Joyedo/paraent-website-/assets/images/history-decade-2000.png

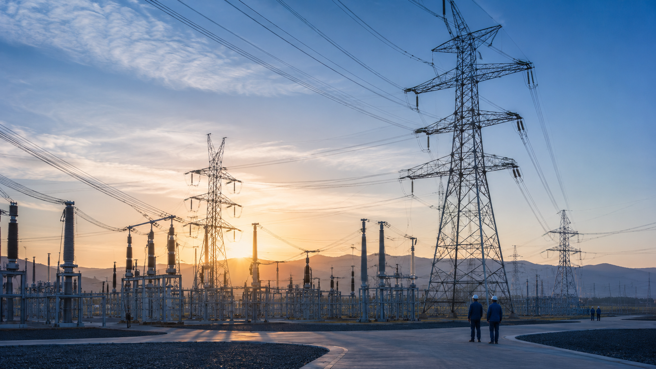
assets/images/history-decade-2000.png
