Joyedo/paraent-website-/assets/images/history-decade.png

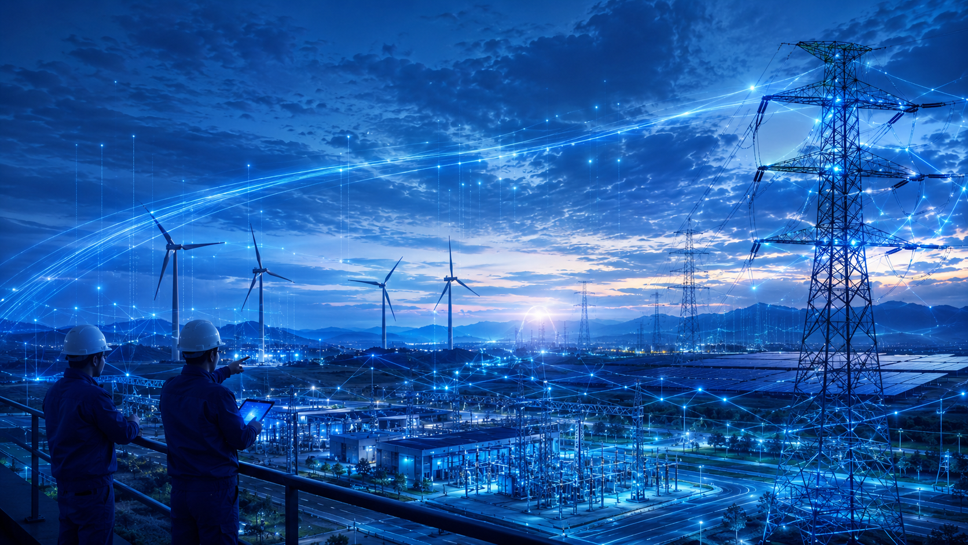
assets/images/history-decade.png
