Joyedo/paraent-website-/assets/certifications/patents/patent-design.pdf

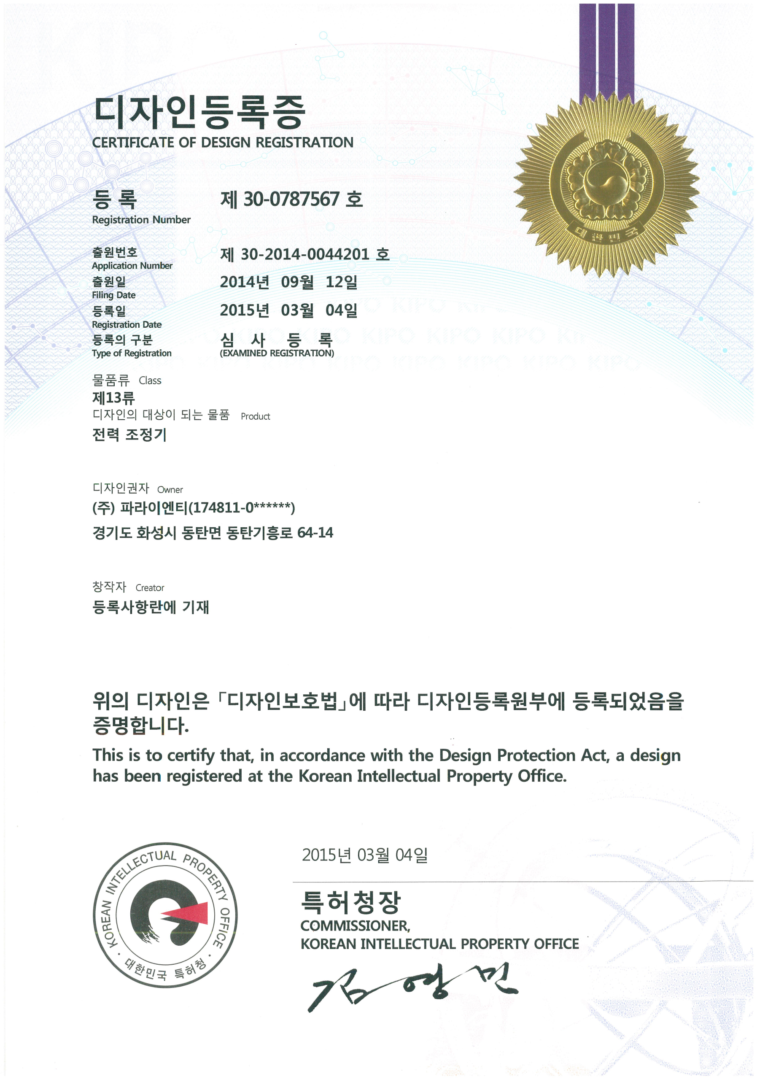
[picture p3: page 1]
