Joyedo/paraent-website-/assets/certifications/patents/patent-mpd.pdf

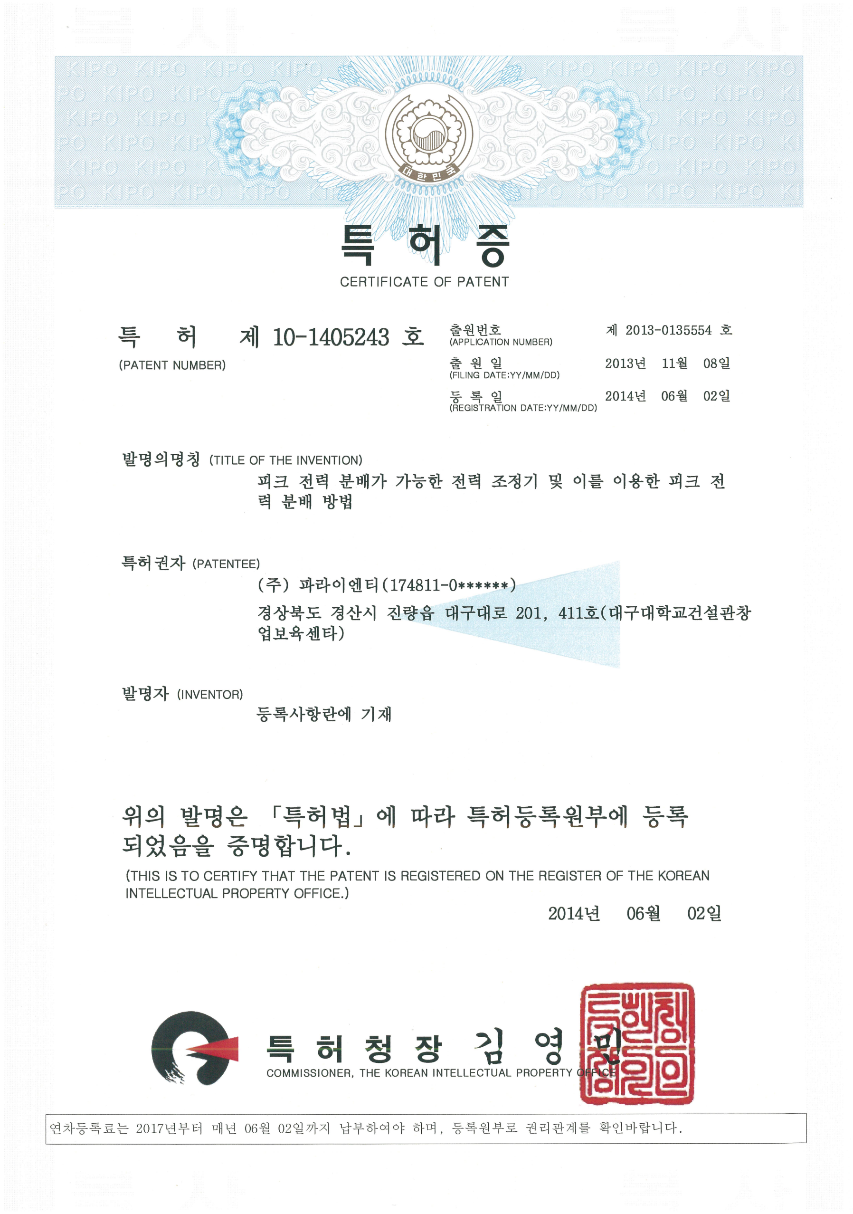
[picture p4: page 1]
