Joyedo/paraent-website-/assets/certifications/patents/patent-multichannel.pdf

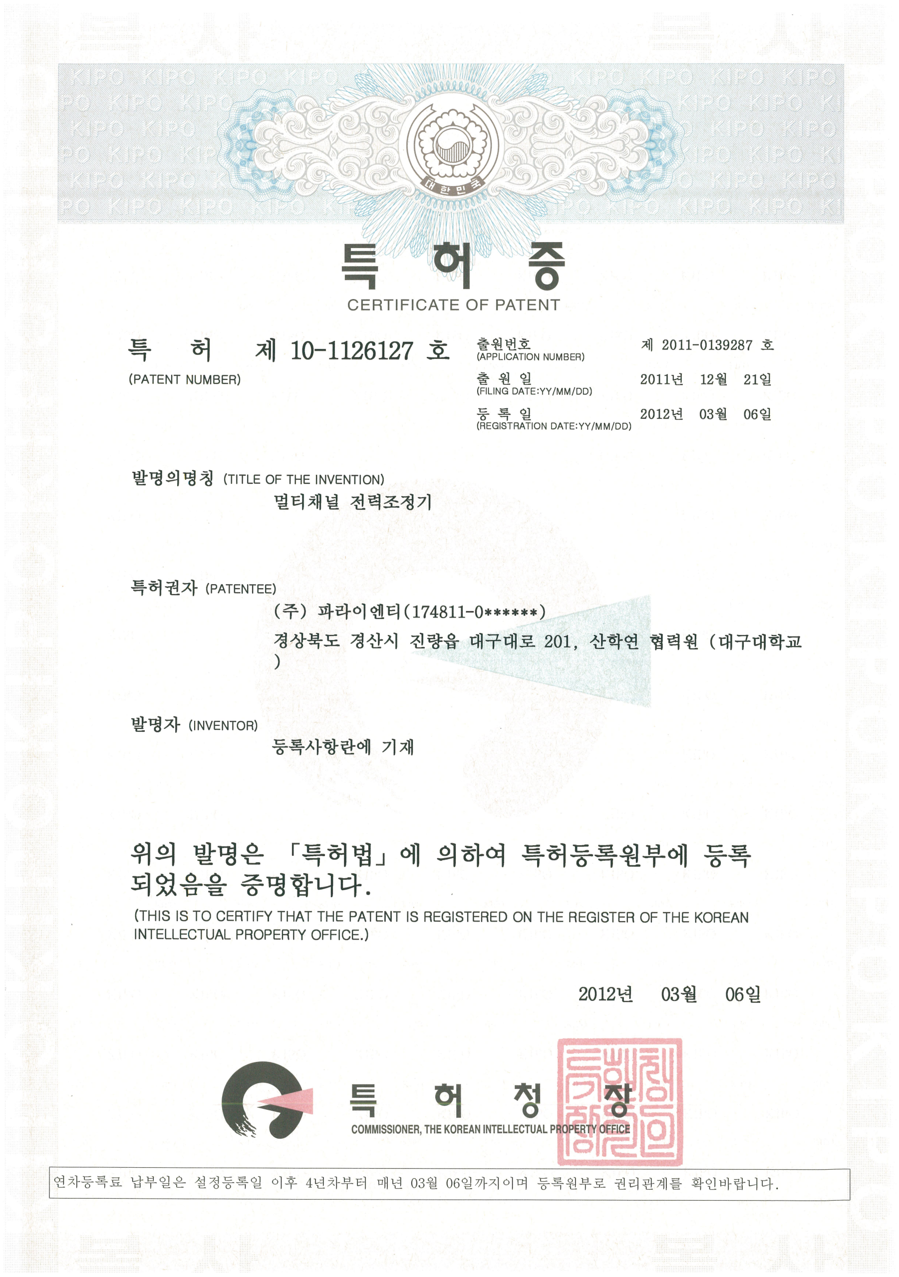
[picture p5: page 1]
