Joyedo/paraent-website-/assets/certifications/patents/patent-plf.pdf

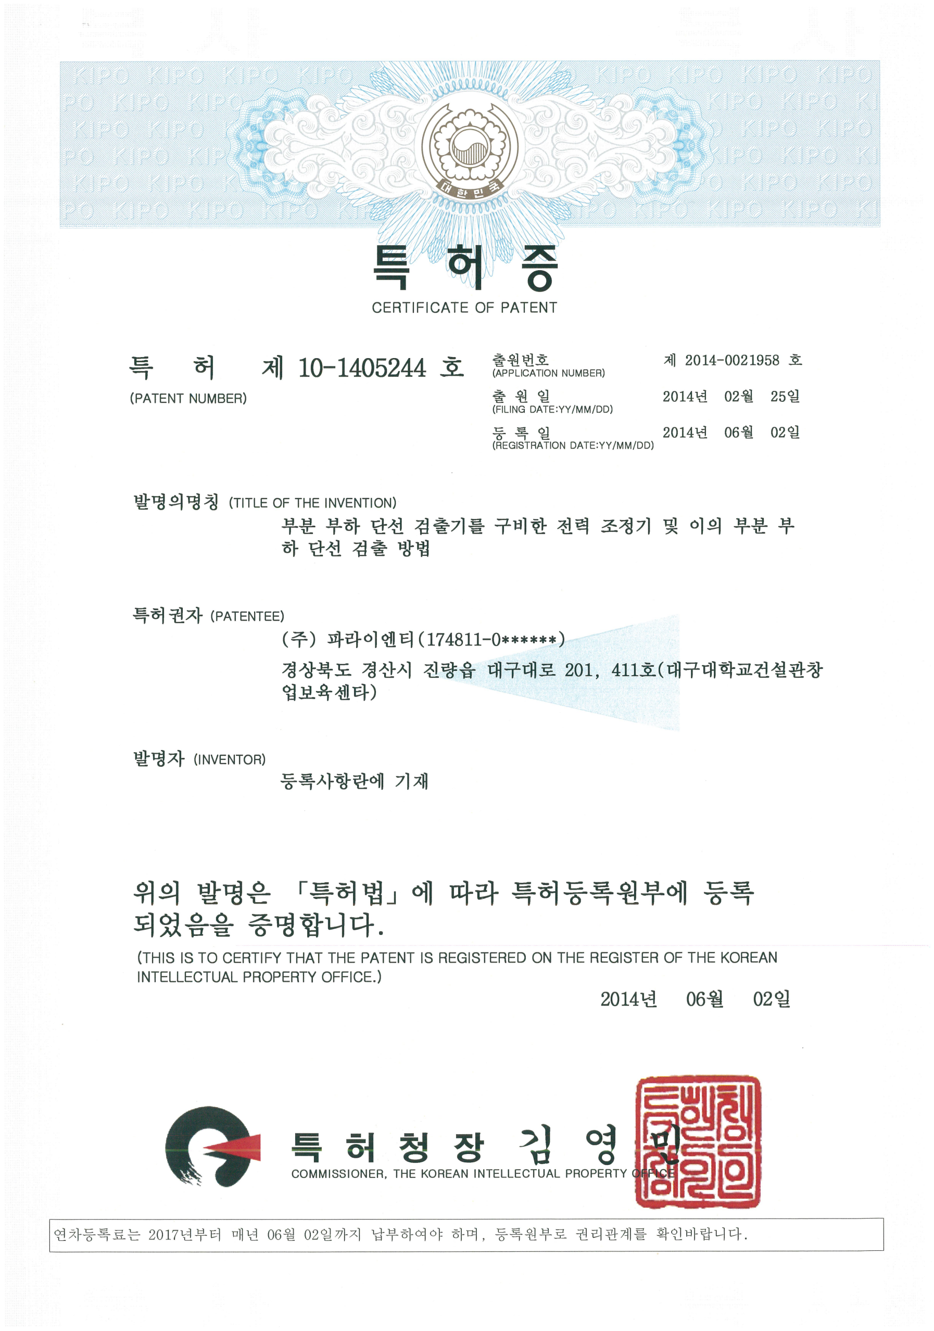
[picture p6: page 1]
