Joyedo/paraent-website-/assets/certifications/patents/patent-waveform-compensation.pdf

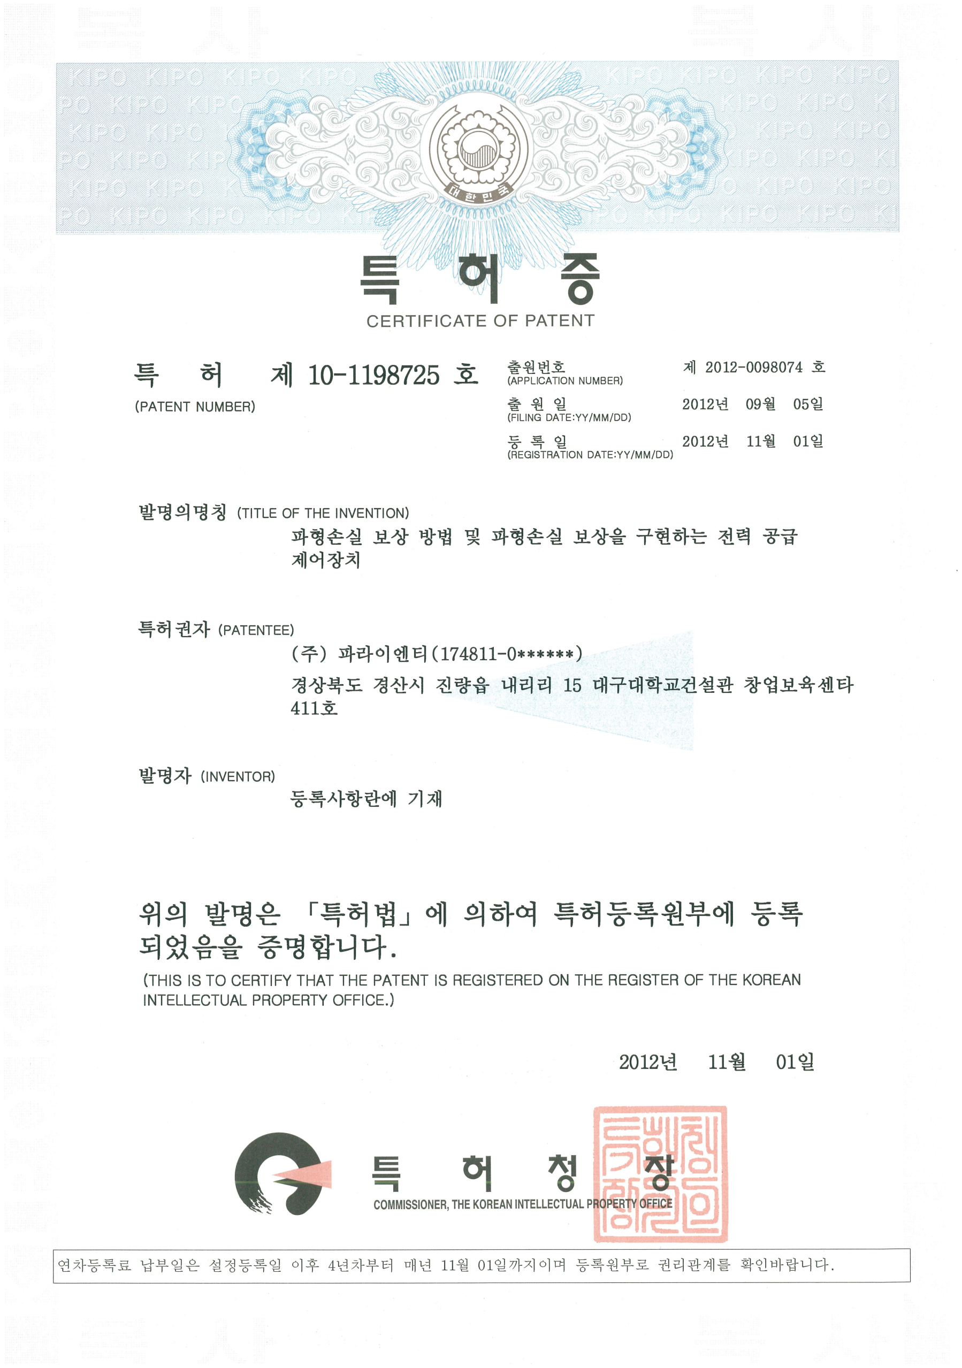
[picture p7: page 1]
