Joyedo/paraent-website-/assets/certifications/patents/trademark-en.pdf

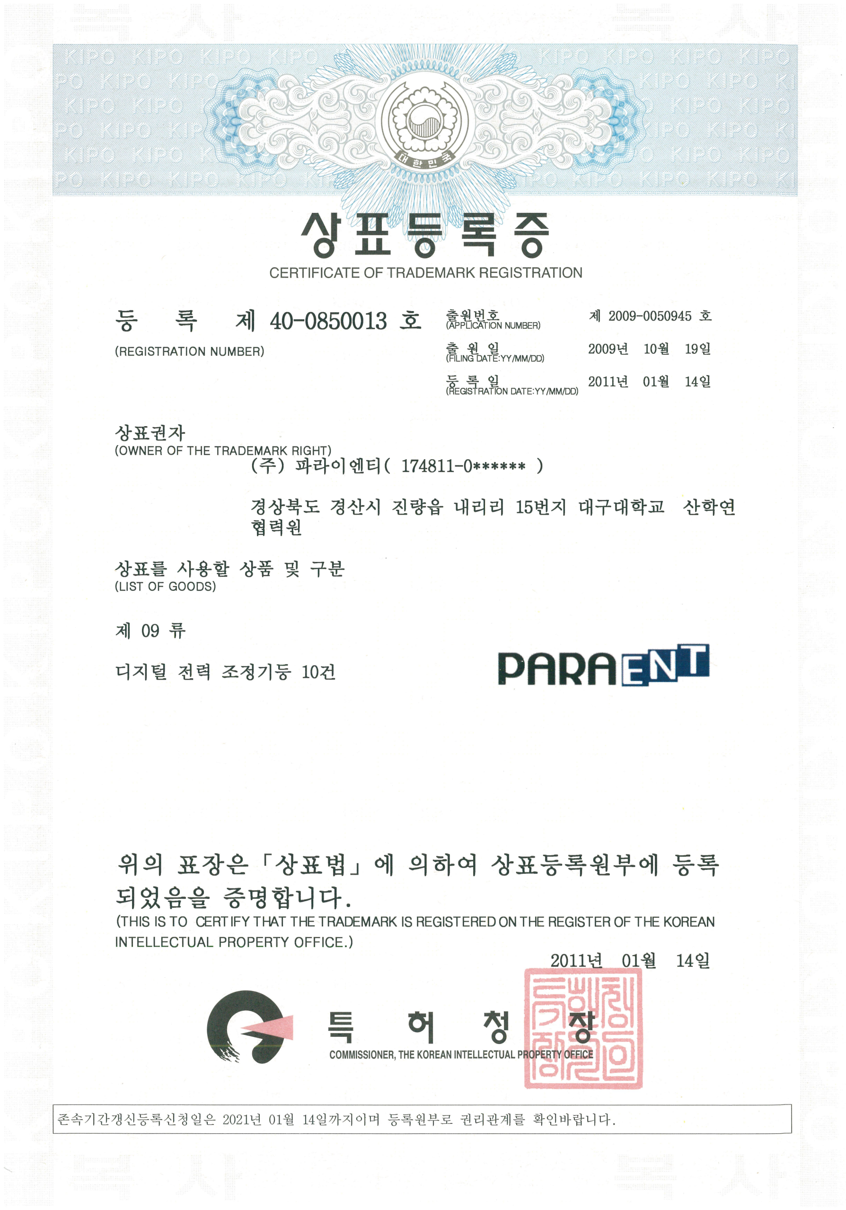
[picture p8: page 1]
