Joyedo/paraent-website-/assets/certifications/patents/trademark-ko.pdf

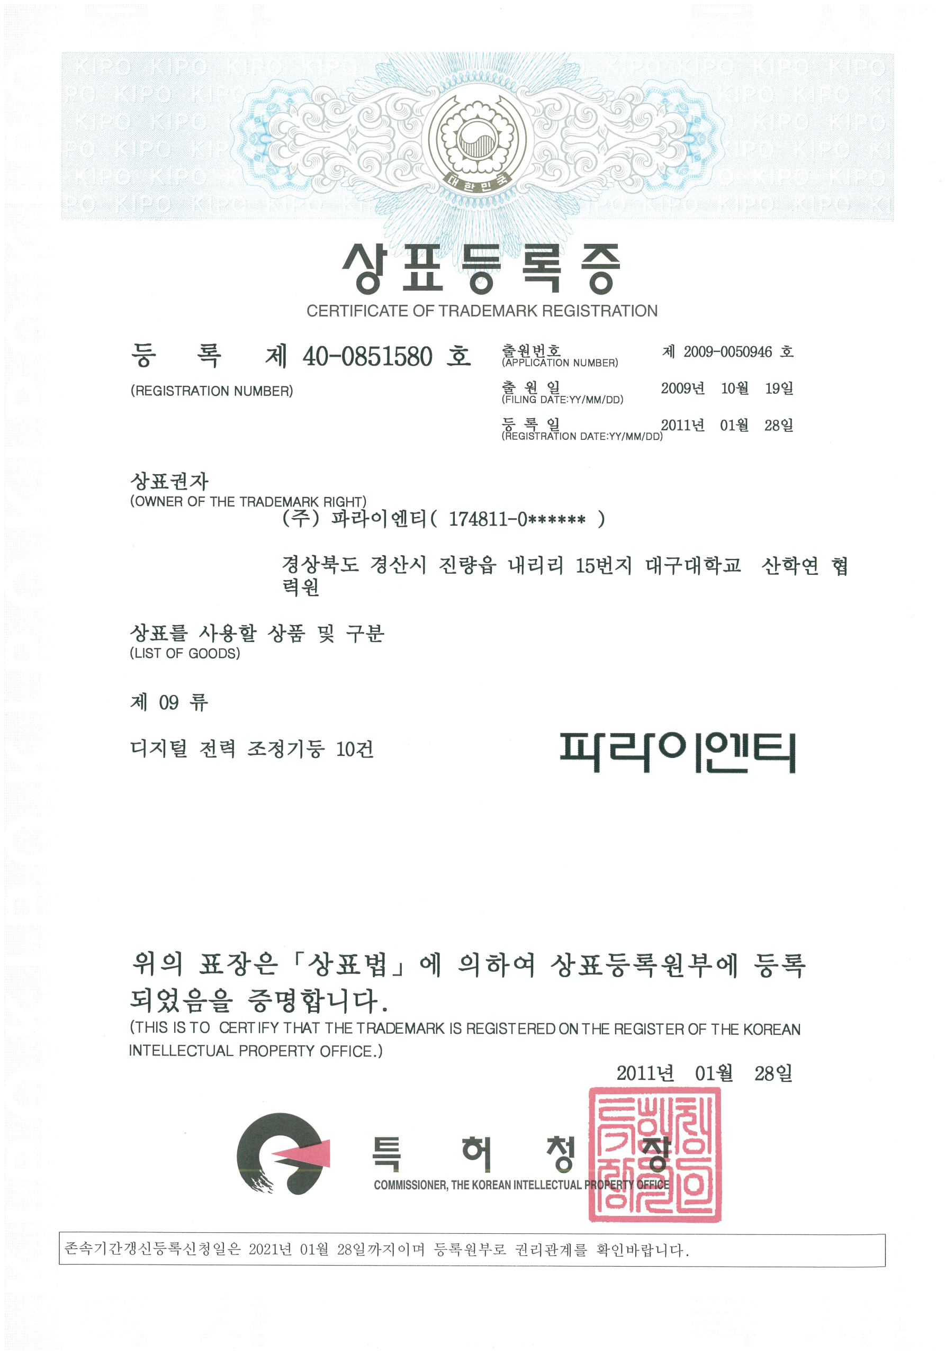
[picture p9: page 1]
