Joyedo/paraent-website-/assets/certifications/patents/patent-waveform.jpg

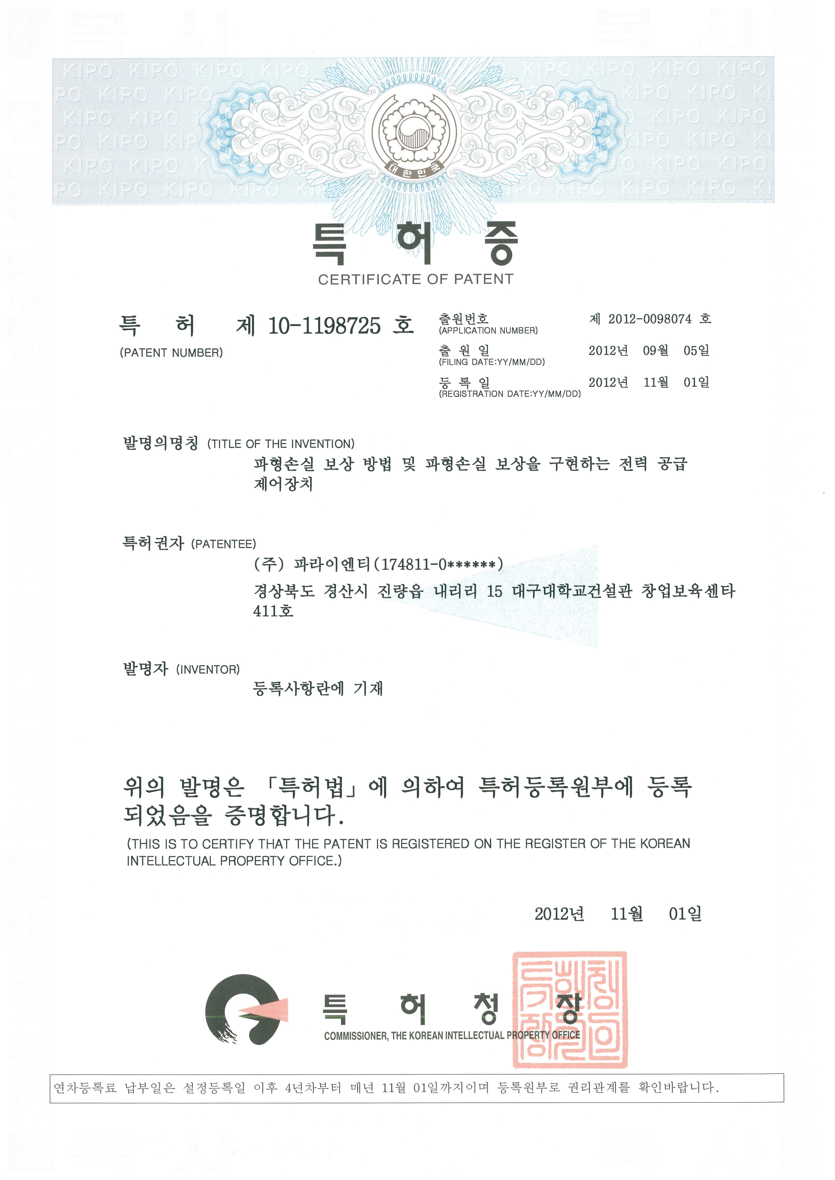
assets/certifications/patents/patent-waveform.jpg
