Joyedo/paraent-website-/assets/certifications/patents/trademark-ko.jpg

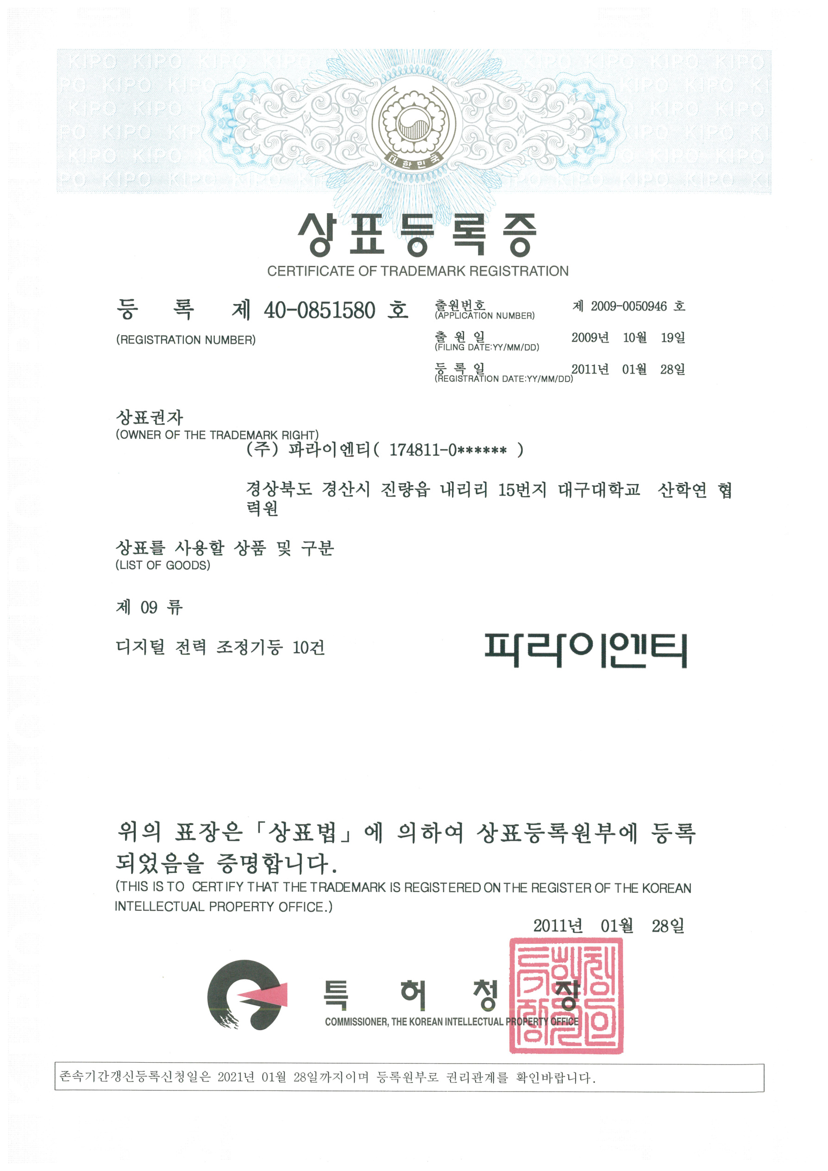
assets/certifications/patents/trademark-ko.jpg
