Joyedo/paraent-website-/assets/images/business-digital-power.png

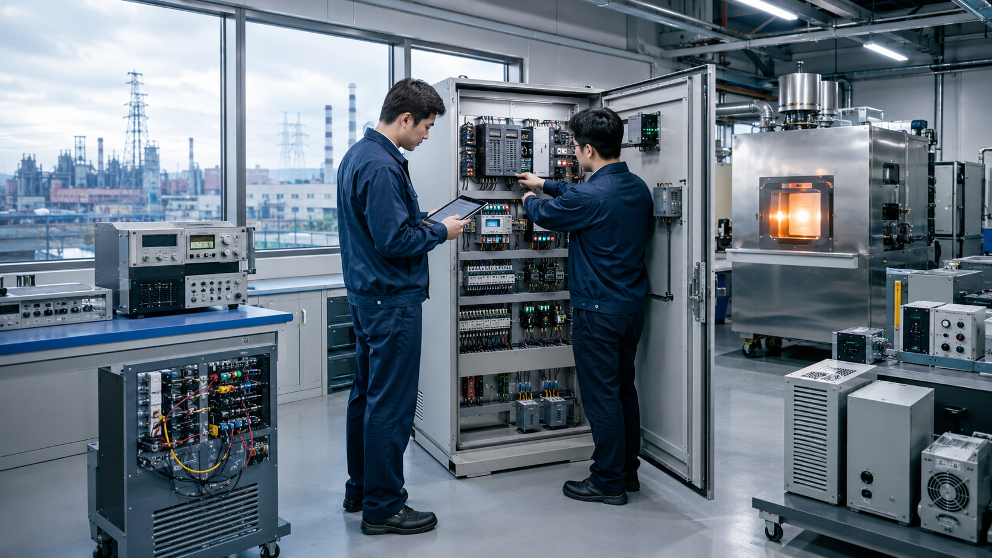
assets/images/business-digital-power.png
