Joyedo/paraent-website-/assets/images/business-power-electronics.png

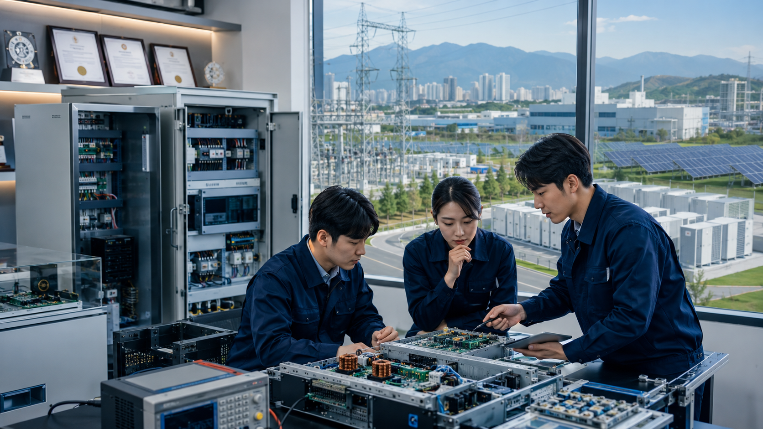
assets/images/business-power-electronics.png
