Joyedo/paraent-website-/assets/images/business-temperature-control.png

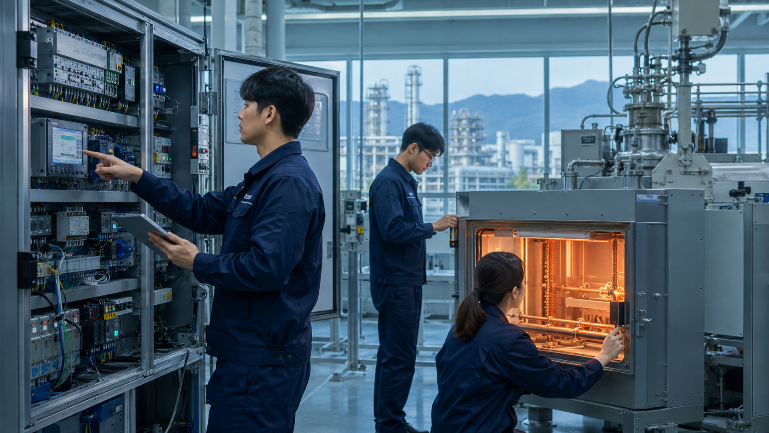
assets/images/business-temperature-control.png
