Joyedo/paraent-website-/assets/images/certifications/ce/ce-etype-1.jpg

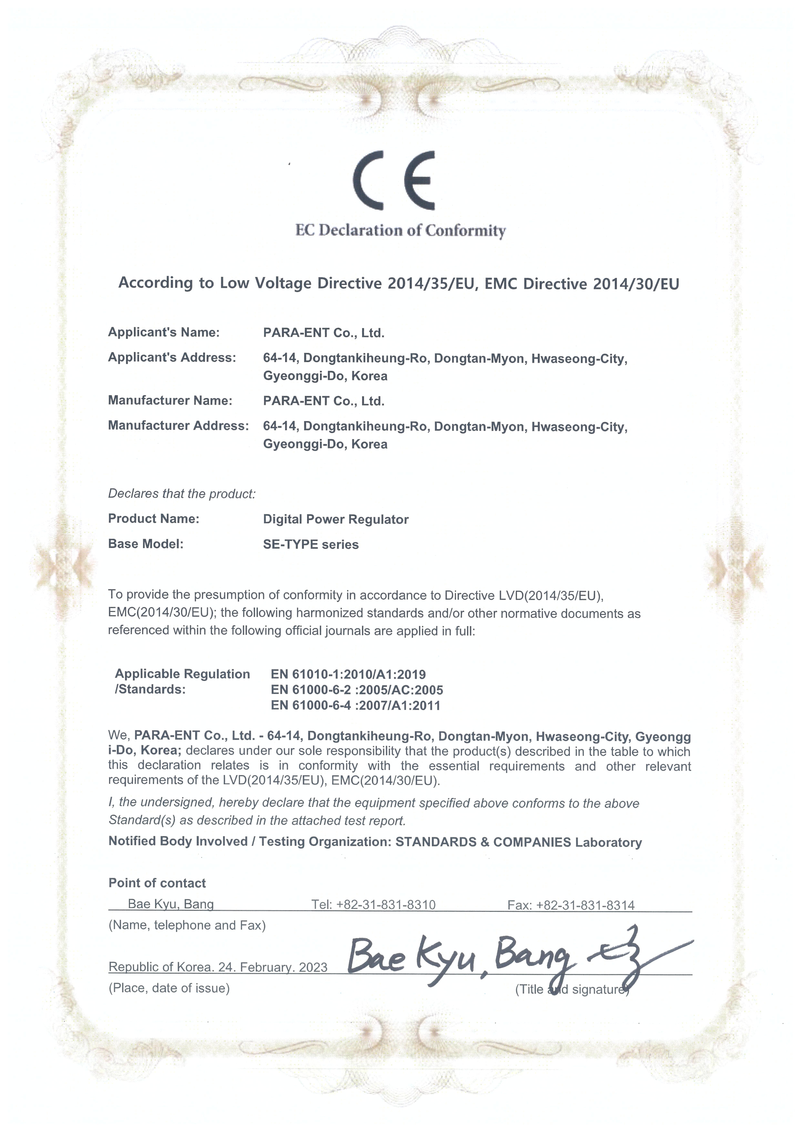
assets/images/certifications/ce/ce-etype-1.jpg
