Joyedo/paraent-website-/assets/images/certifications/ce/ce-flex-1.jpg

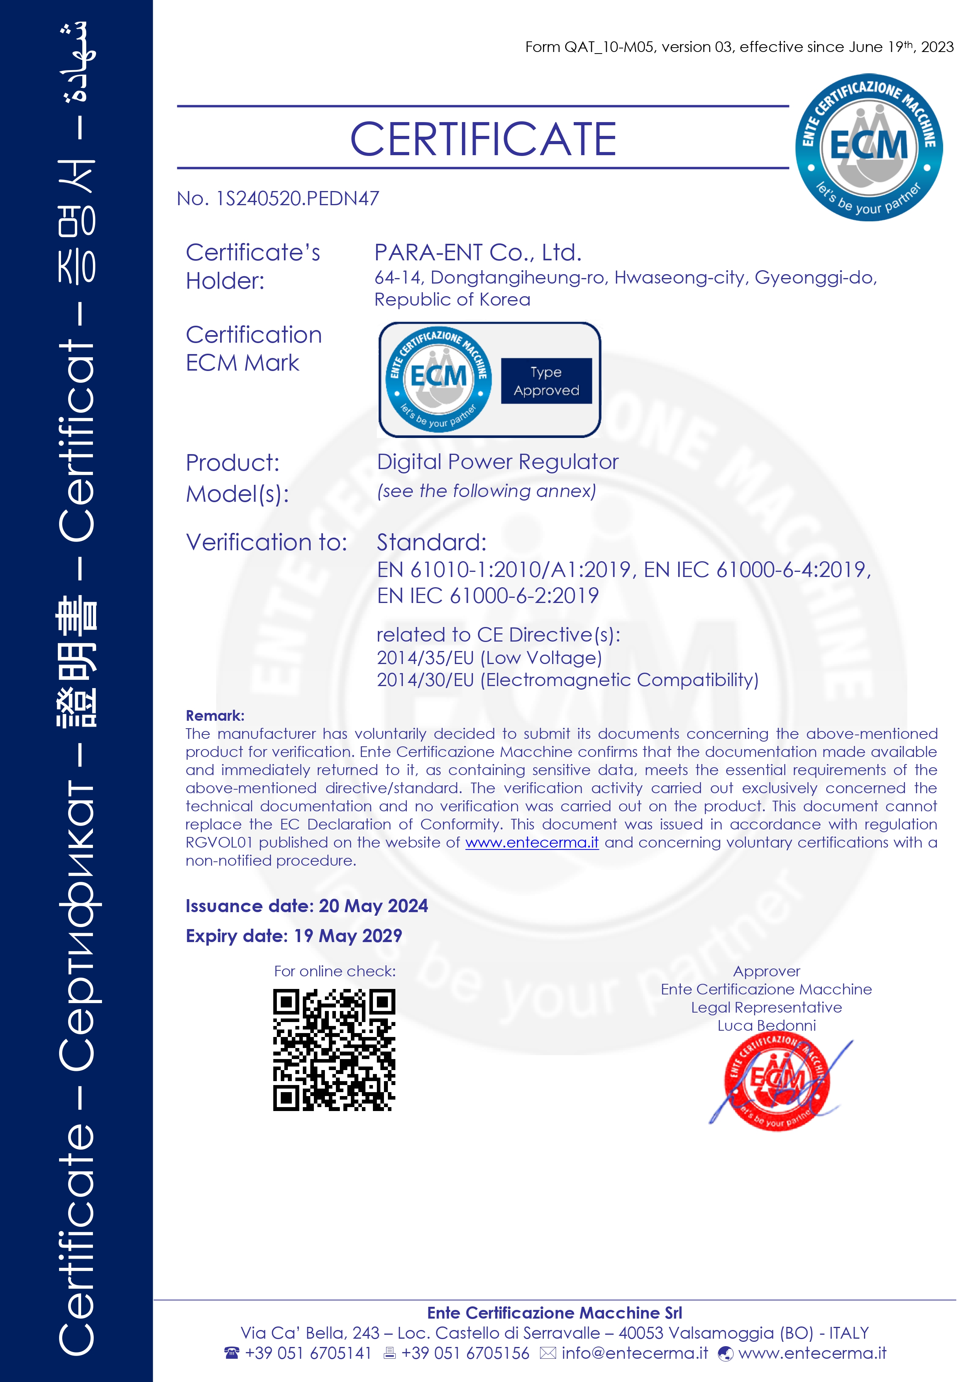
assets/images/certifications/ce/ce-flex-1.jpg
