Joyedo/paraent-website-/assets/images/certifications/ce/ce-flex-2.jpg

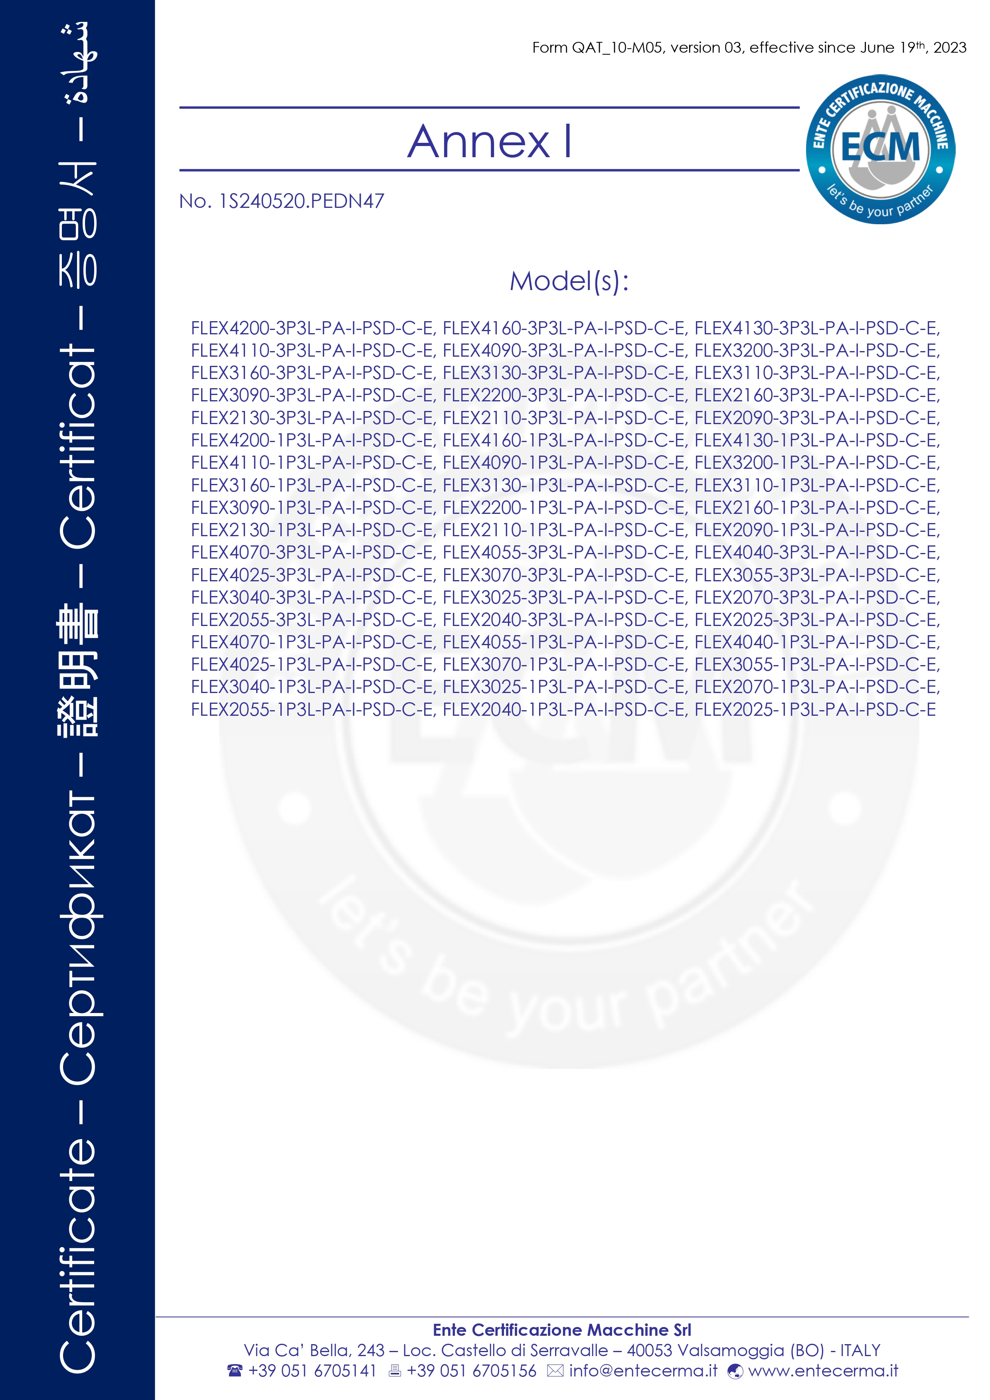
assets/images/certifications/ce/ce-flex-2.jpg
