Joyedo/paraent-website-/assets/images/certifications/ce/ce-pii-1.jpg

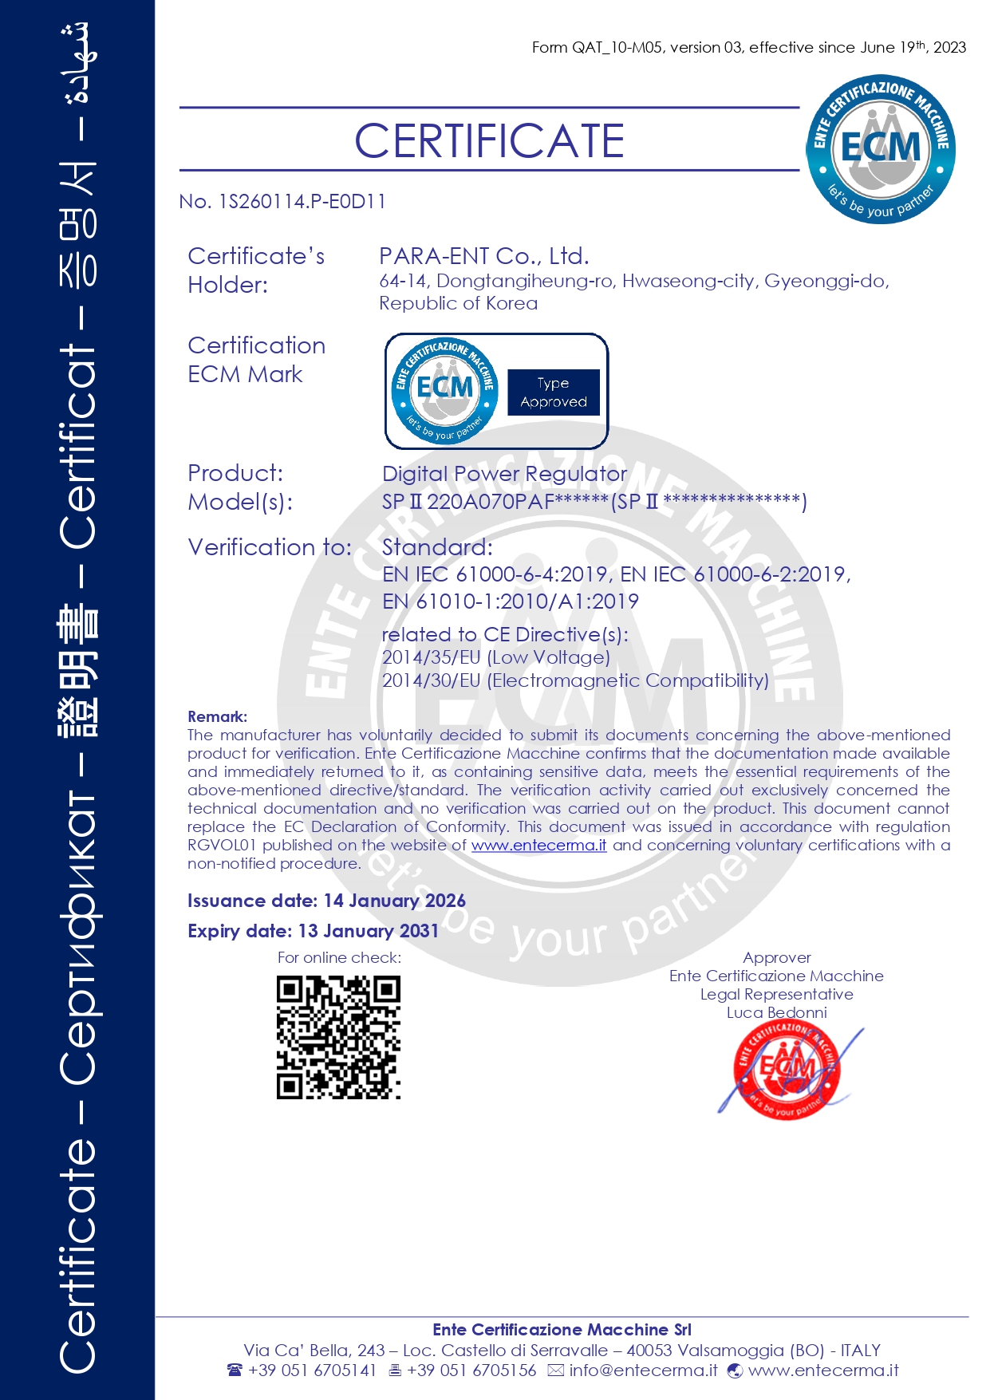
assets/images/certifications/ce/ce-pii-1.jpg
