Joyedo/paraent-website-/assets/images/certifications/ce/ce-ptype-1.jpg

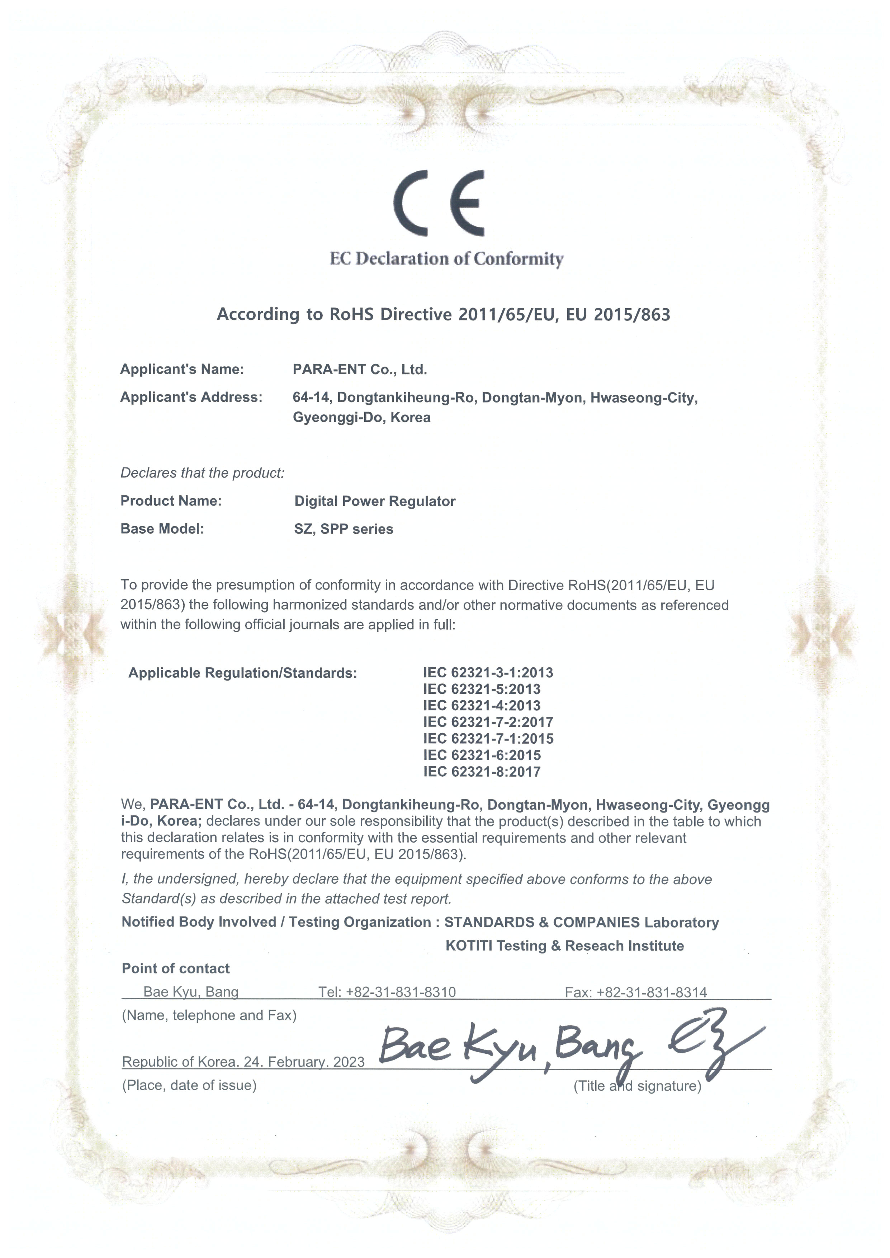
assets/images/certifications/ce/ce-ptype-1.jpg
