Joyedo/paraent-website-/assets/images/certifications/ce/ce-ptype-3.jpg

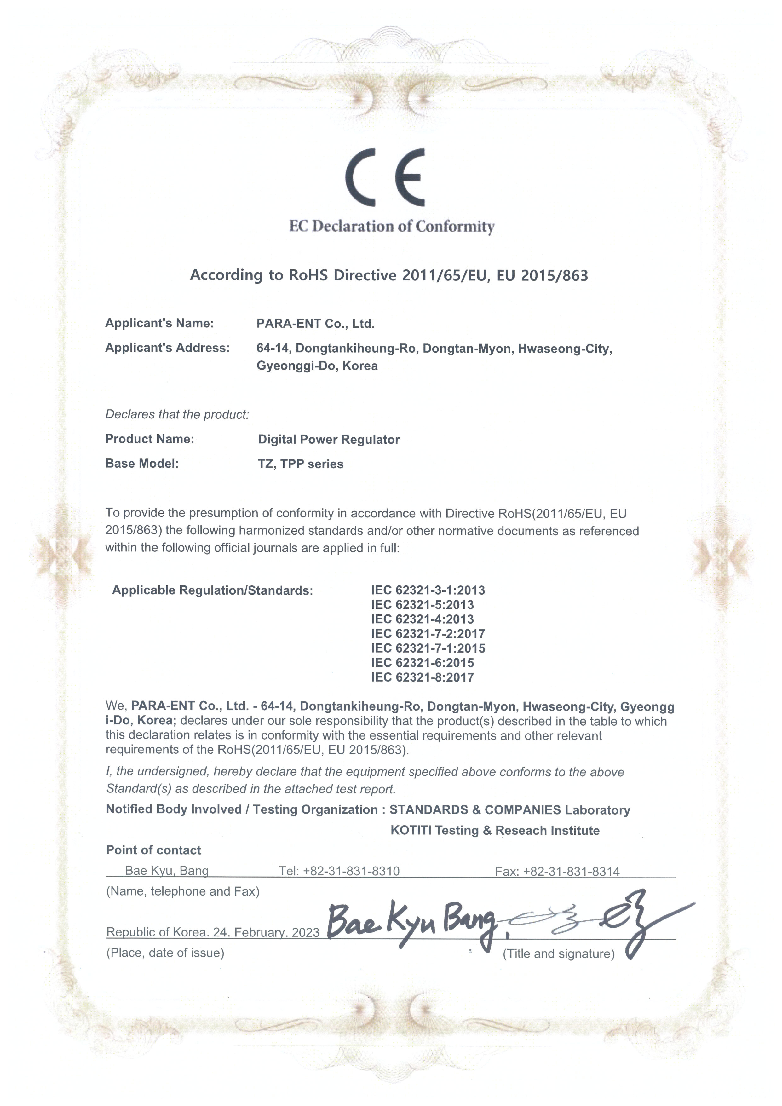
assets/images/certifications/ce/ce-ptype-3.jpg
