Joyedo/paraent-website-/assets/images/certifications/ce/ce-ptype-4.jpg

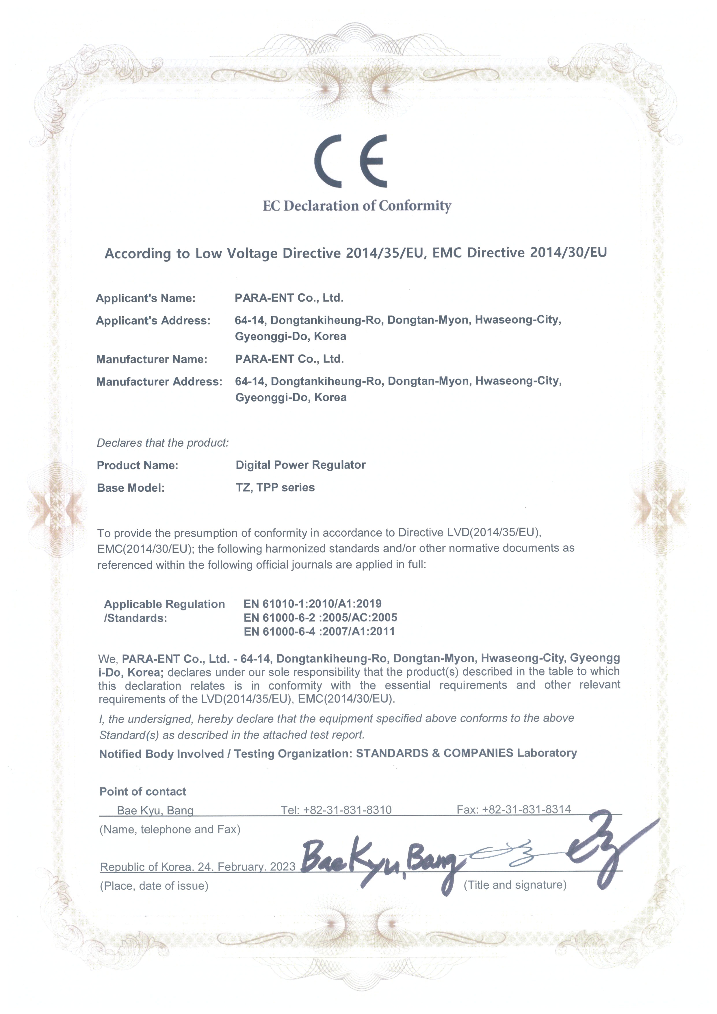
assets/images/certifications/ce/ce-ptype-4.jpg
