Joyedo/paraent-website-/assets/images/certifications/other/innobiz.jpg

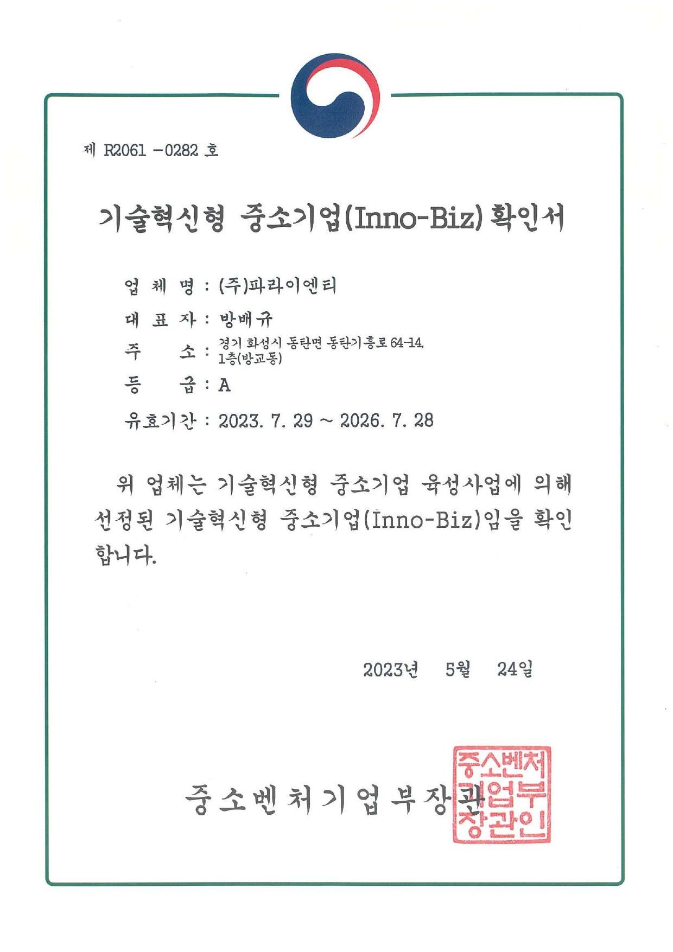
assets/images/certifications/other/innobiz.jpg
