Joyedo/paraent-website-/assets/images/certifications/other/iso-9001.jpg

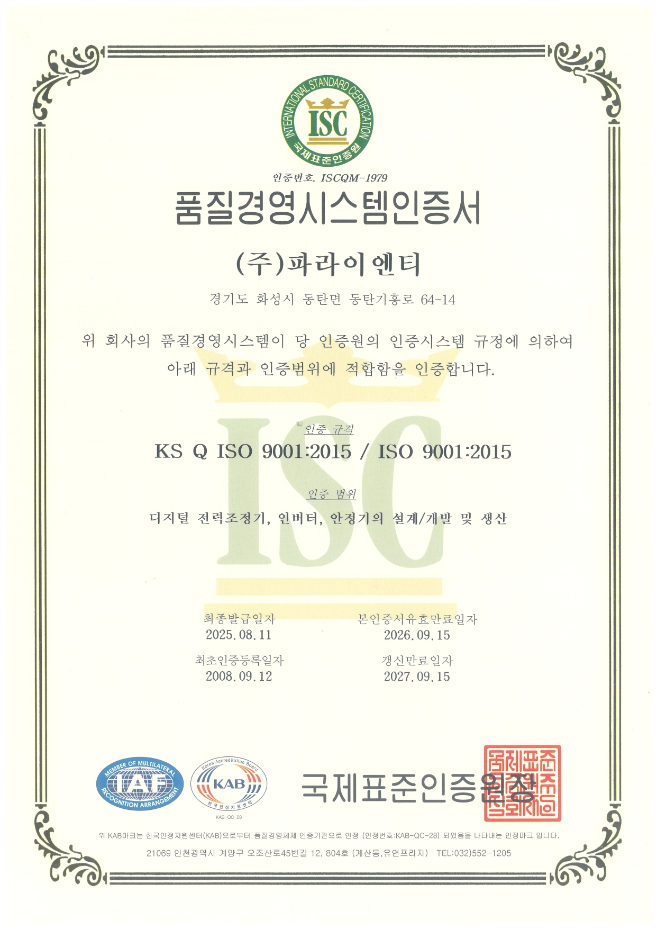
assets/images/certifications/other/iso-9001.jpg
