Joyedo/paraent-website-/assets/images/certifications/other/iso-14001.jpg

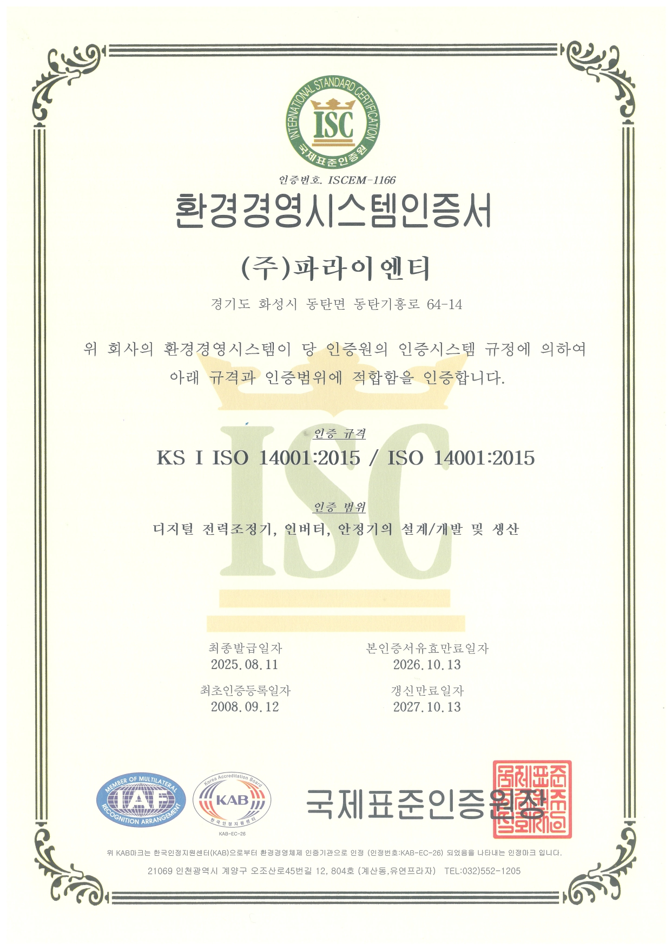
assets/images/certifications/other/iso-14001.jpg
