Joyedo/paraent-website-/assets/images/certifications/other/research-institute.jpg

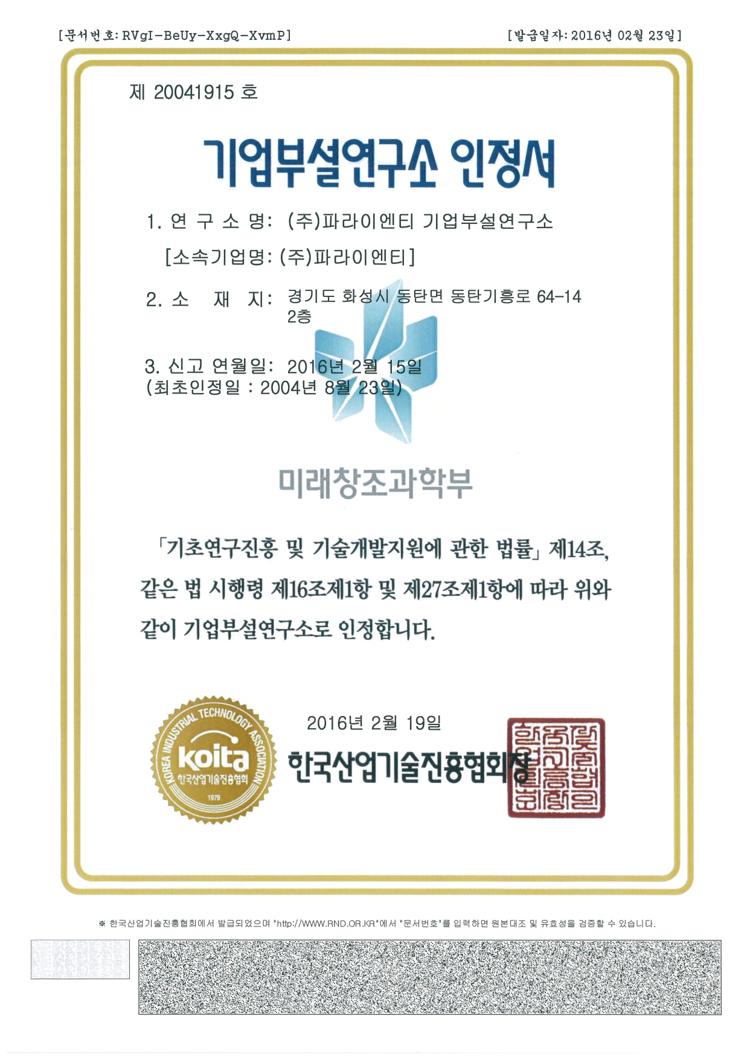
assets/images/certifications/other/research-institute.jpg
