Joyedo/paraent-website-/assets/images/certifications/other/venture.jpg

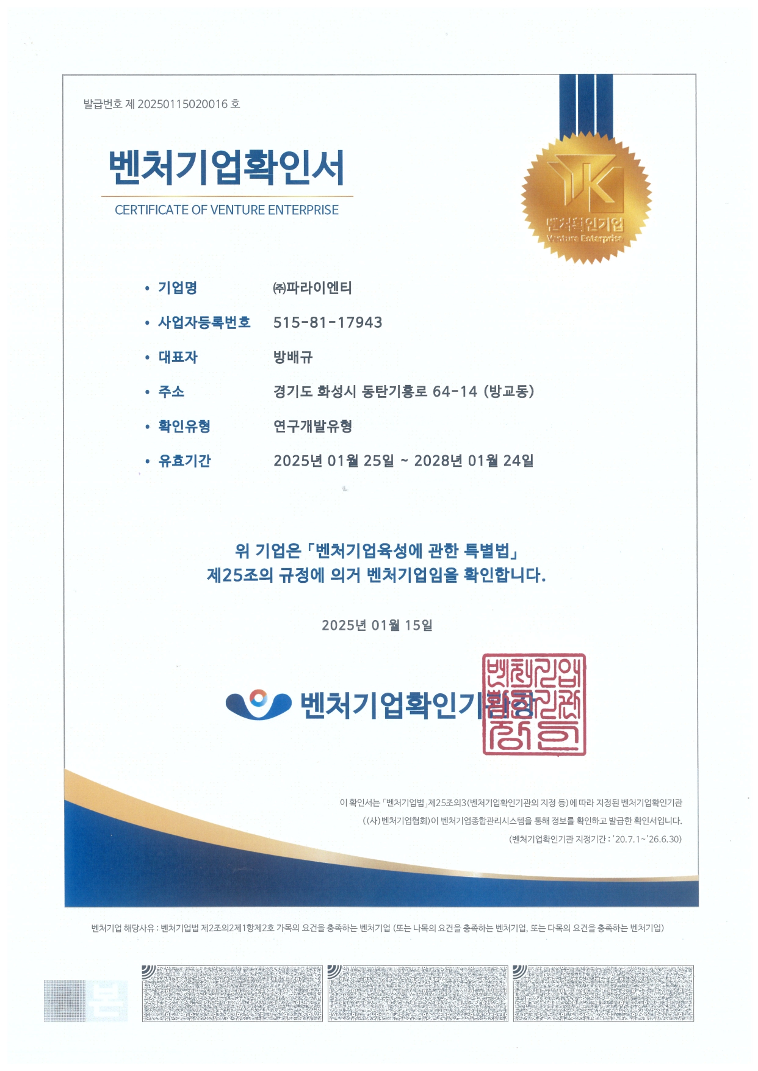
assets/images/certifications/other/venture.jpg
