Joyedo/paraent-website-/assets/images/certifications/ul/flex-ul-1.jpg

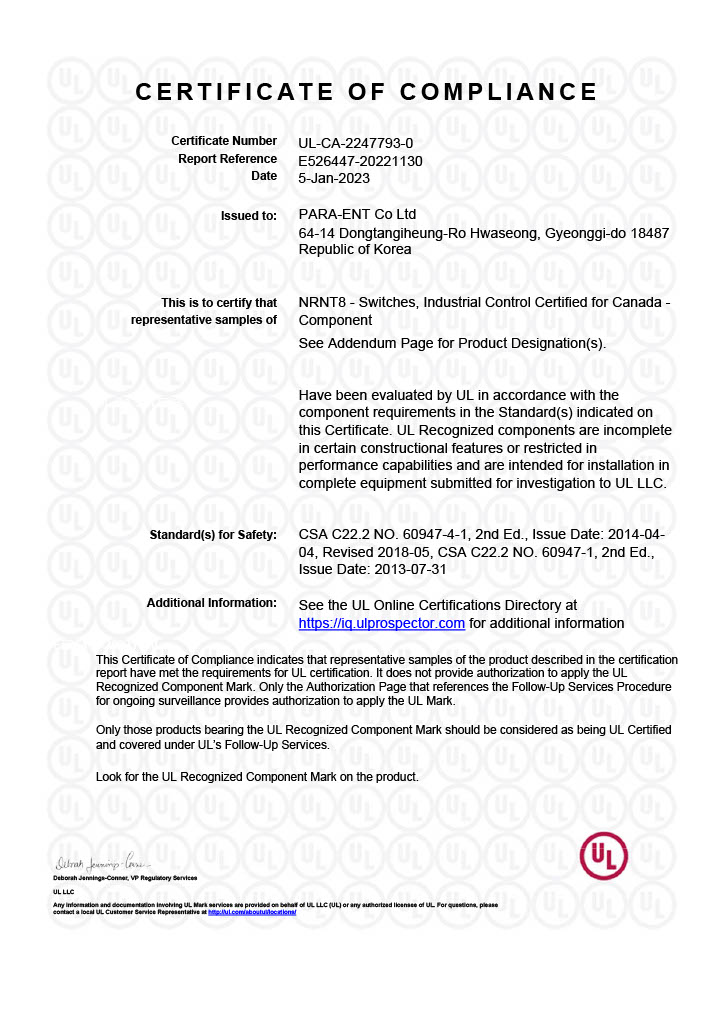
assets/images/certifications/ul/flex-ul-1.jpg
