Joyedo/paraent-website-/assets/images/certifications/ul/flex-ul-2.jpg

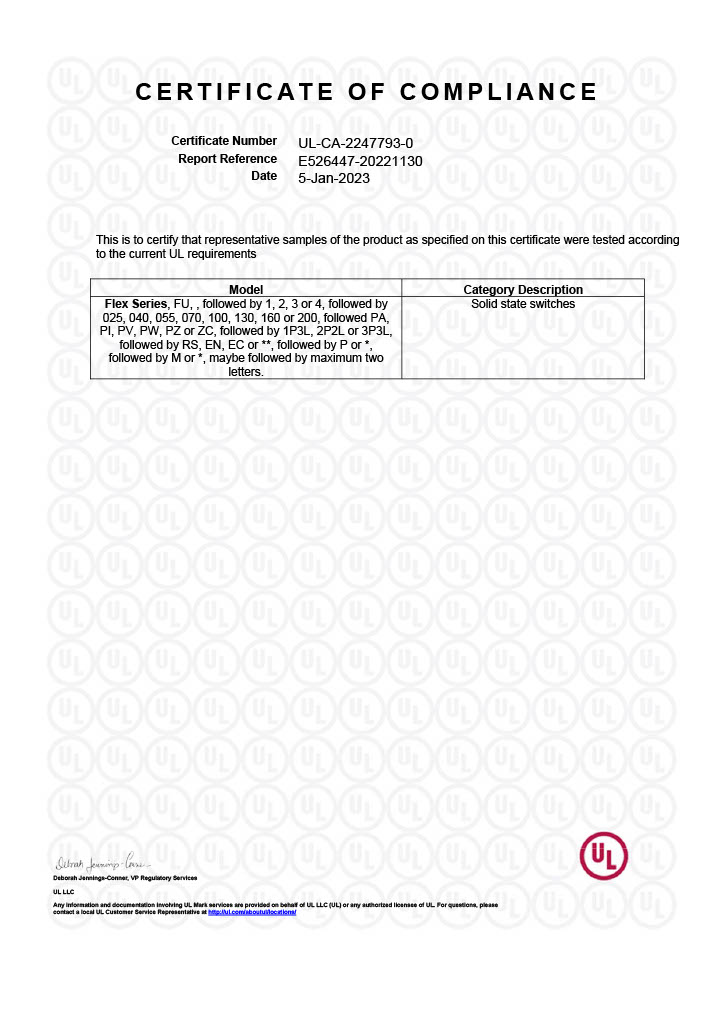
assets/images/certifications/ul/flex-ul-2.jpg
