Joyedo/paraent-website-/assets/images/certifications/ul/pii-ul-1.png

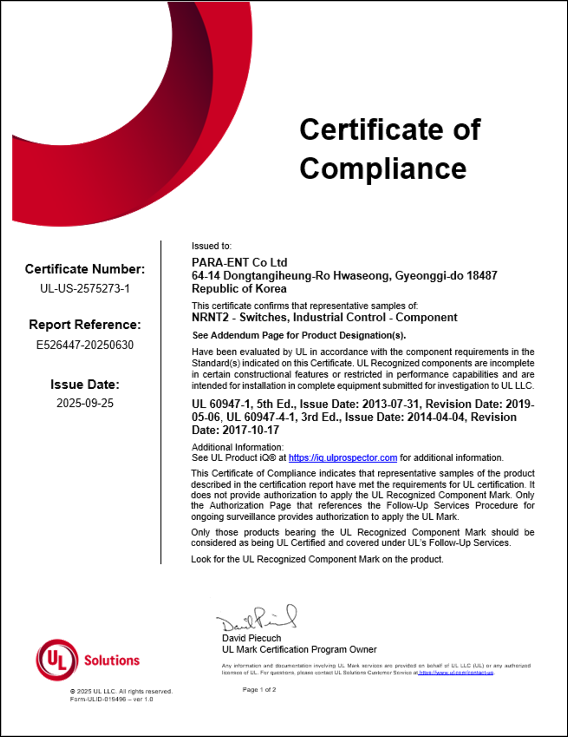
assets/images/certifications/ul/pii-ul-1.png
