Joyedo/paraent-website-/assets/images/certifications/ul/pii-ul-2.png

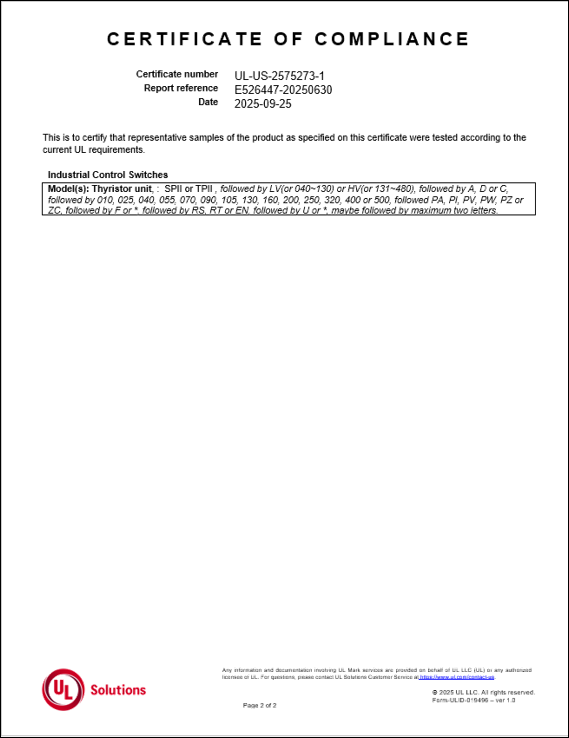
assets/images/certifications/ul/pii-ul-2.png
