Joyedo/paraent-website-/assets/images/certifications/ul/pii-ul-3.png

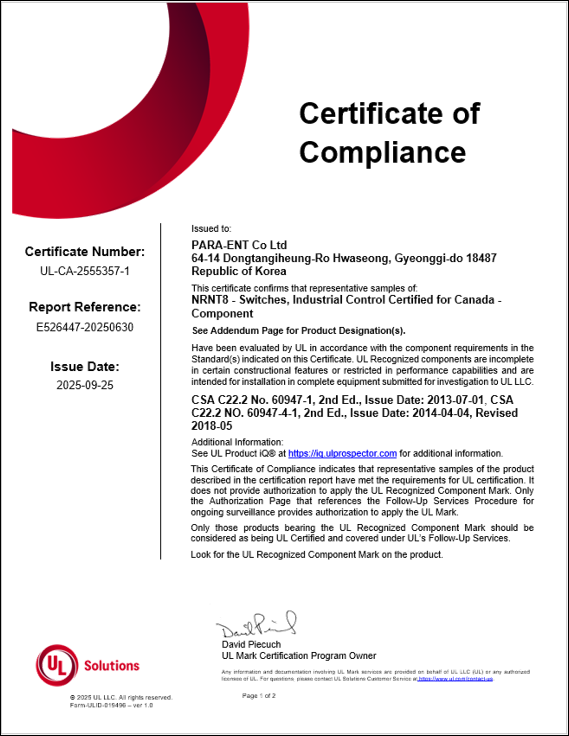
assets/images/certifications/ul/pii-ul-3.png
