Joyedo/paraent-website-/assets/images/certifications/ul/smart-ul-1.jpg

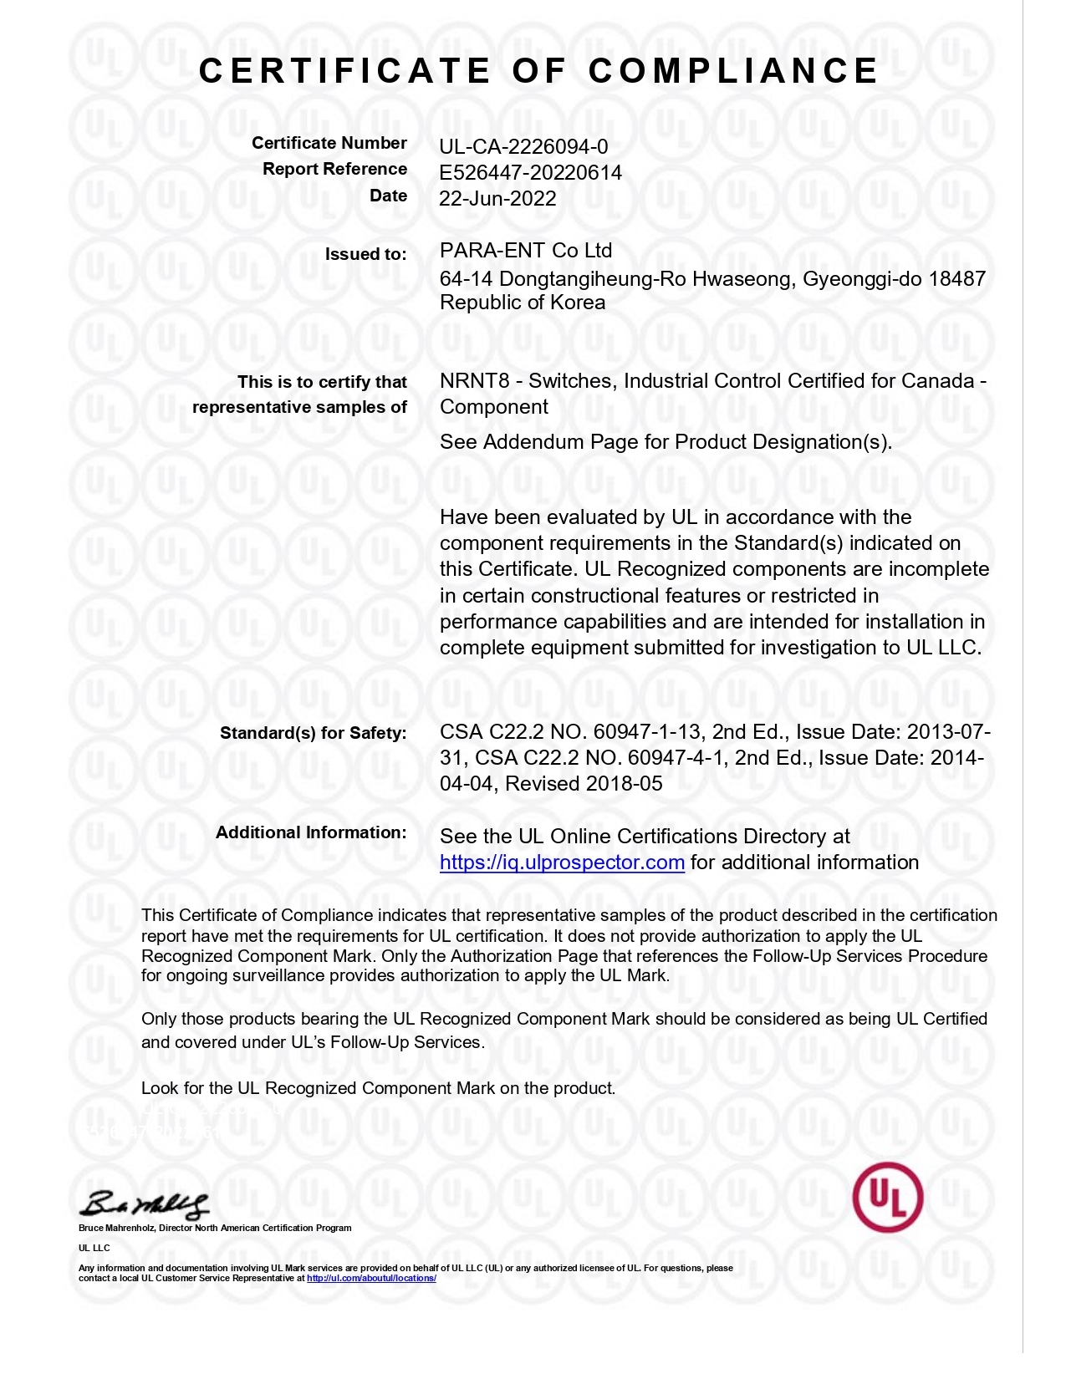
assets/images/certifications/ul/smart-ul-1.jpg
