Joyedo/paraent-website-/assets/images/certifications/ul/smart-ul-2.jpg

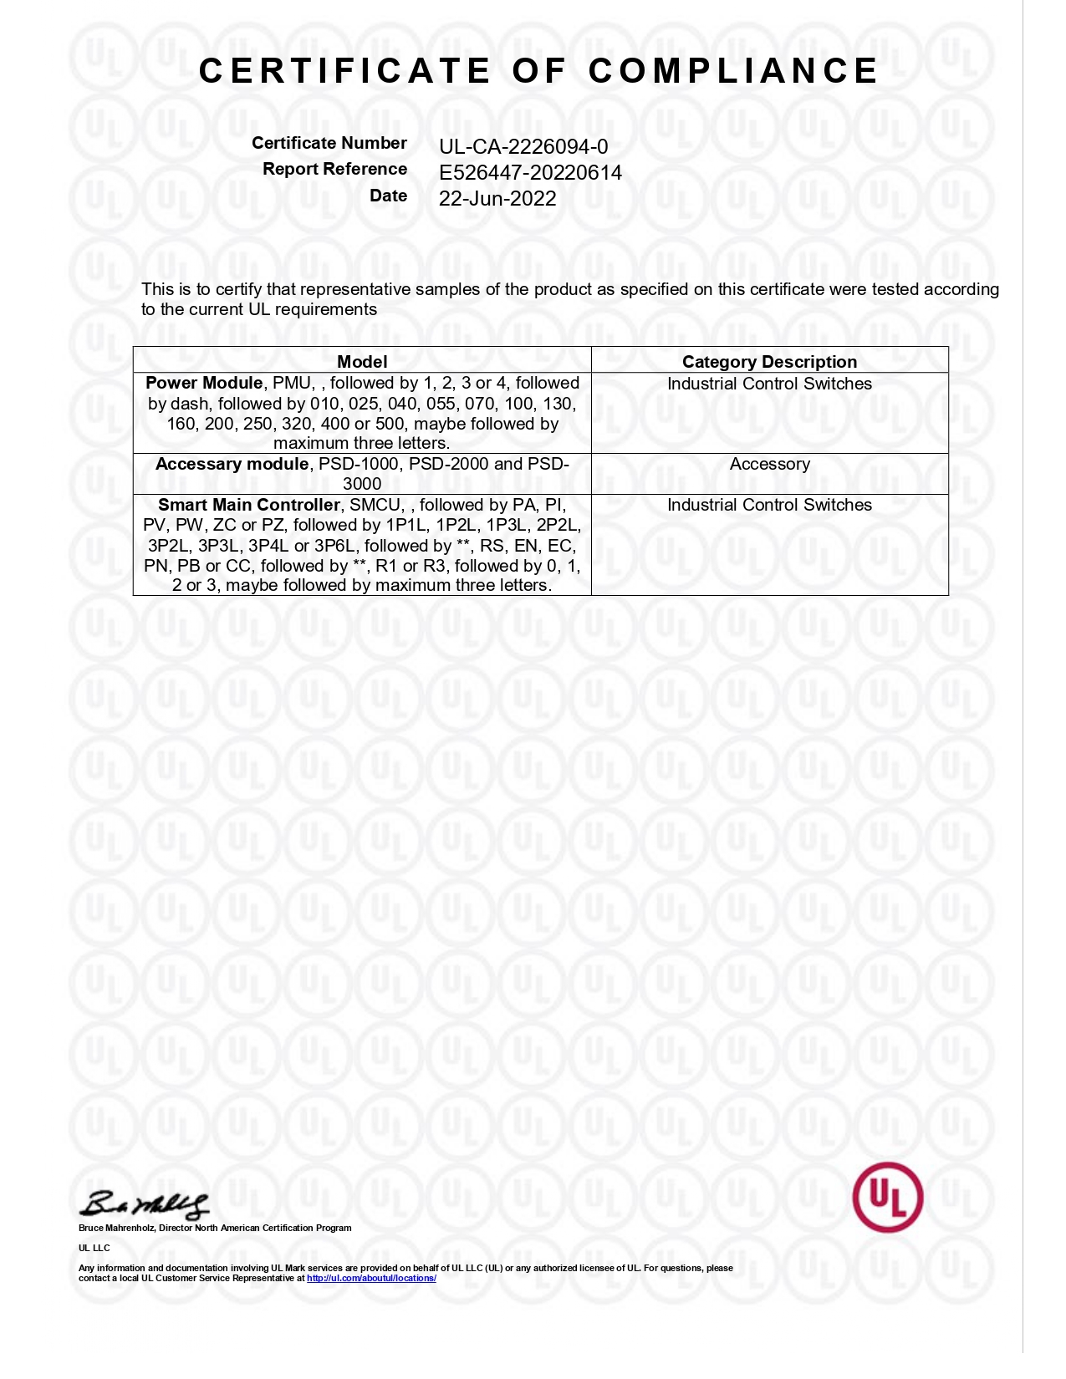
assets/images/certifications/ul/smart-ul-2.jpg
