Joyedo/paraent-website-/assets/images/company-intro.png

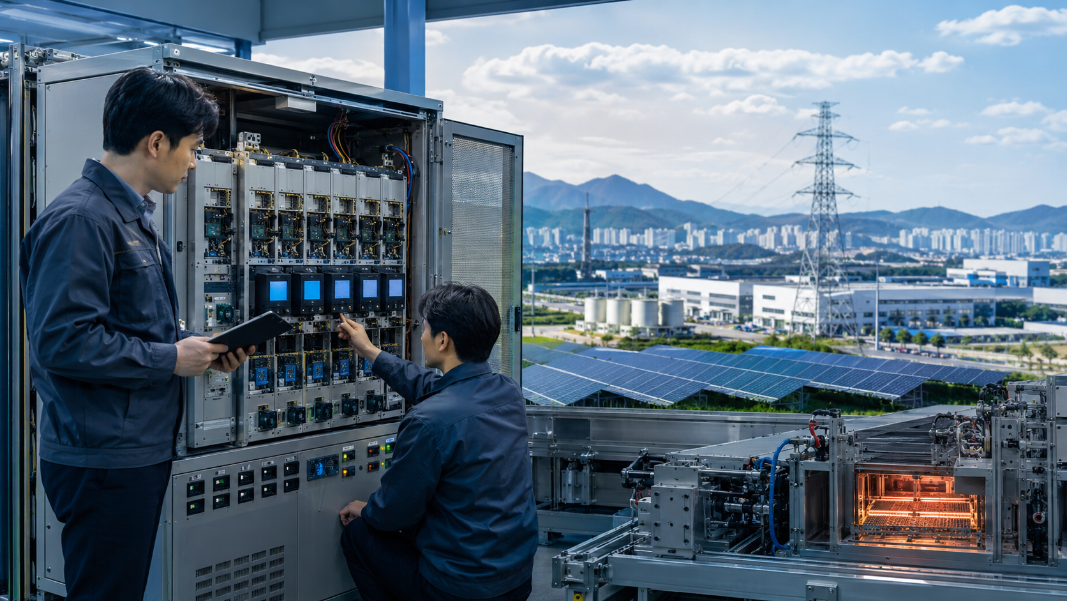
assets/images/company-intro.png
