Joyedo/paraent-website-/assets/images/hero-bg-etype.png

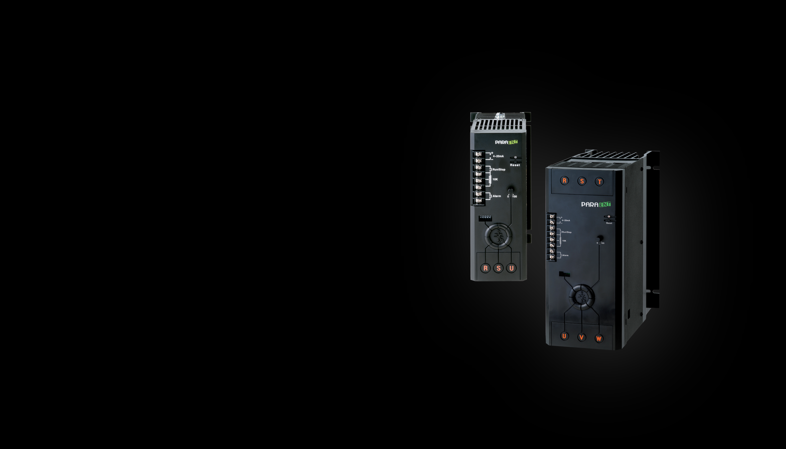
assets/images/hero-bg-etype.png
