Joyedo/paraent-website-/assets/images/hero-bg-flex.bak.png

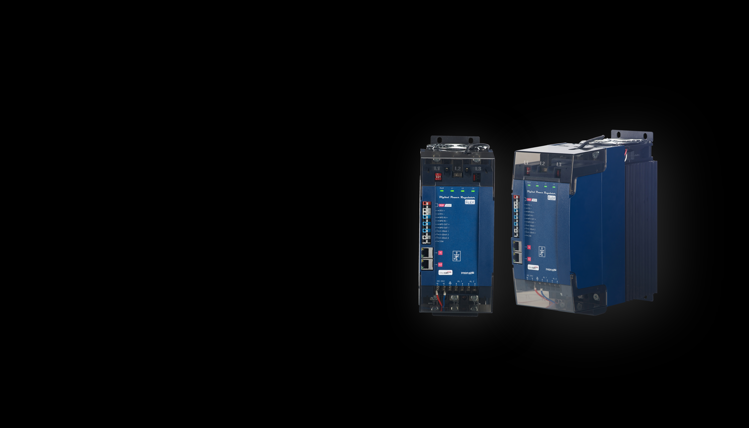
assets/images/hero-bg-flex.bak.png
