Joyedo/paraent-website-/assets/images/hero-bg-flex.png

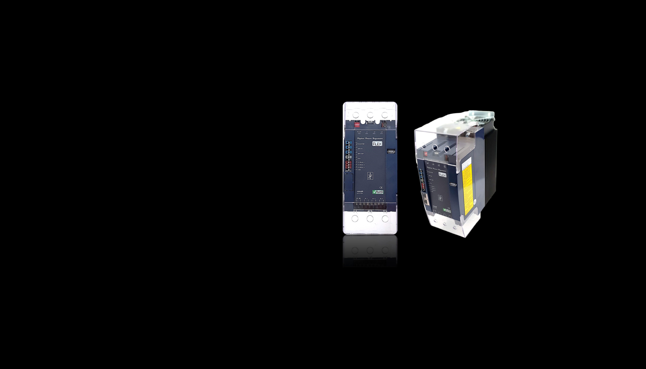
assets/images/hero-bg-flex.png
