Joyedo/paraent-website-/assets/images/hero-bg-mini.png

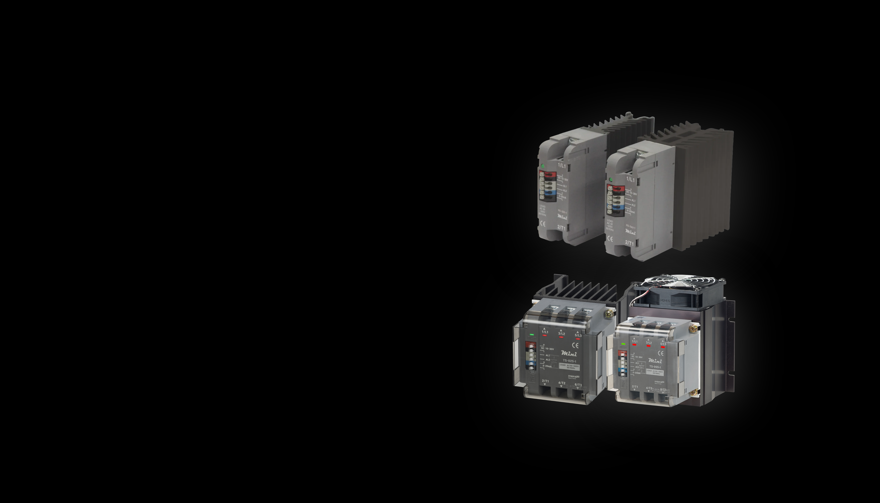
assets/images/hero-bg-mini.png
