Joyedo/paraent-website-/assets/images/hero-bg-multi.png

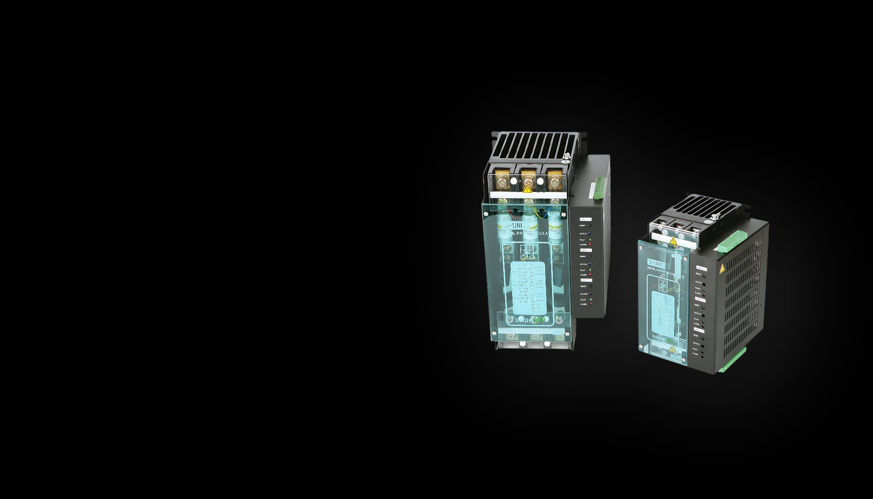
assets/images/hero-bg-multi.png
