Joyedo/paraent-website-/assets/images/hero-bg-ptype.png

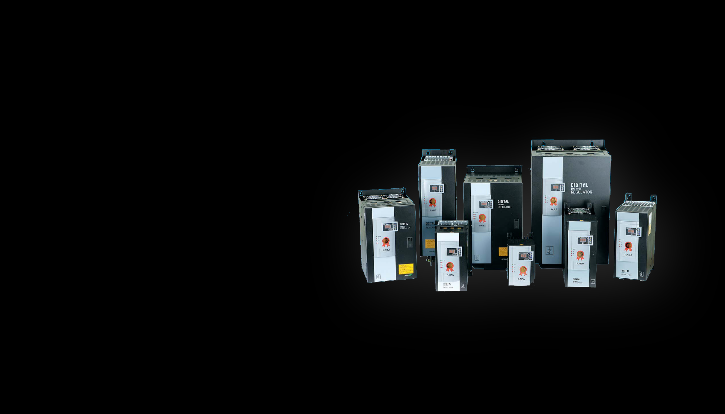
assets/images/hero-bg-ptype.png
