Joyedo/paraent-website-/assets/images/hero-bg-smart.bak.png

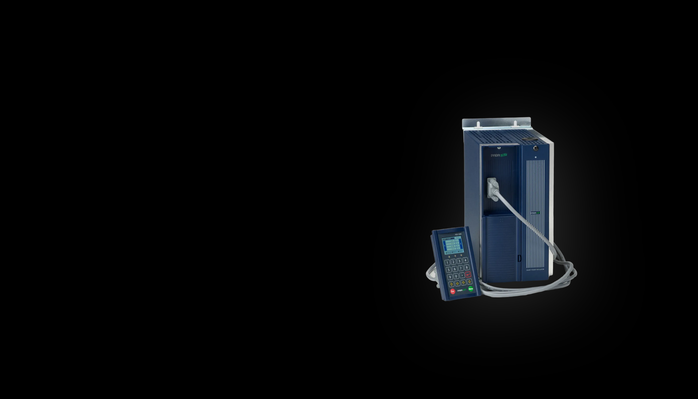
assets/images/hero-bg-smart.bak.png
