Joyedo/paraent-website-/assets/images/hero-bg-smart.png

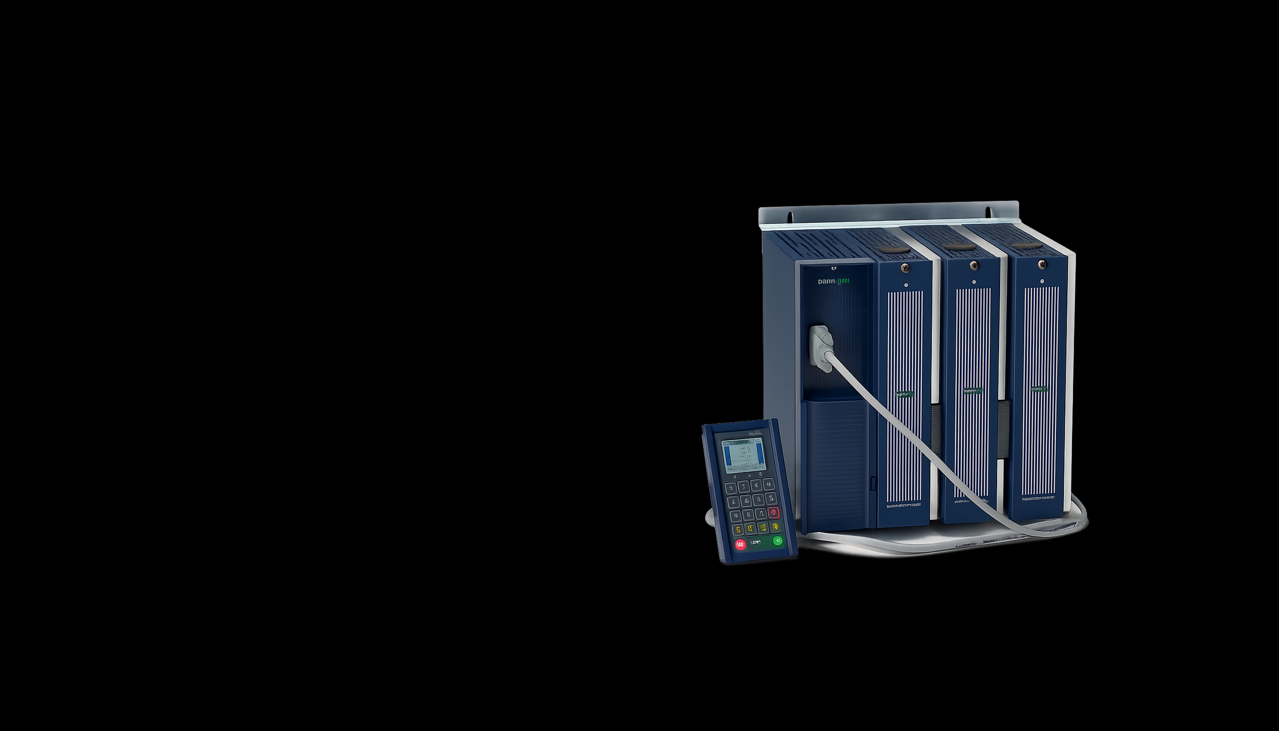
assets/images/hero-bg-smart.png
