Joyedo/paraent-website-/assets/images/hero-bg.png

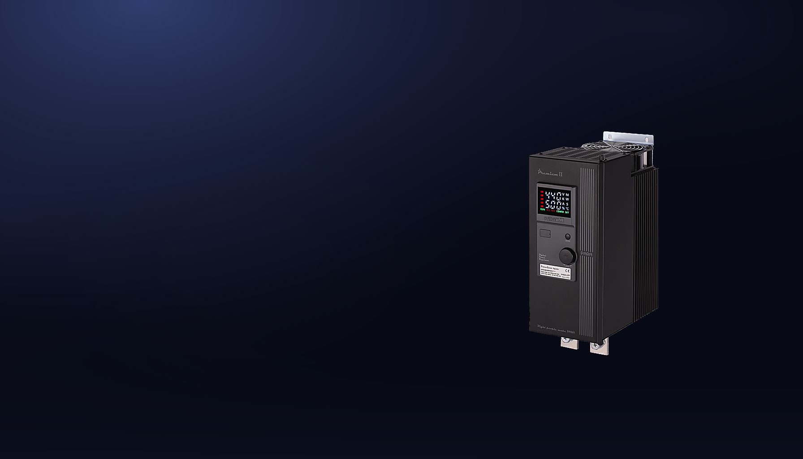
assets/images/hero-bg.png
