Joyedo/paraent-website-/assets/images/og-image.jpg

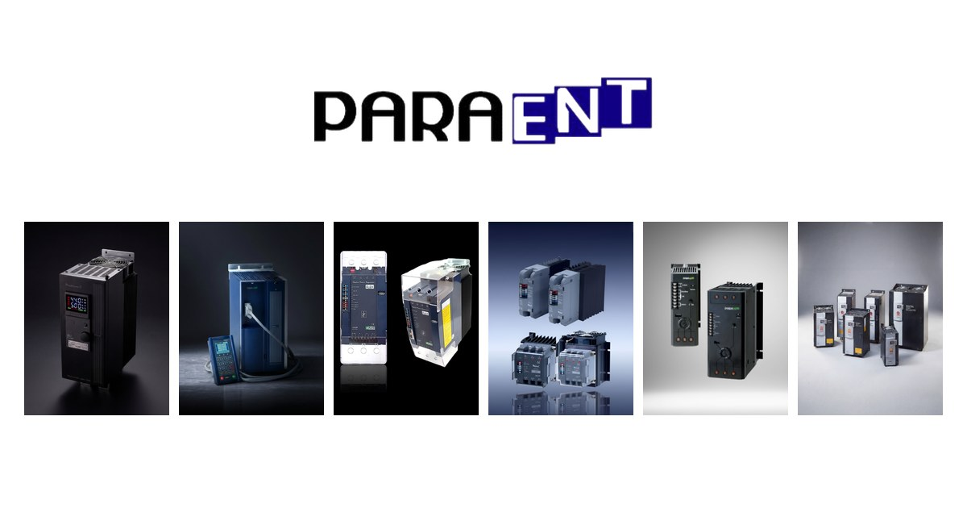
assets/images/og-image.jpg
