Joyedo/paraent-website-/assets/images/products/etype-hq.jpg

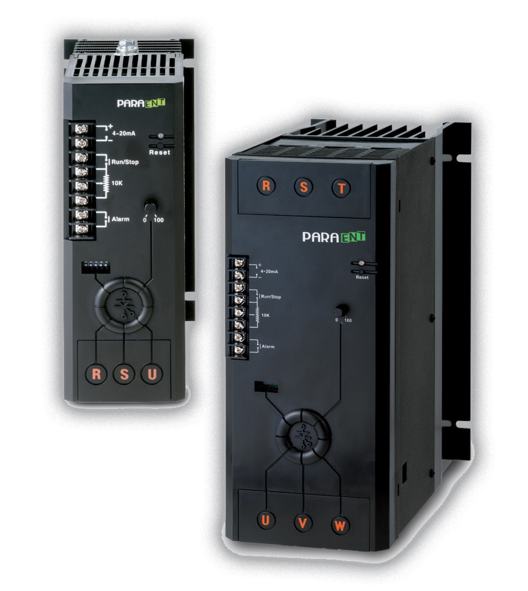
assets/images/products/etype-hq.jpg
