Joyedo/paraent-website-/assets/images/products/etype.png

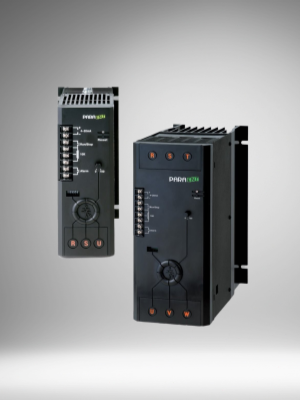
assets/images/products/etype.png
