Joyedo/paraent-website-/assets/images/products/flex-card.png

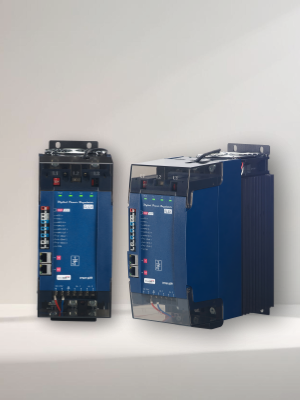
assets/images/products/flex-card.png
