Joyedo/paraent-website-/assets/images/products/flex.bak.png

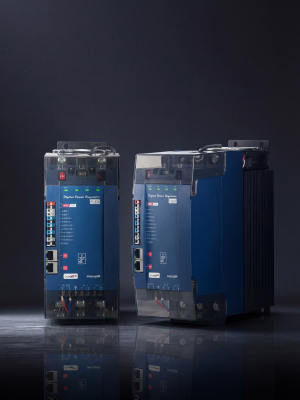
assets/images/products/flex.bak.png
