Joyedo/paraent-website-/assets/images/products/flex.png

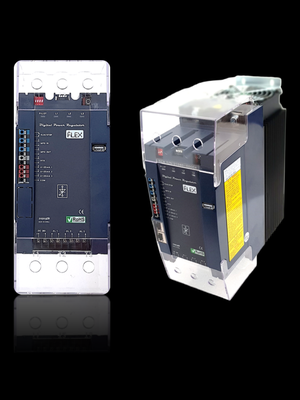
assets/images/products/flex.png
