Joyedo/paraent-website-/assets/images/products/hover-etype.png

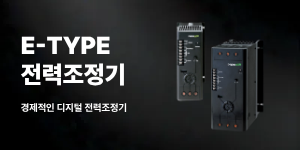
assets/images/products/hover-etype.png
