Joyedo/paraent-website-/assets/images/products/hover-flex.png

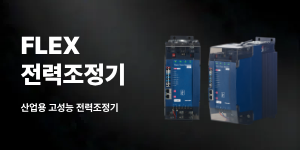
assets/images/products/hover-flex.png
