Joyedo/paraent-website-/assets/images/products/hover-mini.png

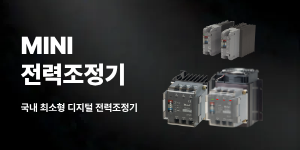
assets/images/products/hover-mini.png
