Joyedo/paraent-website-/assets/images/products/hover-pii.png

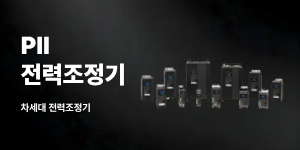
assets/images/products/hover-pii.png
