Joyedo/paraent-website-/assets/images/products/hover-ptype.png

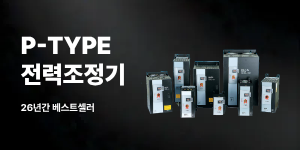
assets/images/products/hover-ptype.png
