Joyedo/paraent-website-/assets/images/products/hover-smart.png

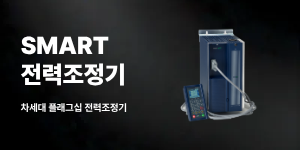
assets/images/products/hover-smart.png
