Joyedo/paraent-website-/assets/images/products/mini.png

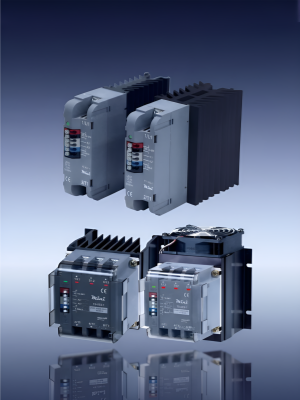
assets/images/products/mini.png
