Joyedo/paraent-website-/assets/images/products/multi.png

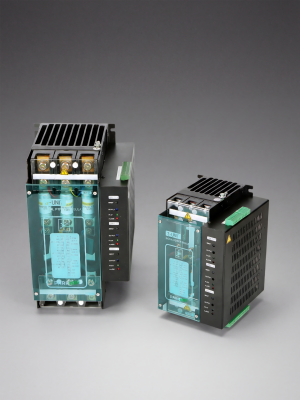
assets/images/products/multi.png
