Joyedo/paraent-website-/assets/images/products/pll-feature-alarm.png

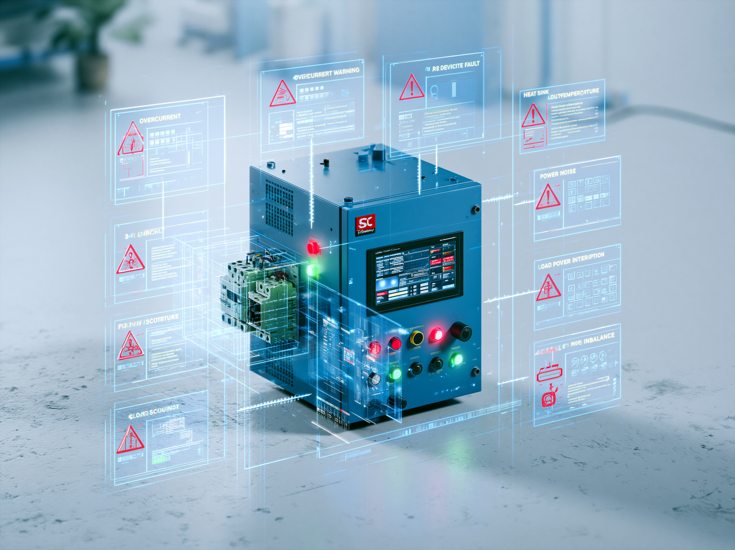
assets/images/products/pll-feature-alarm.png
