Joyedo/paraent-website-/assets/images/products/pll-feature-allinone.png

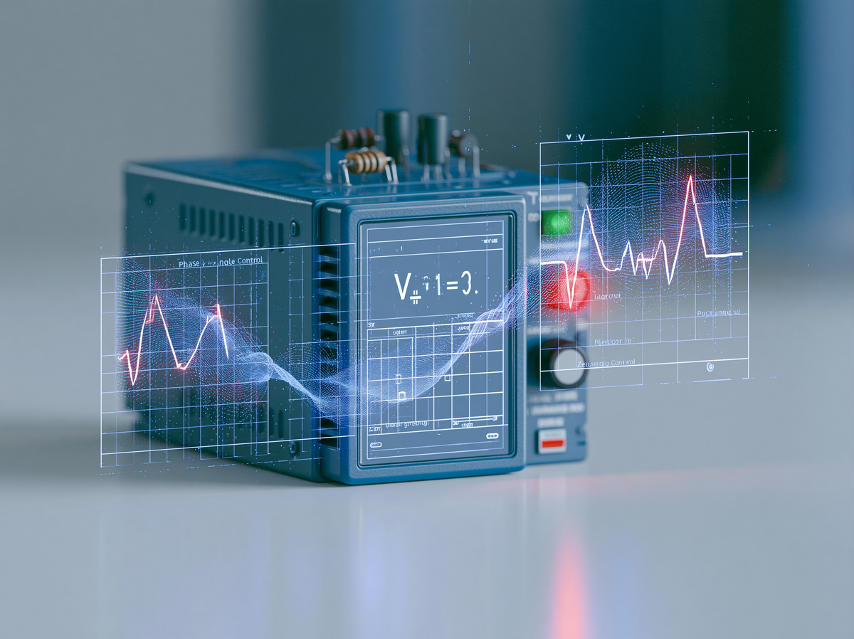
assets/images/products/pll-feature-allinone.png
