Joyedo/paraent-website-/assets/images/products/pll-feature-convenience.png

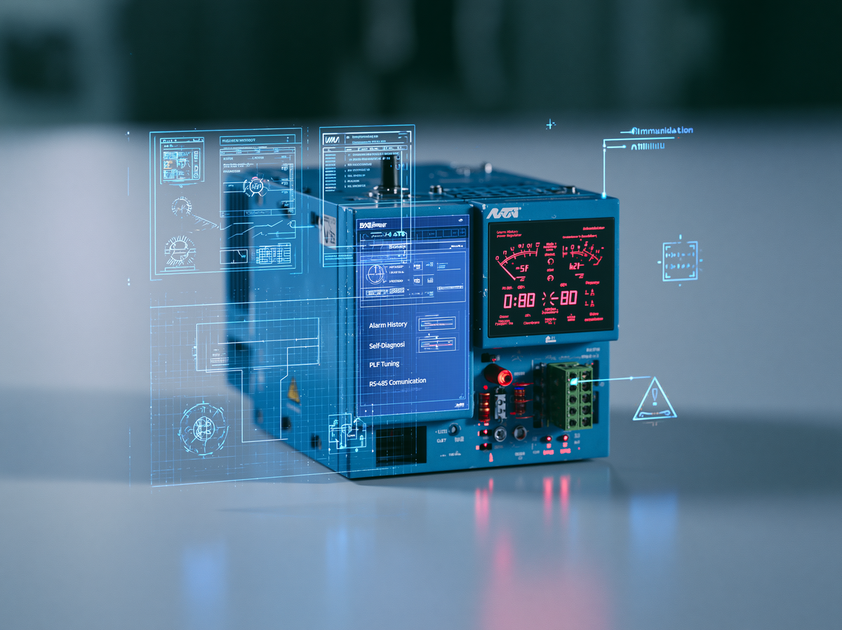
assets/images/products/pll-feature-convenience.png
