Joyedo/paraent-website-/assets/images/products/pll-feature-price.png

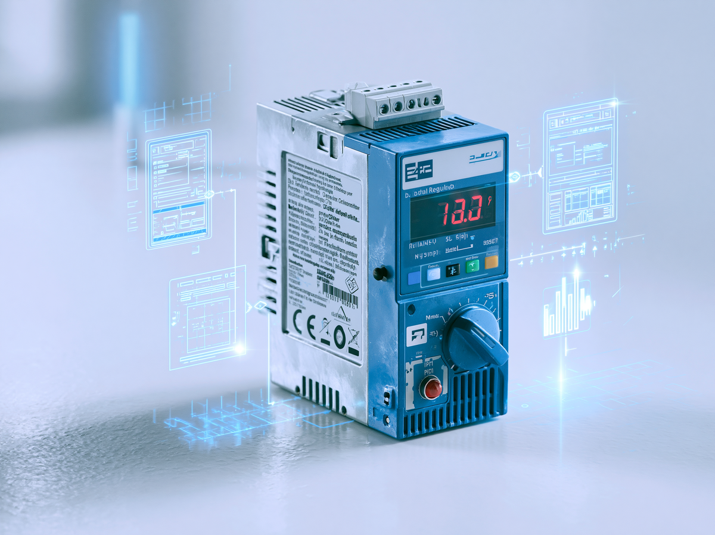
assets/images/products/pll-feature-price.png
