Joyedo/paraent-website-/assets/images/products/pll-hq2.jpg

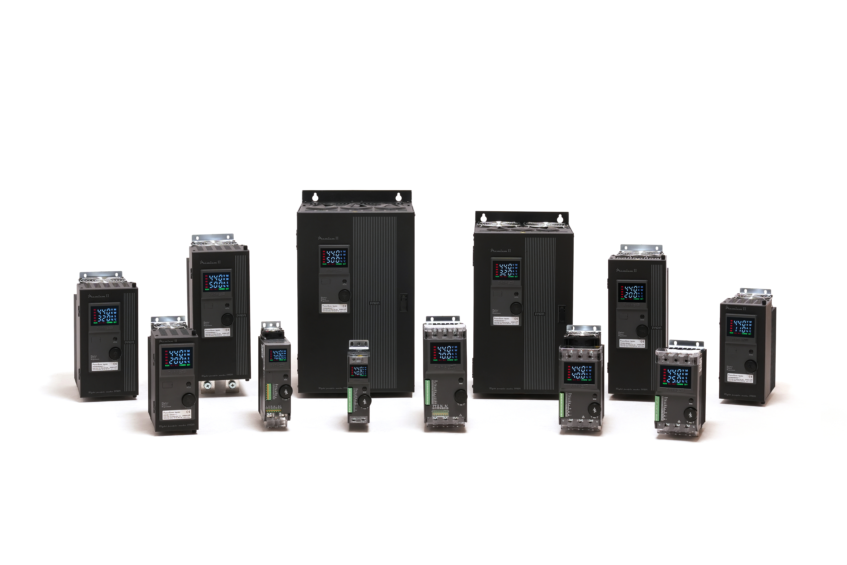
assets/images/products/pll-hq2.jpg
