Joyedo/paraent-website-/assets/images/products/pll-hq-mobile.png

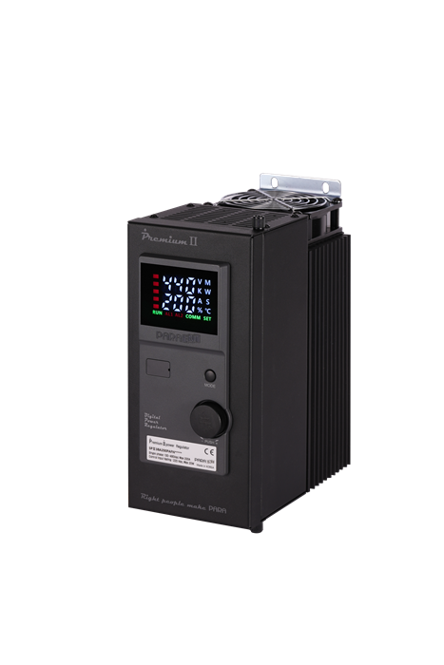
assets/images/products/pll-hq-mobile.png
