Joyedo/paraent-website-/assets/images/products/pll.png

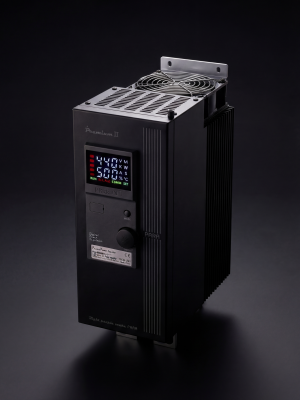
assets/images/products/pll.png
