Joyedo/paraent-website-/assets/images/products/ptype-hq-mobile.png

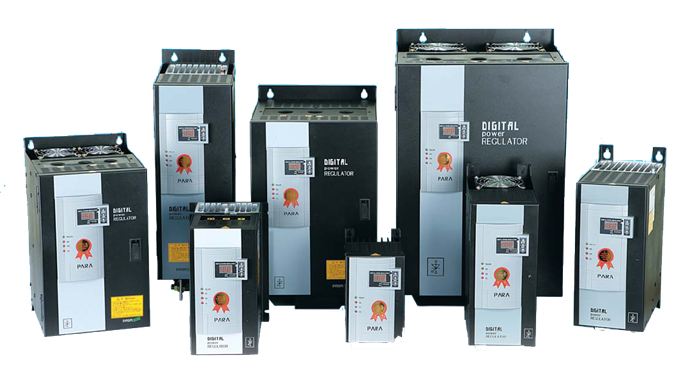
assets/images/products/ptype-hq-mobile.png
