Joyedo/paraent-website-/assets/images/products/ptype.png

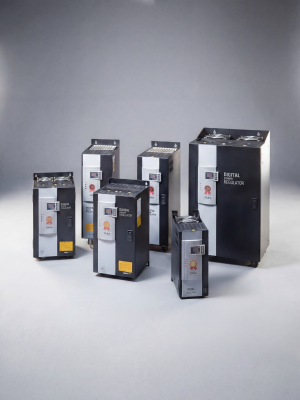
assets/images/products/ptype.png
