Joyedo/paraent-website-/assets/images/products/smart-card.png

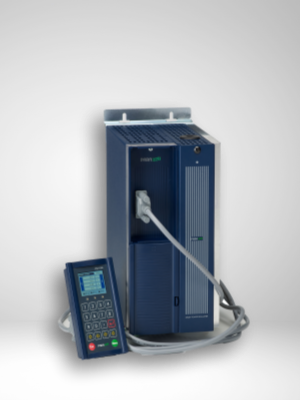
assets/images/products/smart-card.png
