Joyedo/paraent-website-/assets/images/products/smart-hq-mobile.png

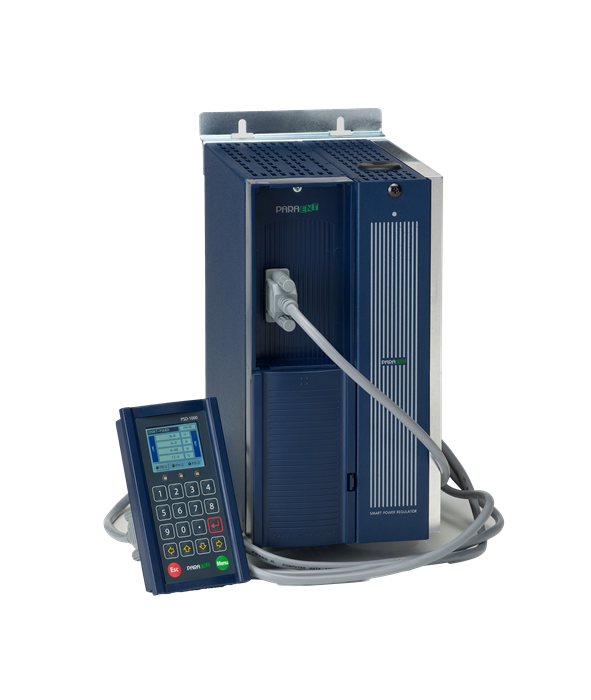
assets/images/products/smart-hq-mobile.png
