Joyedo/paraent-website-/assets/images/products/smart.png

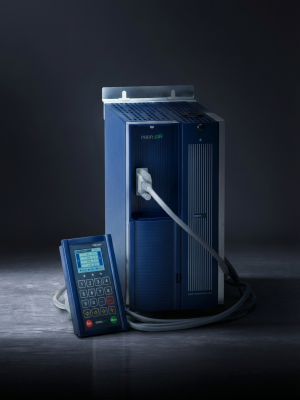
assets/images/products/smart.png
