Joyedo/paraent-website-/assets/images/psd-1000-display-en.png

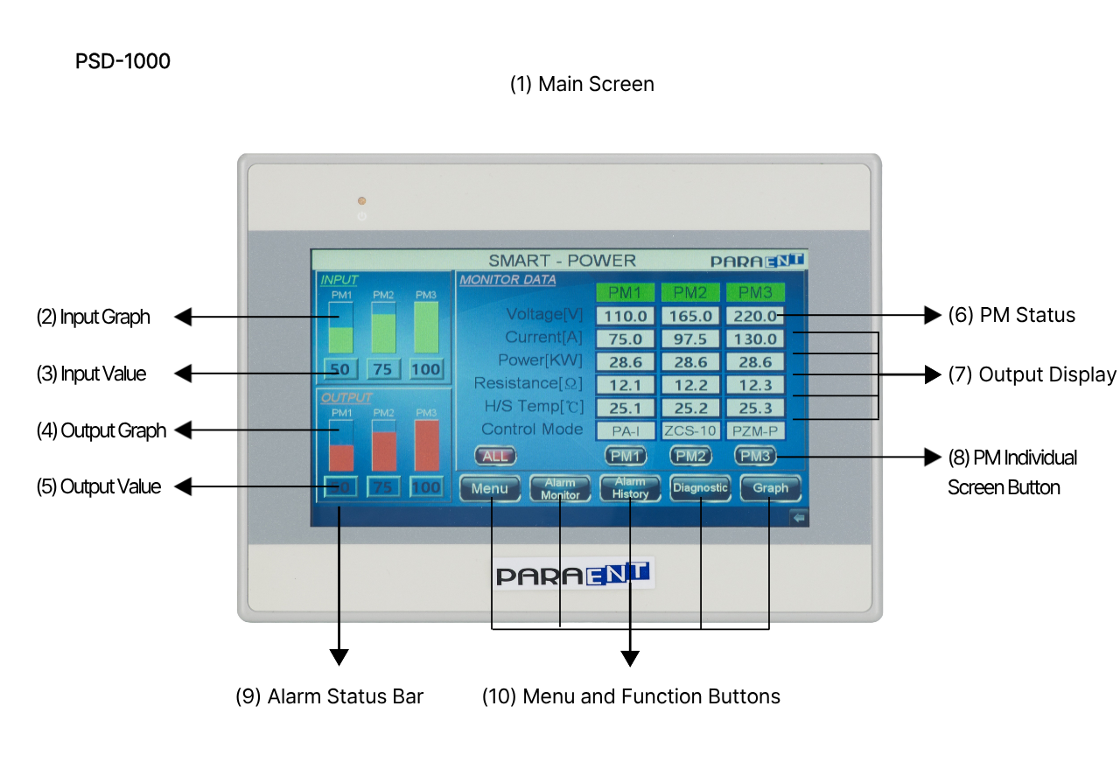
assets/images/psd-1000-display-en.png
