Joyedo/paraent-website-/assets/images/psd-2000-display.jpg

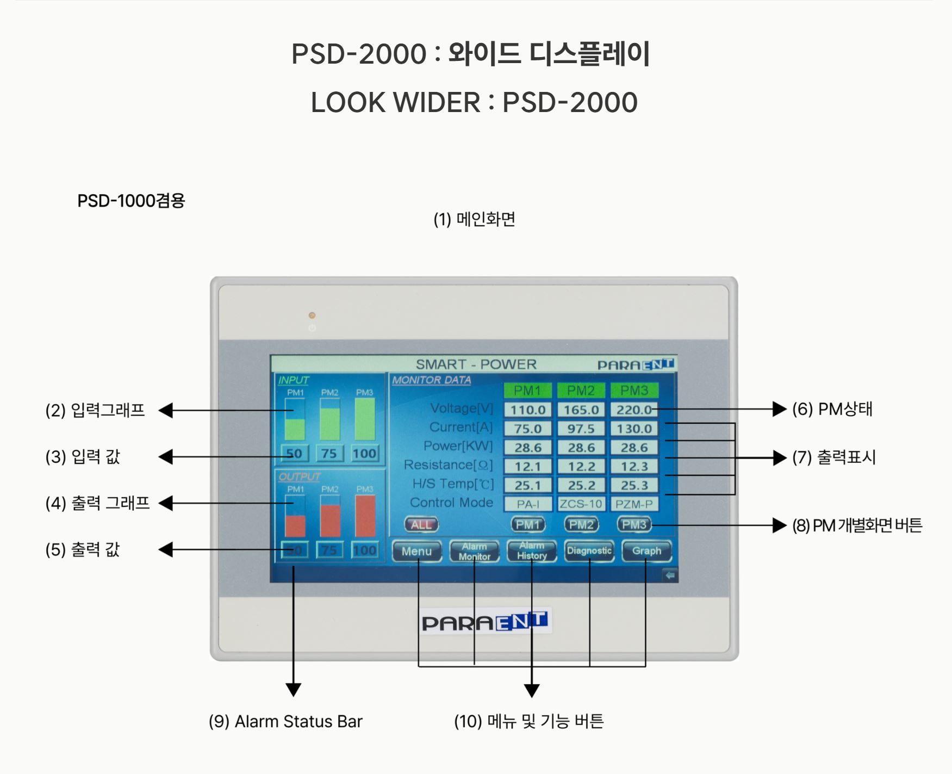
assets/images/psd-2000-display.jpg
