Joyedo/paraent-website-/assets/images/psd-2000-drawing.jpg

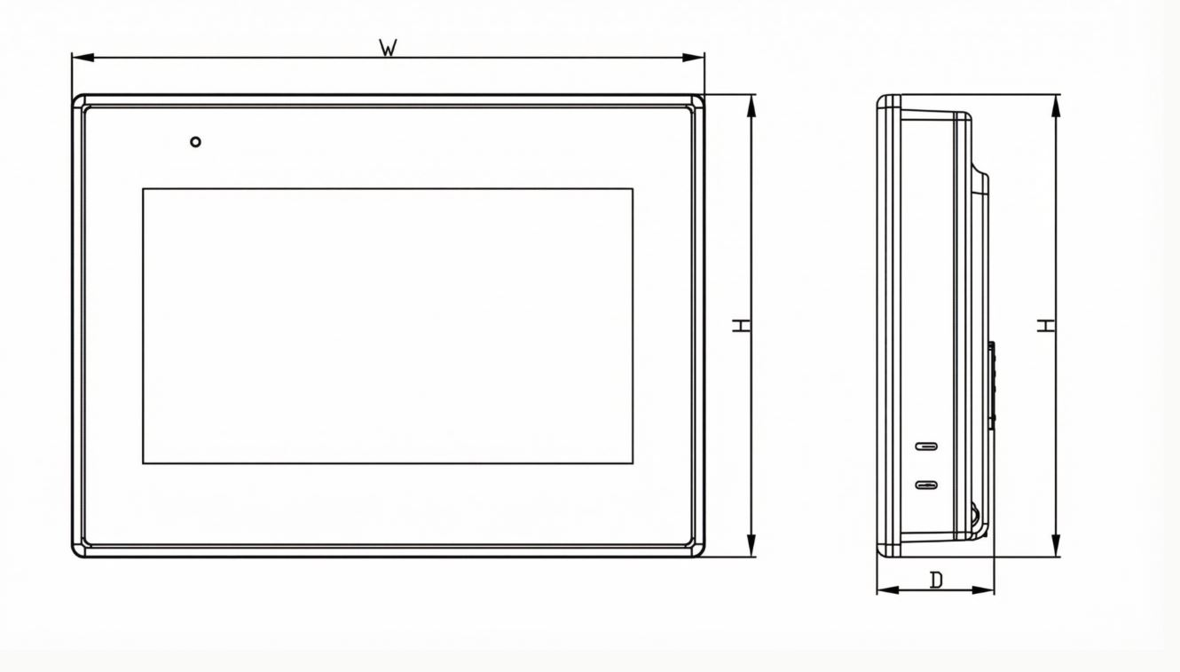
assets/images/psd-2000-drawing.jpg
