Joyedo/paraent-website-/assets/images/quality-innovation.png

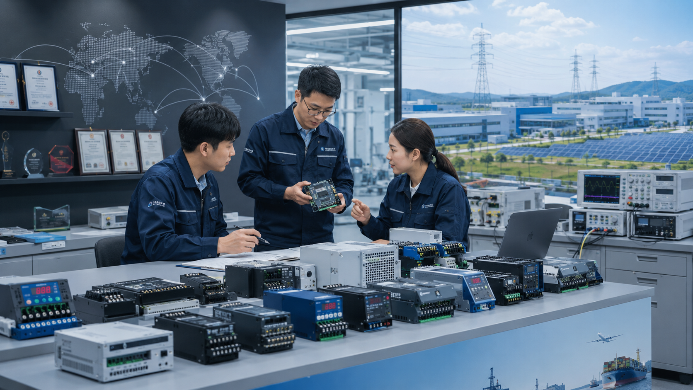
assets/images/quality-innovation.png
