Joyedo/paraent-website-/assets/images/quality-inspection-en.png

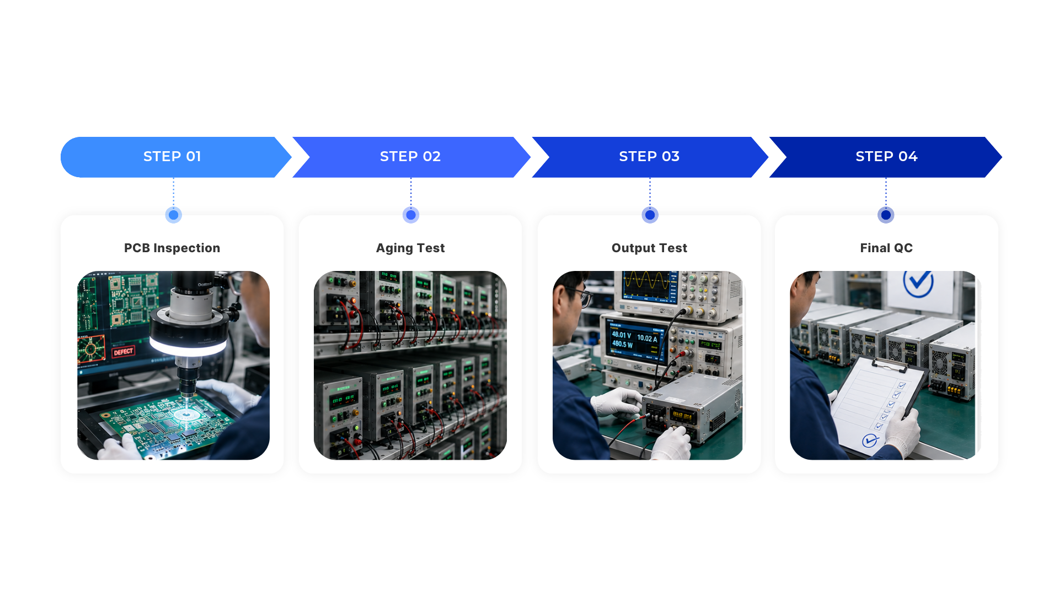
assets/images/quality-inspection-en.png
