Joyedo/paraent-website-/assets/images/quality-inspection.png

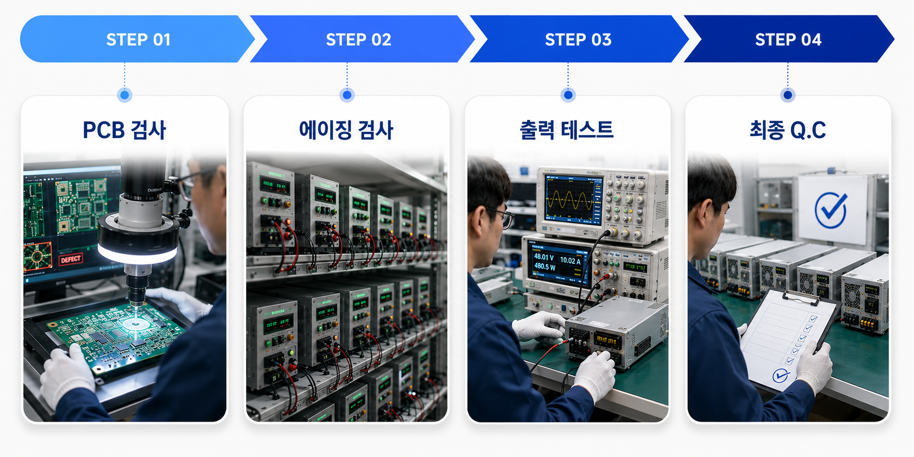
assets/images/quality-inspection.png
