Joyedo/paraent-website-/assets/images/quality-philosophy.png

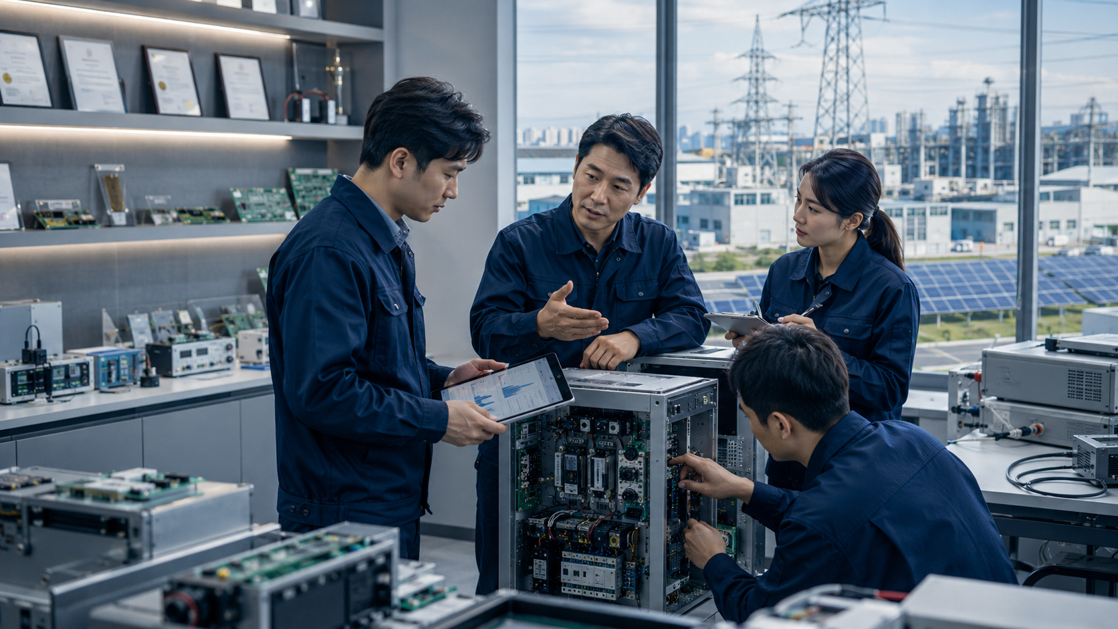
assets/images/quality-philosophy.png
