Joyedo/paraent-website-/images/smart-hover-combination.png

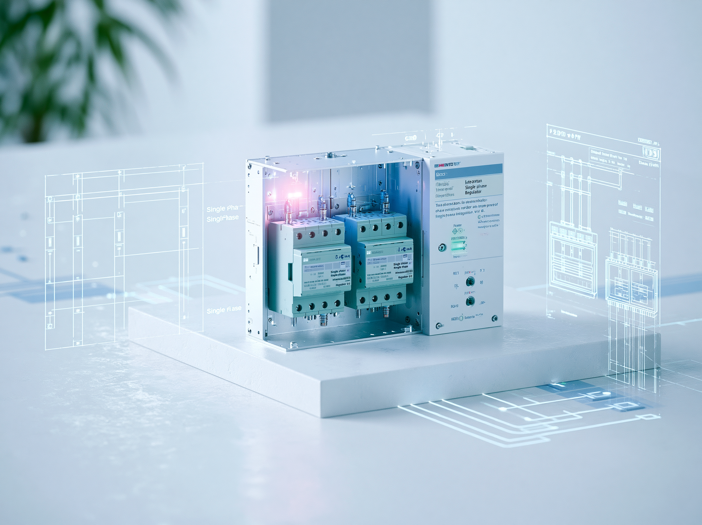
images/smart-hover-combination.png
