Joyedo/paraent-website-/images/smart-hover-display.png

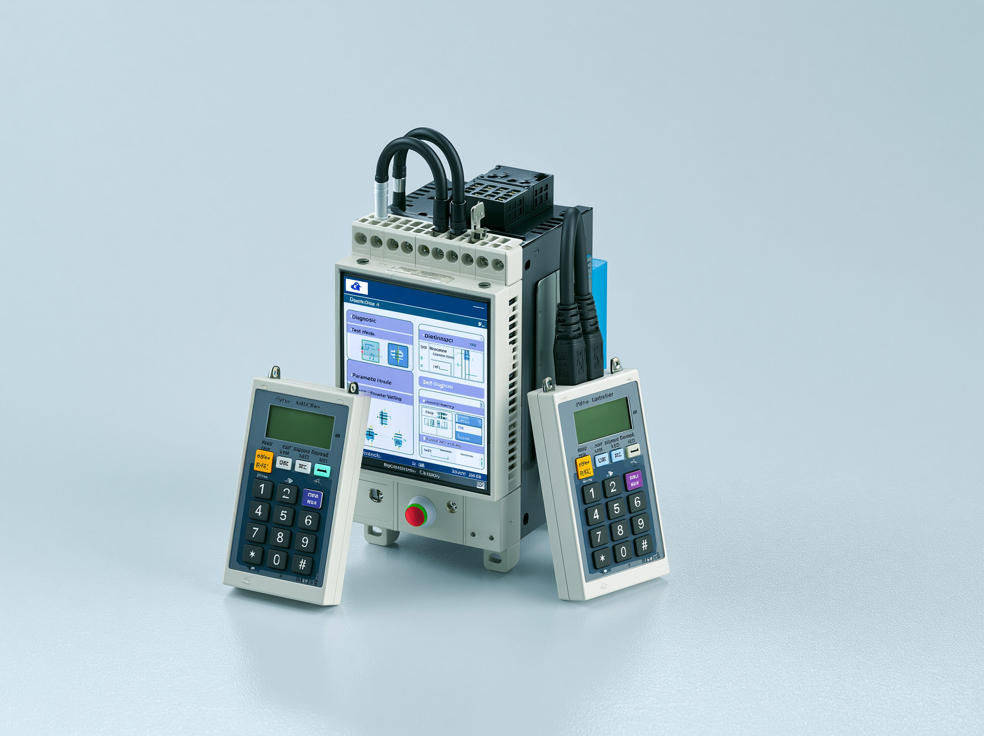
images/smart-hover-display.png
