Joyedo/paraent-website-/images/smart-hover-mpd.png

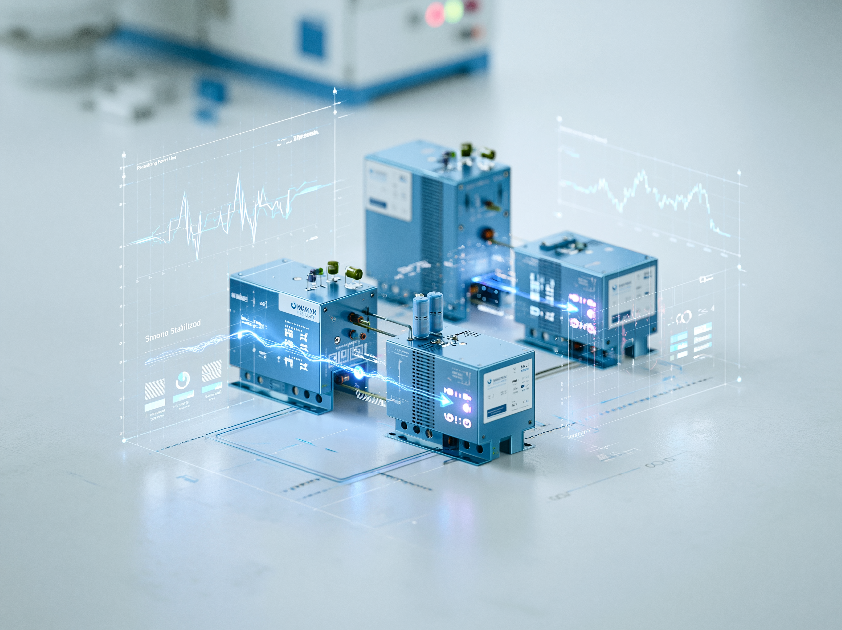
images/smart-hover-mpd.png
