Joyedo/paraent-website-/images/smart-hover-plf.png

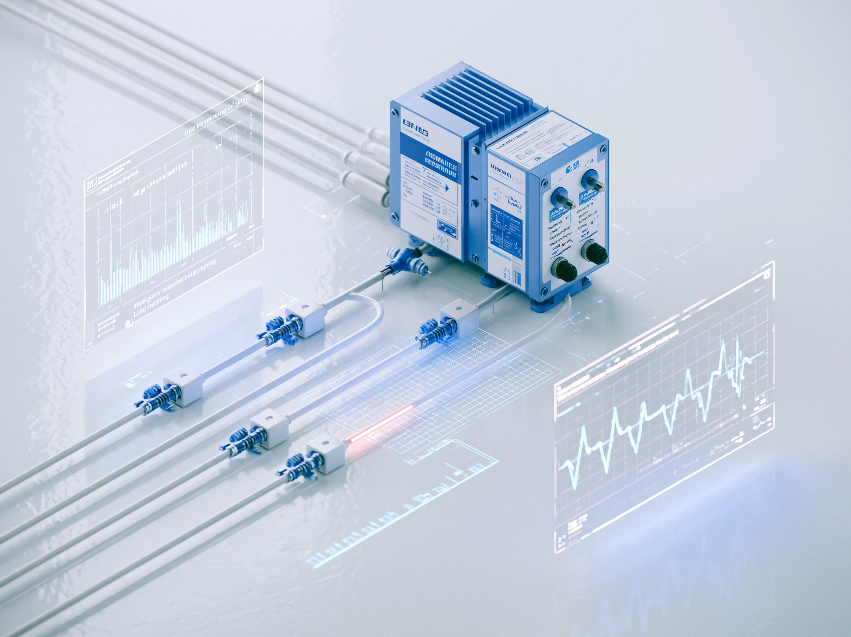
images/smart-hover-plf.png
