Joyedo/paraent-website-/images/smart-mpd-main-en.png

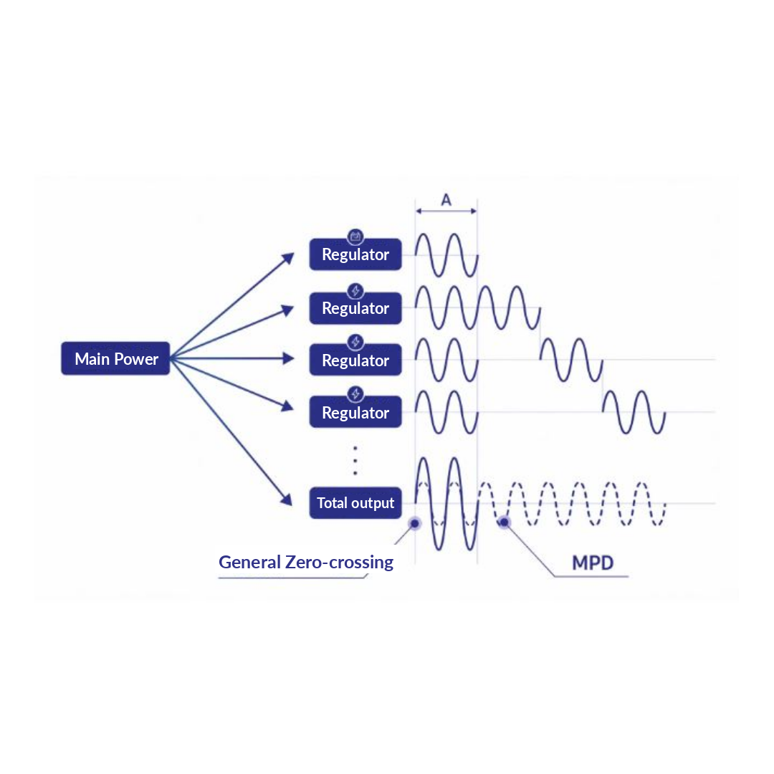
images/smart-mpd-main-en.png
