Joyedo/paraent-website-/images/smart-mpd-main-zh.png

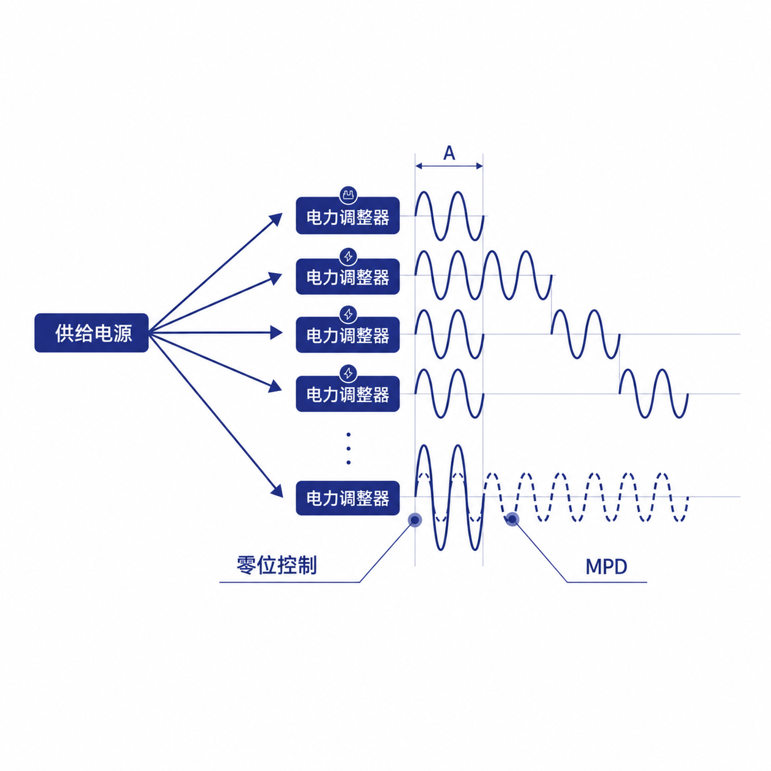
images/smart-mpd-main-zh.png
