Joyedo/paraent-website-/images/smart-mpd-main.png

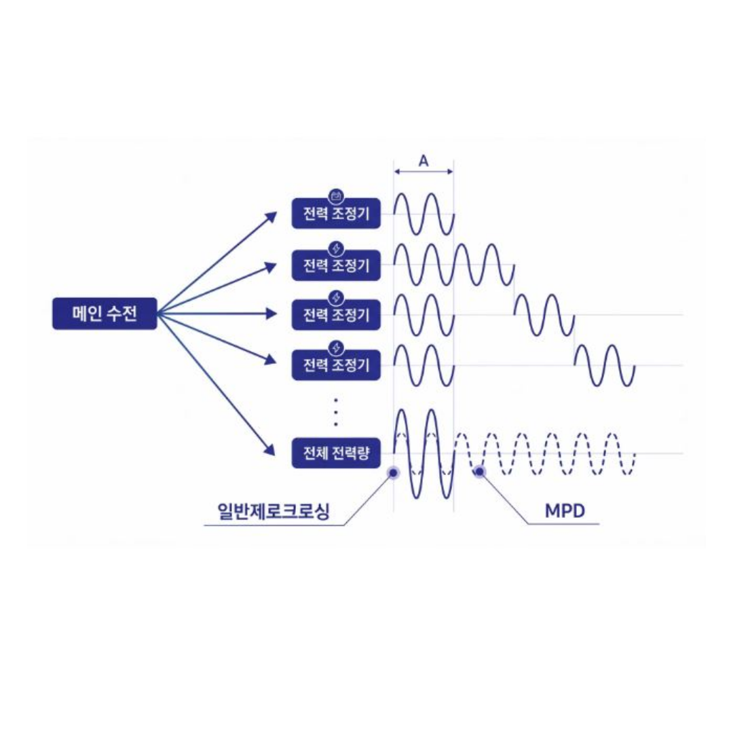
images/smart-mpd-main.png
