Joyedo/paraent-website-/images/smart-mpd-wave1.png

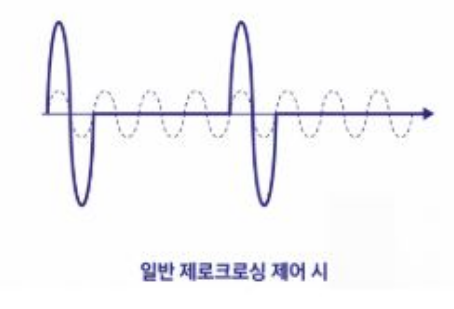
images/smart-mpd-wave1.png
