Joyedo/paraent-website-/images/smart-mpd-wave2.png

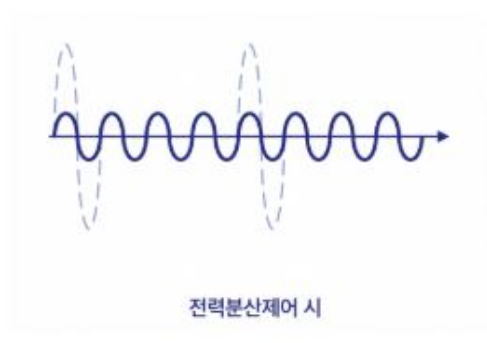
images/smart-mpd-wave2.png
