Joyedo/paraent-website-/images/smart-mpd-wave-new2-en.png

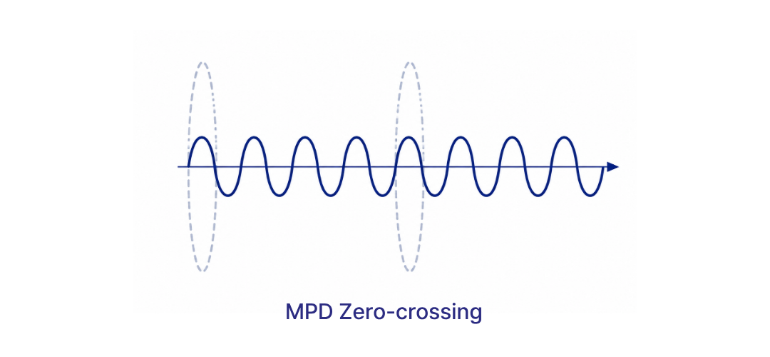
images/smart-mpd-wave-new2-en.png
