Joyedo/paraent-website-/images/smart-mpd-wave-new-en.png

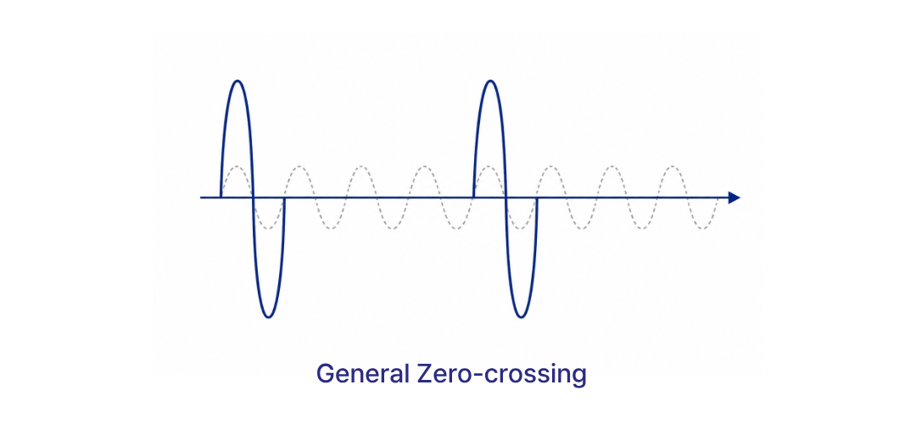
images/smart-mpd-wave-new-en.png
