Joyedo/paraent-website-/images/smart-mpd-waves.png

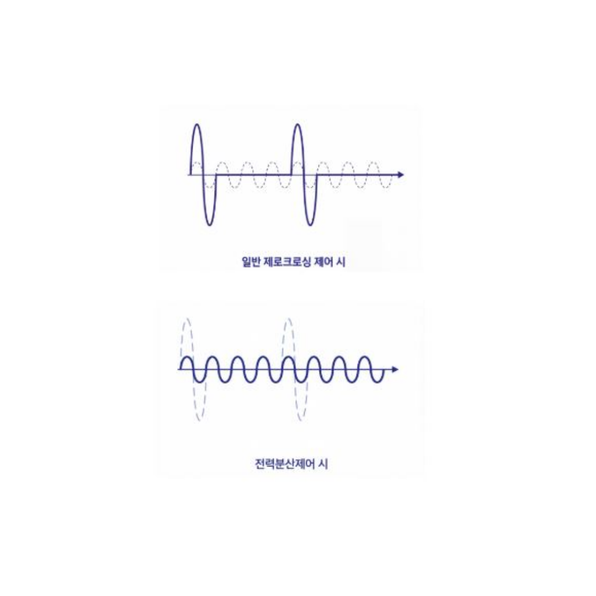
images/smart-mpd-waves.png
