Joyedo/paraent-website-/images/smart-plf-delta.png

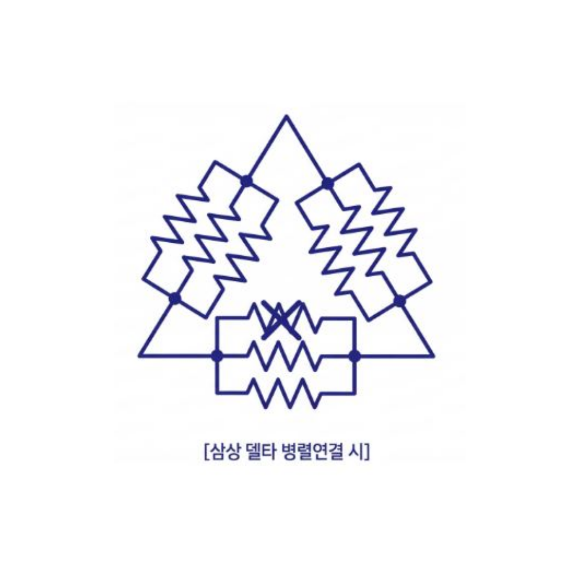
images/smart-plf-delta.png
