Joyedo/paraent-website-/images/smart-plf-new1-zh.png

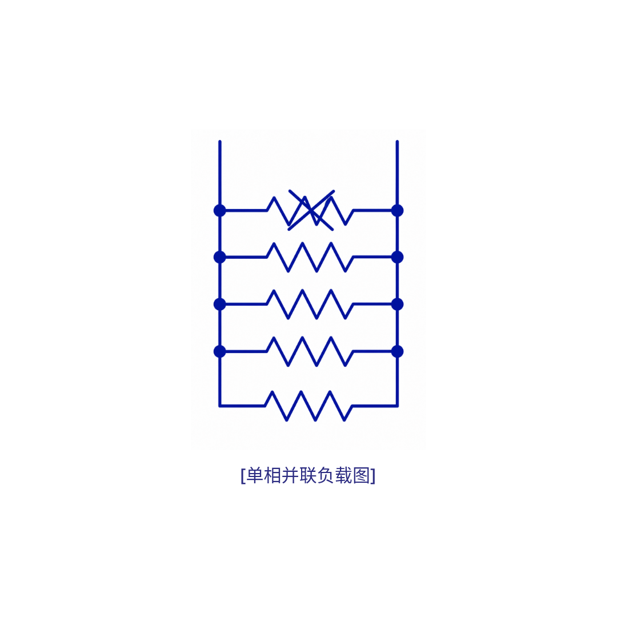
images/smart-plf-new1-zh.png
