Joyedo/paraent-website-/images/smart-plf-new1.png

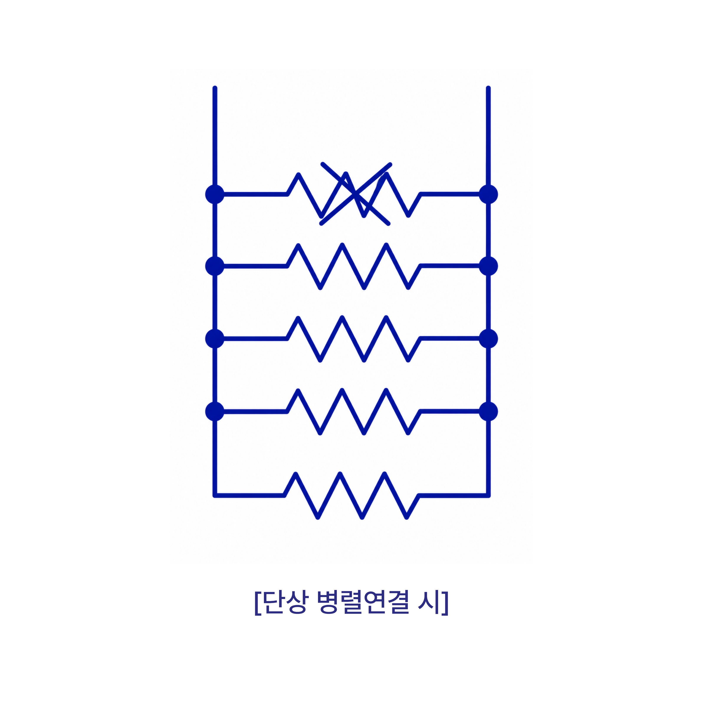
images/smart-plf-new1.png
