Joyedo/paraent-website-/images/smart-plf-new2-en.png

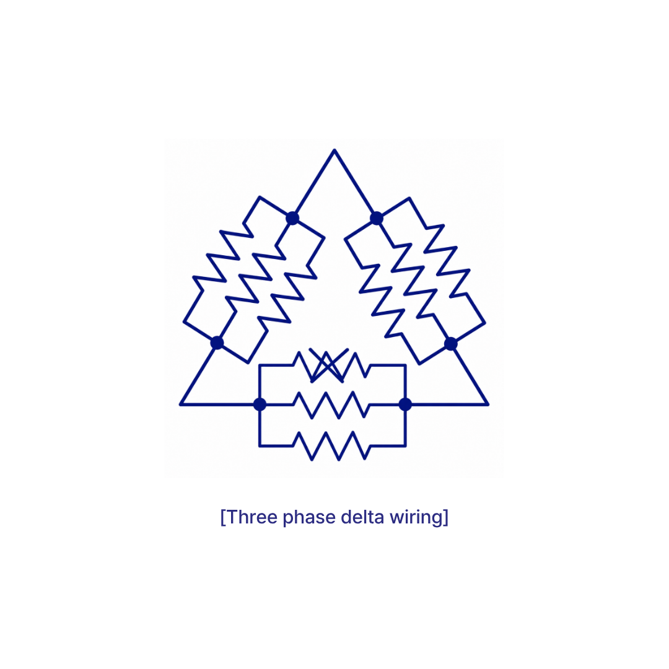
images/smart-plf-new2-en.png
