Joyedo/paraent-website-/images/smart-plf-new2.png

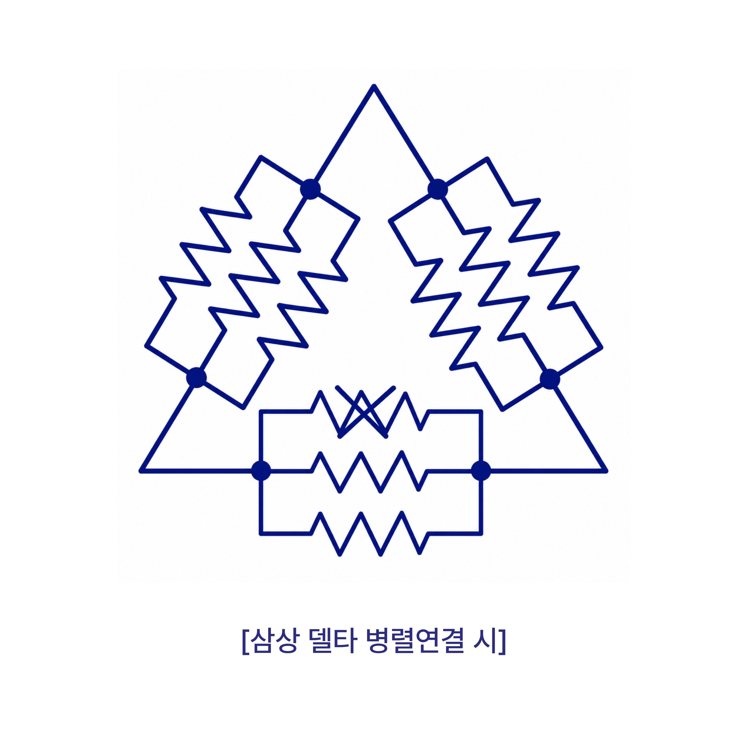
images/smart-plf-new2.png
