Joyedo/paraent-website-/images/smart-plf-new3-en.png

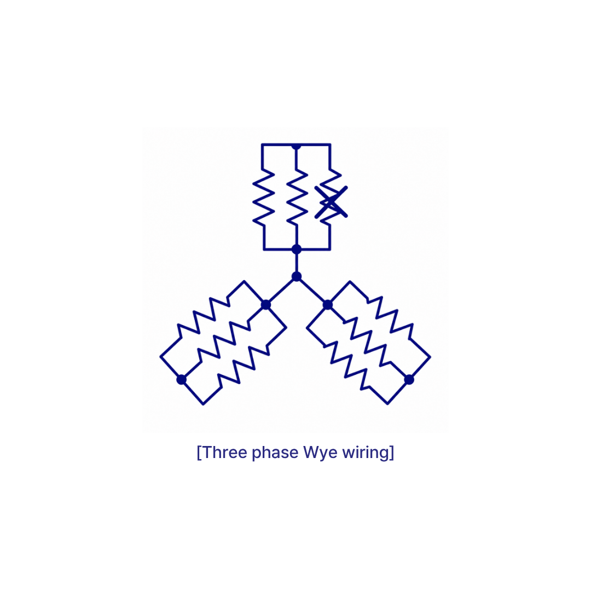
images/smart-plf-new3-en.png
