Joyedo/paraent-website-/images/smart-plf-new3.png

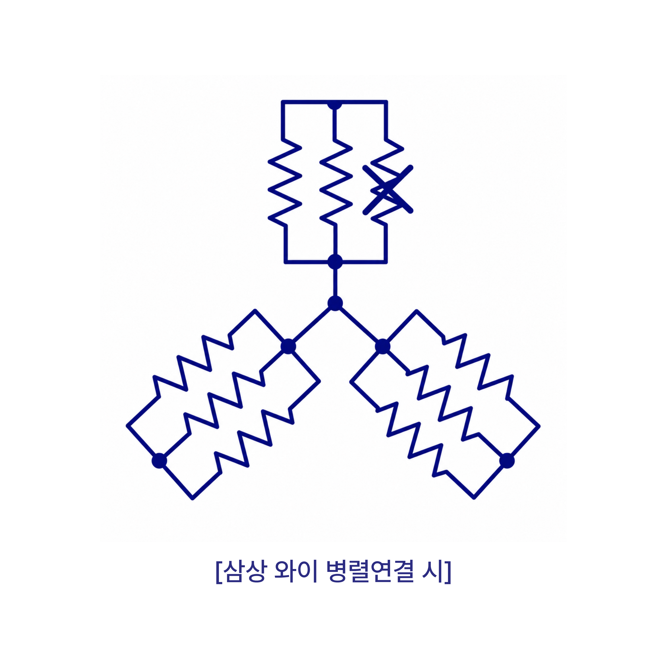
images/smart-plf-new3.png
