Joyedo/paraent-website-/images/smart-plf-wye.png

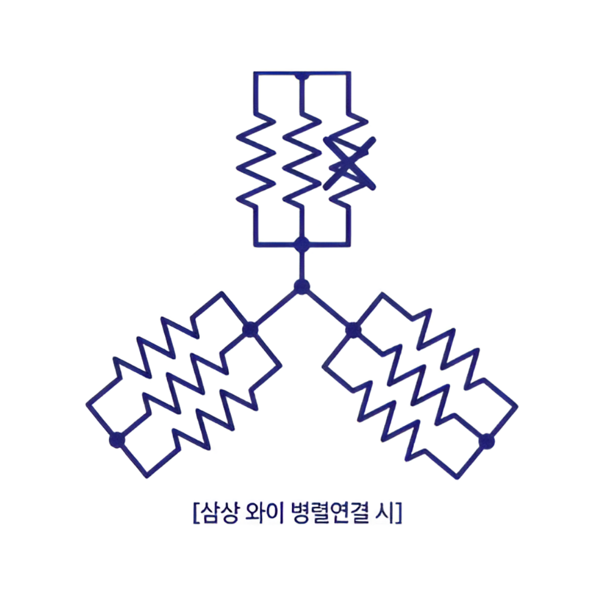
images/smart-plf-wye.png
