Joyedo/paraent-website-/images/smart-psd-attached.png

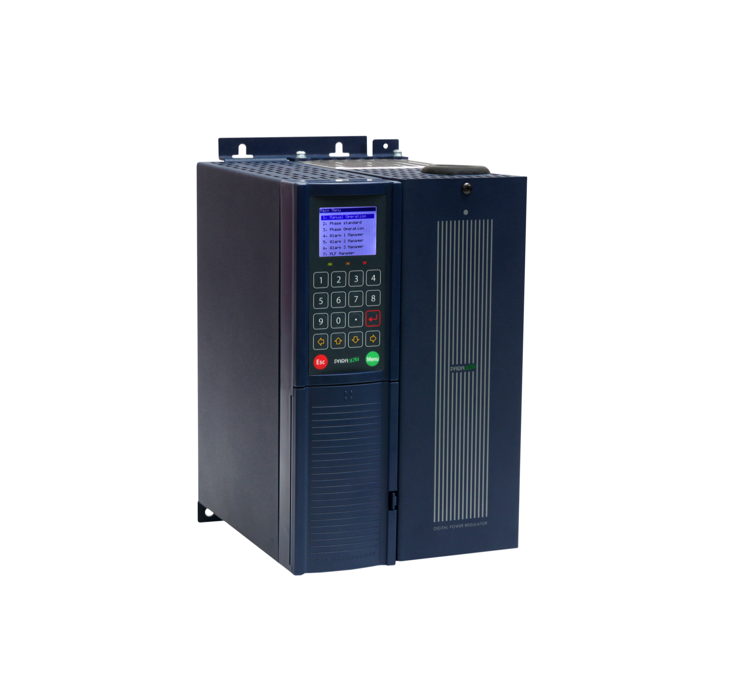
images/smart-psd-attached.png
