Joyedo/paraent-website-/images/smart-psd-detached.png

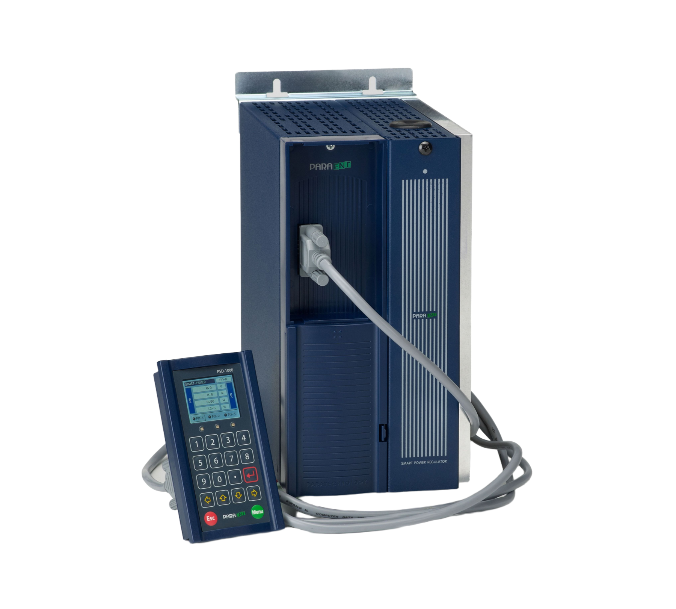
images/smart-psd-detached.png
