Joyedo/paraent-website-/images/smart-psd-unit.png

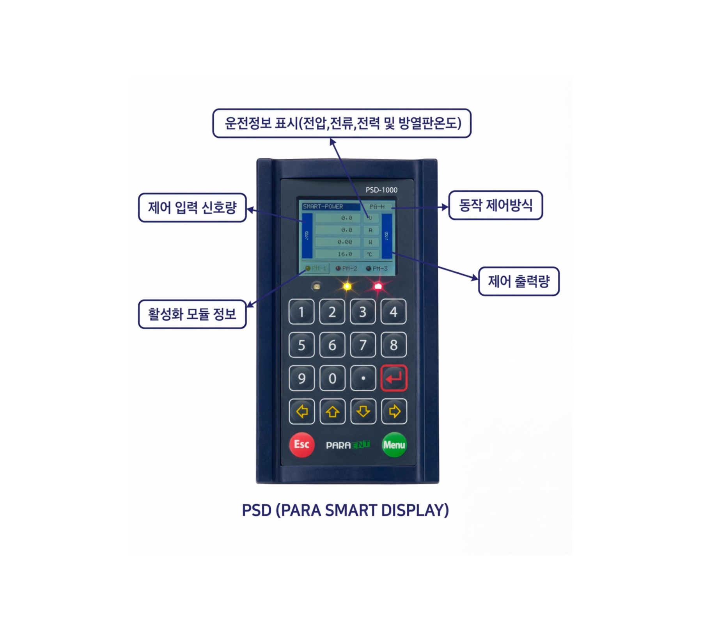
images/smart-psd-unit.png
