Joyedo/paraent-website-/images/tech-hover-1.png

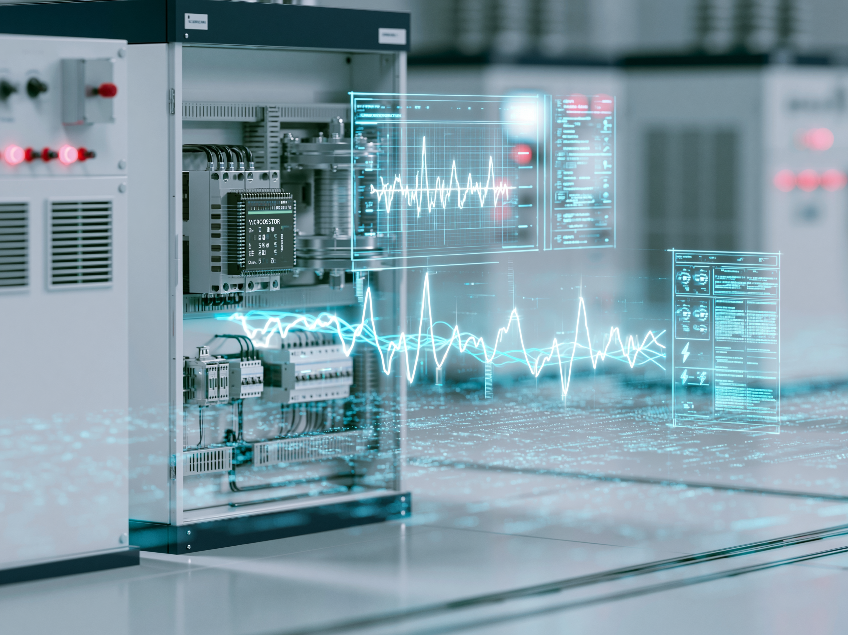
images/tech-hover-1.png
