Joyedo/paraent-website-/images/tech-hover-2.png

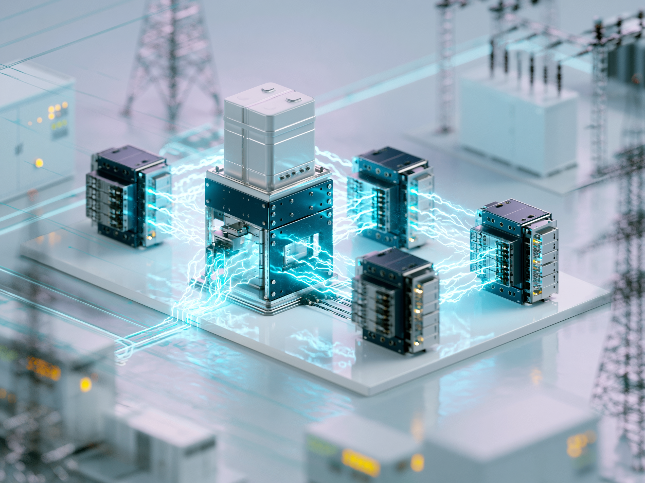
images/tech-hover-2.png
