Joyedo/paraent-website-/images/tech-hover-3.png

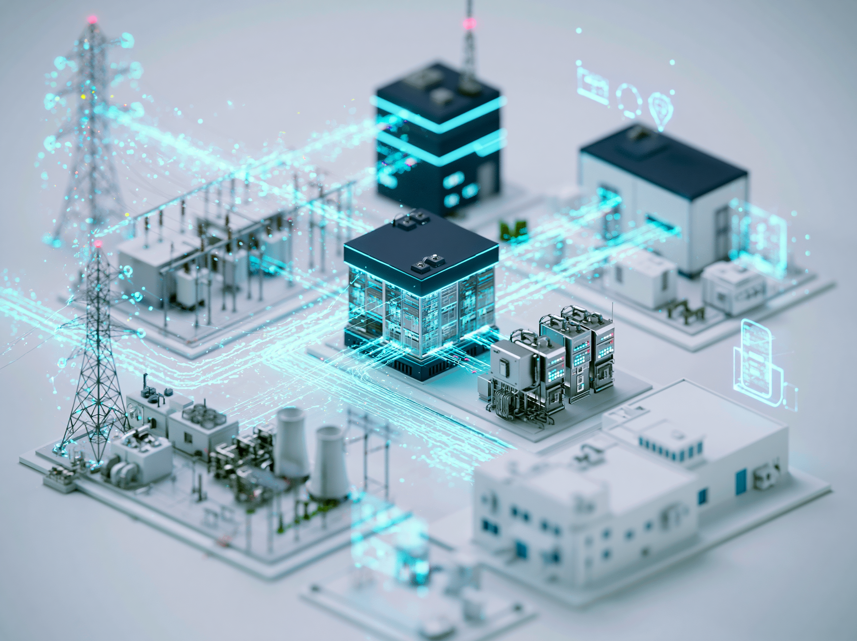
images/tech-hover-3.png
