Joyedo/paraent-website-/assets/images/certifications/other/materials.jpg

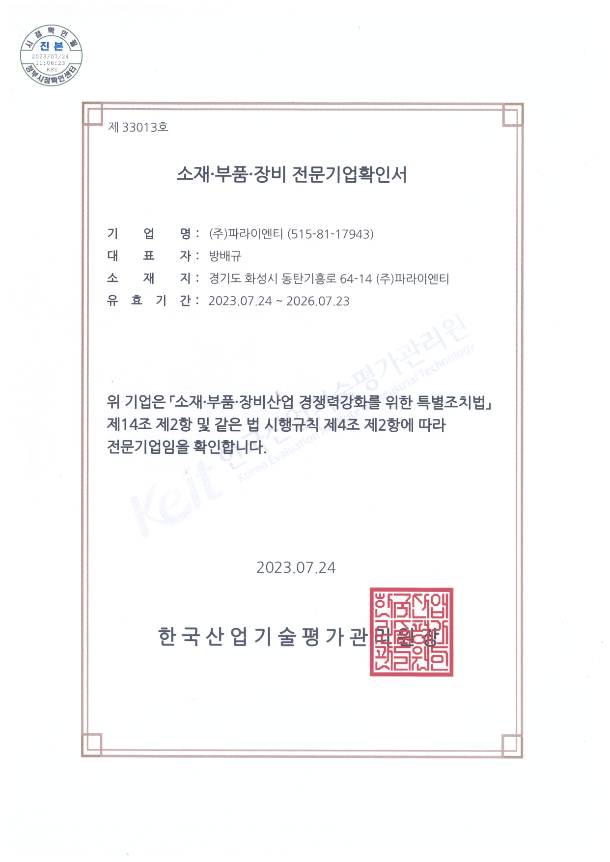
assets/images/certifications/other/materials.jpg
