Joyedo/paraent-website-/files/cad/MINI-단상-15A_25A_외형도_3D.step

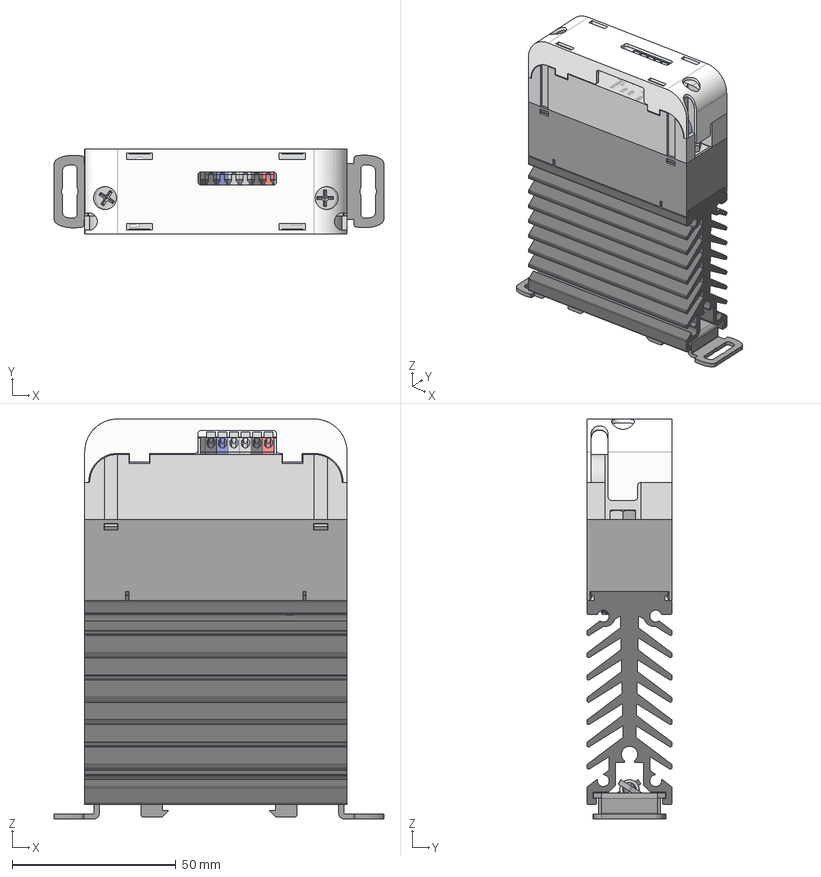
[picture p104: CAD file, 2026-07-17]
files/cad/MINI-단상-15A_25A_외형도_3D.step
100.5 x 26.0 x 122.0 mm
