Joyedo/paraent-website-/files/cad/MINI-삼상-25A_외형도_3D.step

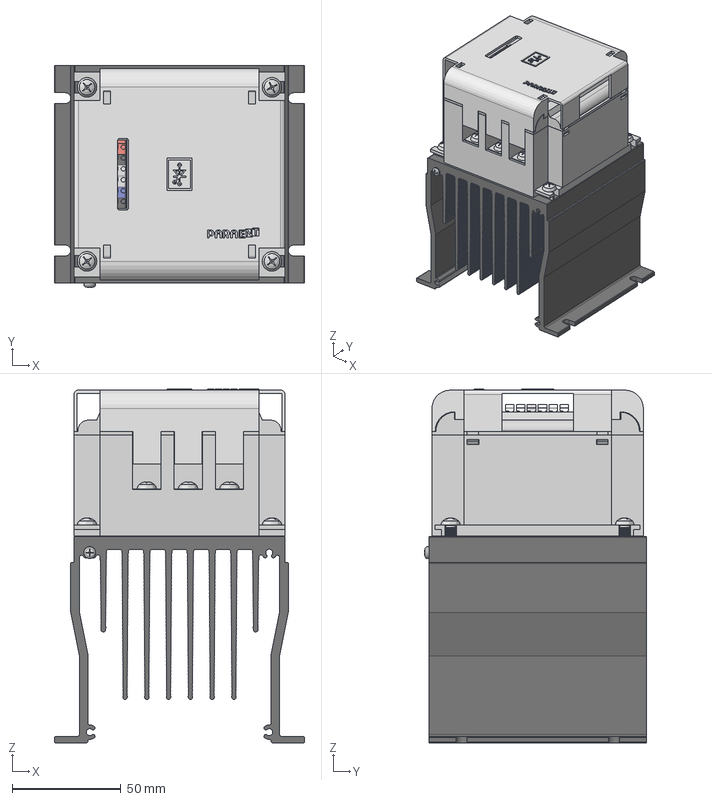
[picture p105: CAD file, 2026-07-17]
files/cad/MINI-삼상-25A_외형도_3D.step
115.0 x 102.0 x 162.7 mm
MINI_3상 터미널블럭 (2)
MINI_3상 터미널블럭 (3)
투명커버
