Joyedo/paraent-website-/files/cad/MINI-단상-40A_외형도_3D.step

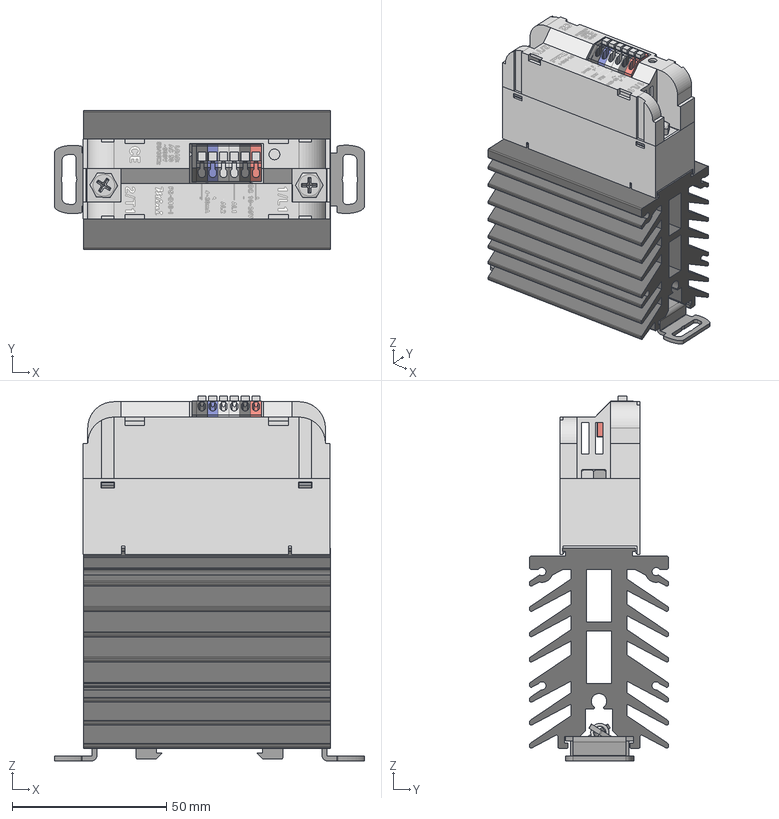
[picture p106: CAD file, 2026-07-17]
files/cad/MINI-단상-40A_외형도_3D.step
100.5 x 45.0 x 118.3 mm
