Joyedo/paraent-website-/(list of files, cad)

Other CAD files:
files/cad/SPII-A-025_AC_외형도.dwg
files/cad/TPII-400_외형도.dwg
files/cad/TPII-C-010_외형도.dwg
files/cad/TPII-025_외형도.dwg
files/cad/SPII-A-250_외형도.dwg
files/cad/SPII-A-130_외형도.dwg
files/cad/TPII-090_외형도.dwg
files/cad/SPII-C-010_DC_외형도.dwg
files/cad/SPII-A-400_외형도.dwg
files/cad/SPII-A-090_외형도.dwg
files/cad/SPII-A-025_DC_외형도.dwg
files/cad/Mini 단상-Type-20250124.dwg
files/cad/Mini 3상-치수도면.dwg
files/cad/SMART-400A-치수도면.dwg
files/cad/TP-250A-치수도면.dwg
files/cad/SP-400A-치수도면.dwg
files/cad/TP-025-치수도면.dwg
files/cad/TP-400A-치수도면.dwg
files/cad/TE-Type-치수도면-.dwg
files/cad/Multi-Type(구형)-치수도면.dwg
files/cad/SP-250A-치수도면.dwg
files/cad/SE-Type-치수도면.dwg
files/cad/SMART-250A-치수도면.dwg
files/cad/SMART-10A-치수도면.dwg
files/cad/TP-90A-치수도면.dwg
files/cad/Multi-Type(신형)-치수도면.dwg
files/cad/SMART-70A-치수도면.dwg
files/cad/SP-025-치수도면.dwg
files/cad/SP-90A-치수도면.dwg
