Joyedo/paraent-website-/assets/images/history-decade-2010.png

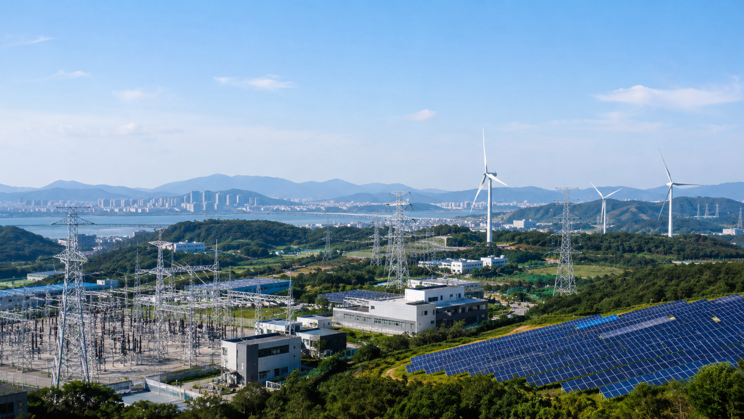
assets/images/history-decade-2010.png
