Joyedo/paraent-website-/files/tech/tech-mpd.pdf

# SMART POWER REGULATOR

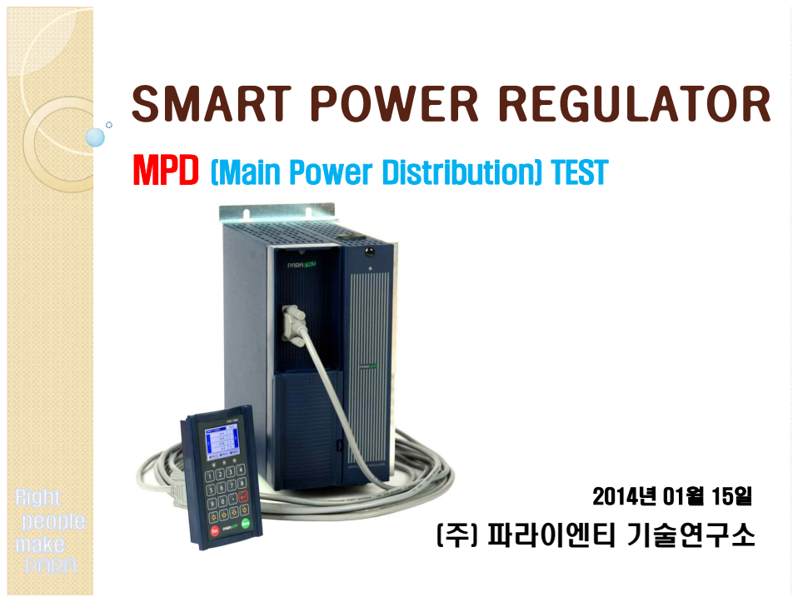
[picture p296: page 1]
(주) 파라이엔티 기술연구소

MPD (Main Power Distribution) TEST

# Contents

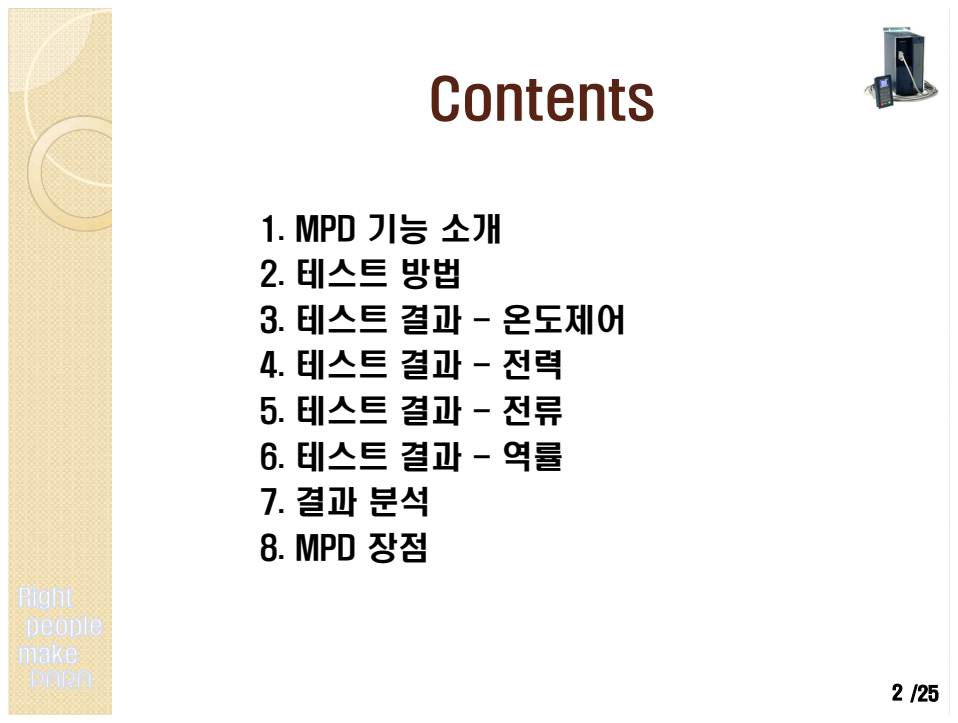
[picture p297: page 2]

1. MPD 기능 소개
2. 테스트 방법
3. 테스트 결과 - 온도제어
4. 테스트 결과 - 전력
5. 테스트 결과 - 전류
6. 테스트 결과 - 역률
8. MPD 장점

— 정의

# 1. MPD 기능 소개

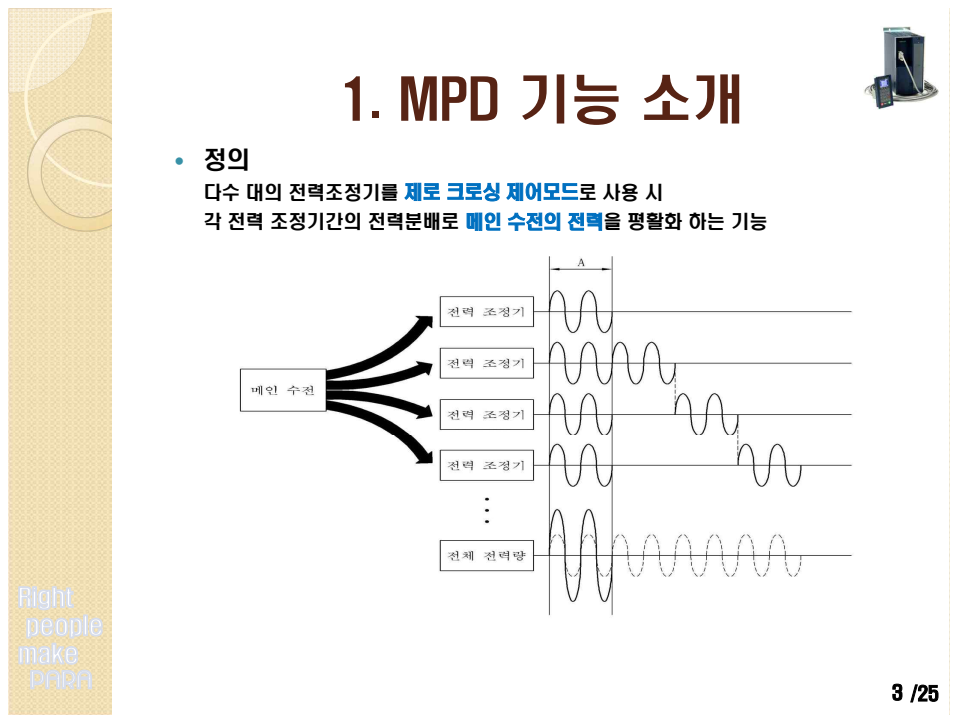
[picture p298: page 3]

다수 대의 전력조정기를 제로 크로싱 제어모드로 사용 시
각 전력 조정기간의 전력분배로 메인 수전의 전력을 평활화 하는 기능

# — 메인 수전 파형의 예(8개의 전력조정기를 8MODE 1/8 제어 시) - MPD 제어 시

# 1. MPD 기능 소개

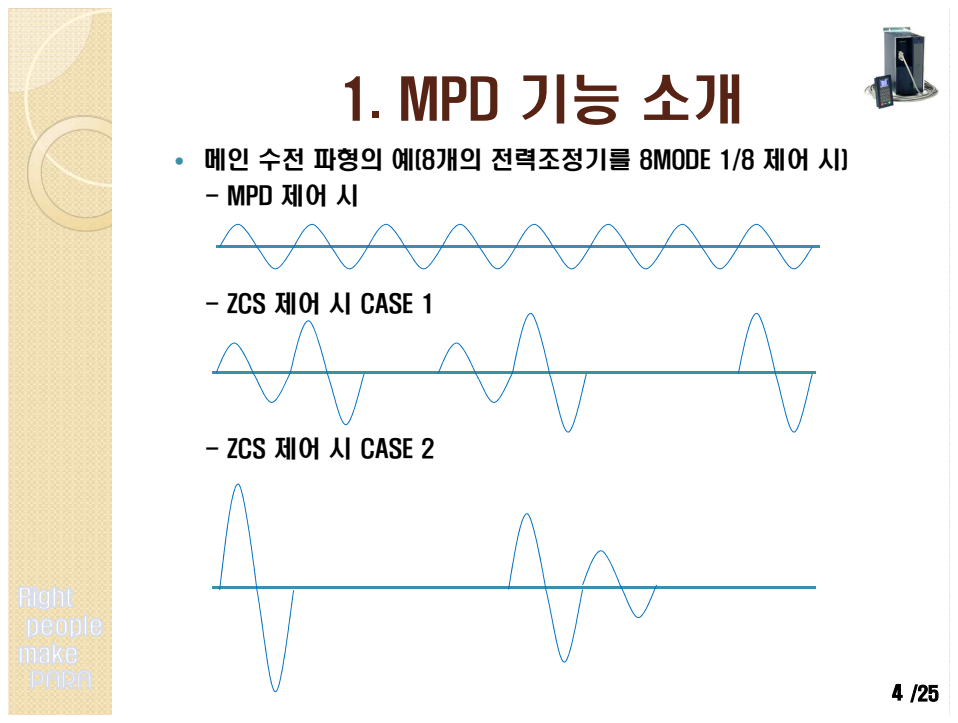
[picture p299: page 4]

- ZCS 제어 시 CASE 1

- ZCS 제어 시 CASE 2

# — 16대의 SMART REGULATOR를 통한 장비 운전 시

# 2. 테스트 방법

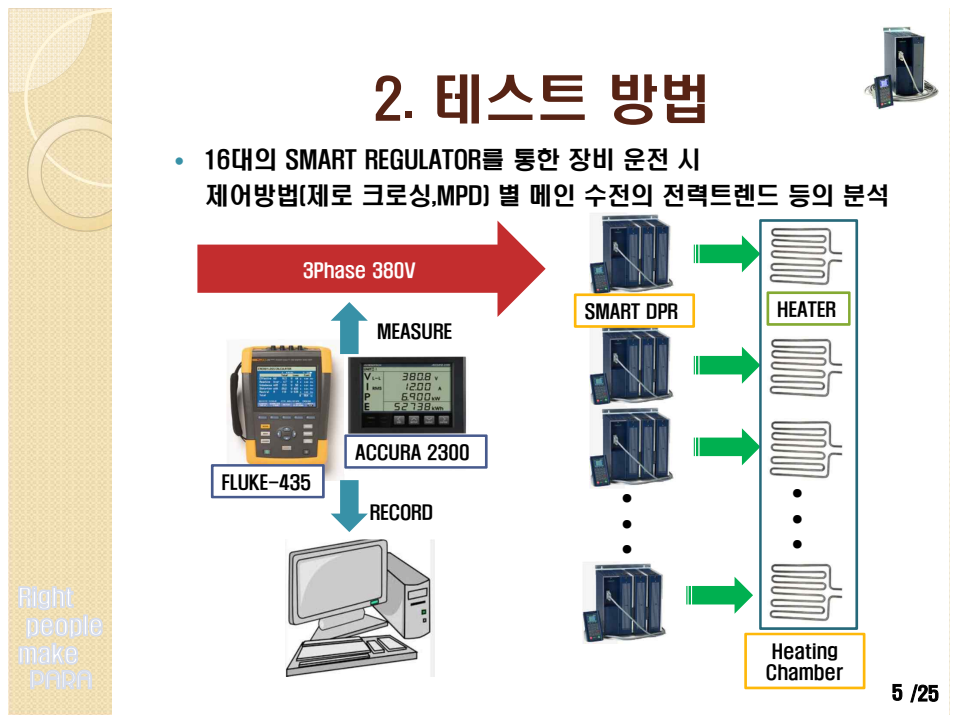
[picture p300: page 5]
3Phase 380V; MEASURE; RECORD; FLUKE-435; ACCURA 2300; SMART DPR; HEATER; Heating Chamber

제어방법(제로 크로싱,MPD) 별 메인 수전의 전력트렌드 등의 분석

# — 상온에서 부터 목표 온도(500℃)까지 승온 및

# 2. 테스트 방법

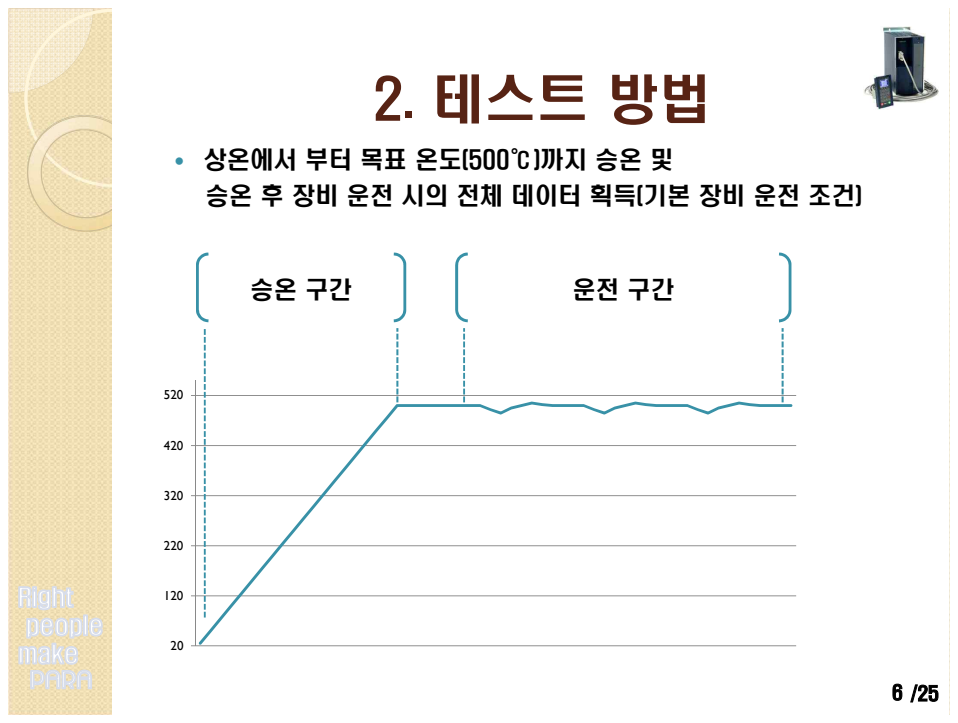
[picture p301: page 6]

승온 후 장비 운전 시의 전체 데이터 획득(기본 장비 운전 조건)

# 2. 테스트 방법

# — 테스트 순서

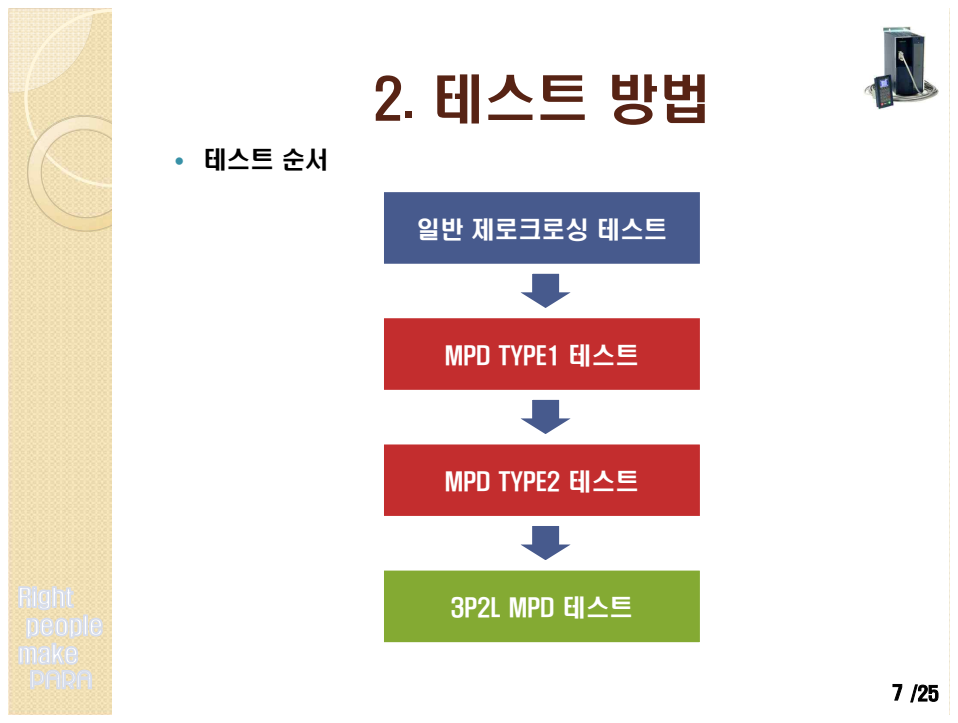
[picture p302: page 7]
MPD TYPE1 테스트; MPD TYPE2 테스트; 3P2L MPD 테스트

일반 제로크로싱 테스트

# — 온도제어 패턴은 동일하게 제어됨

# 3. 테스트 결과 - 온도제어

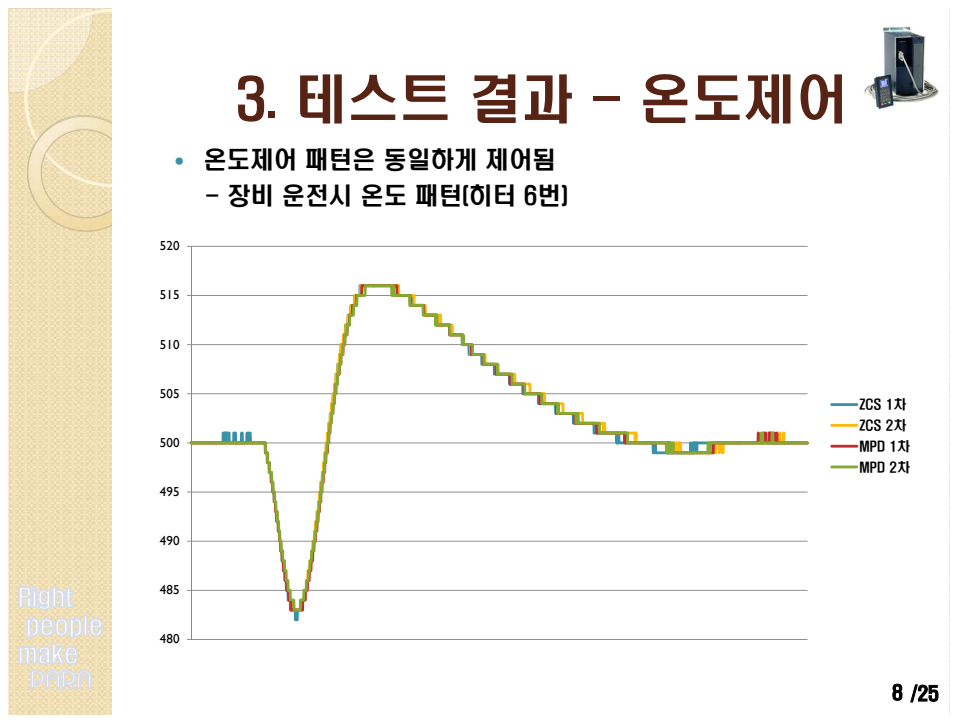
[picture p303: page 8]
ZCS 1차; ZCS 2차; MPD 1차; MPD 2차

- 장비 운전시 온도 패턴(히터 6번)

# — 제로크로싱 / MPD 전력 패턴 비교(전체 패턴)

# 4. 테스트 결과 - 전력

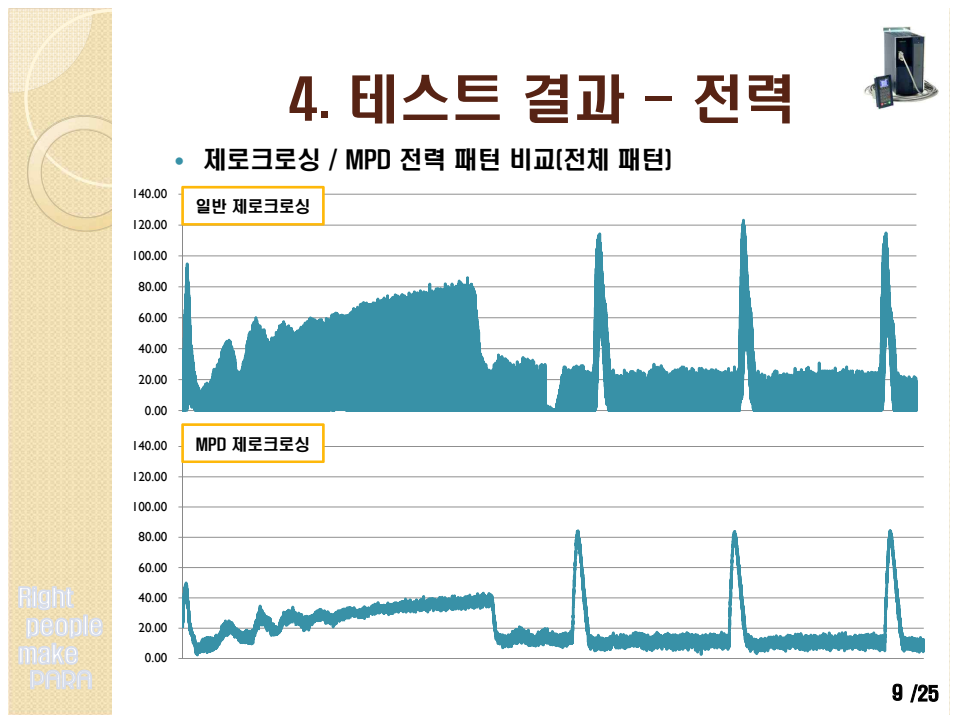
[picture p304: page 9]
일반 제로크로싱; MPD 제로크로싱

# — 제로크로싱 / MPD 전력 패턴 비교(전체 패턴)

# 4. 테스트 결과 - 전력

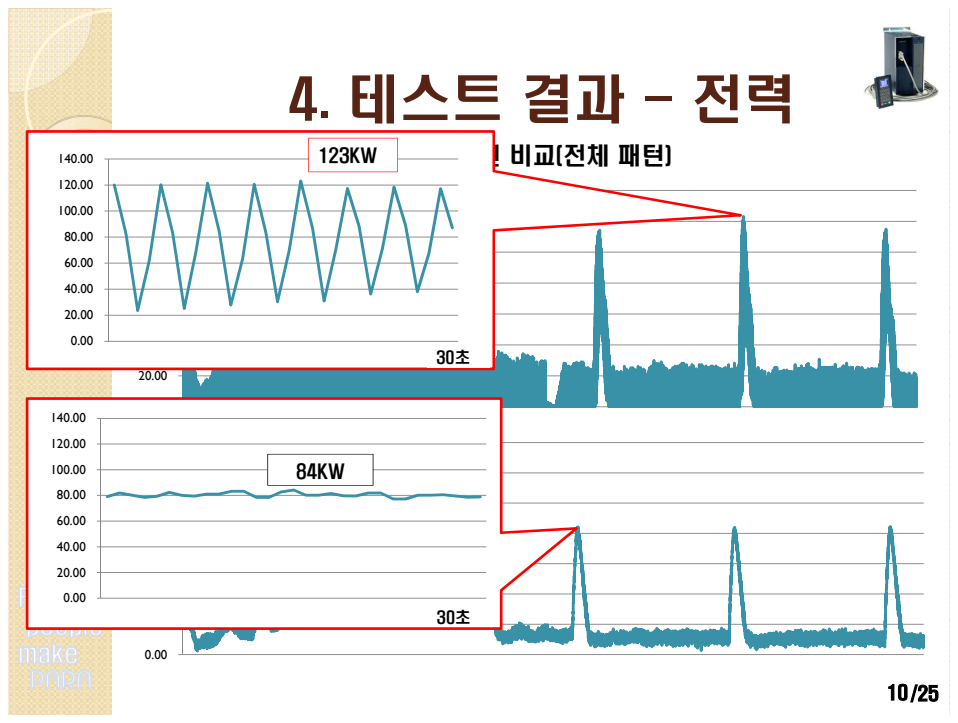
[picture p305: page 10]

# 4. 테스트 결과 - 전력

# — 제로크로싱 / MPD 전력 패턴 비교(운전시 패턴, 10분)

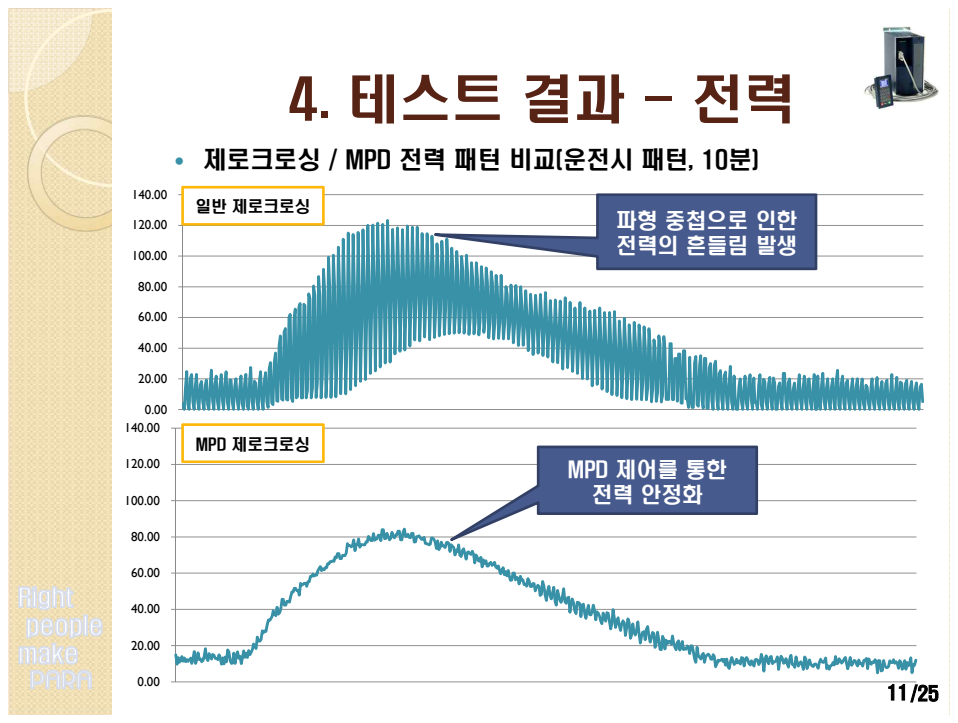
[picture p306: page 11]
일반 제로크로싱; MPD 제로크로싱

파형 중첩으로 인한
전력의 흔들림 발생

MPD 제어를 통한
전력 안정화

# 4. 테스트 결과 - 전력

# — MPD TYPE 별 전력 패턴 비교(운전시 패턴, 10분)

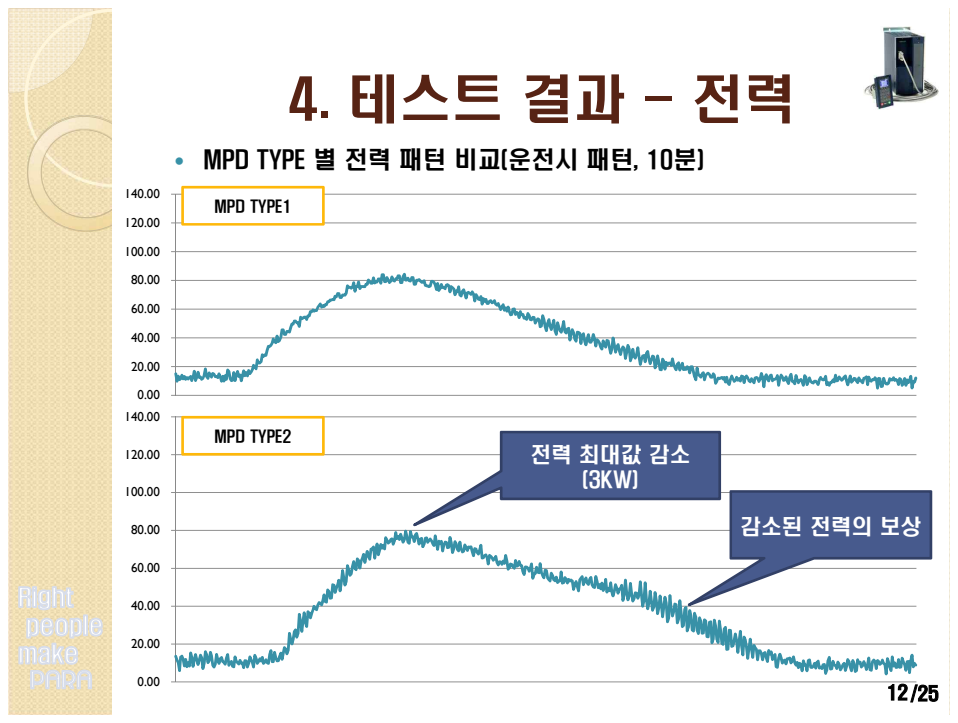
[picture p307: page 12]
MPD TYPE1; MPD TYPE2

전력 최대값 감소

감소된 전력의 보상

# 4. 테스트 결과 - 전력

# — 3P2L 전력 패턴 비교(운전시 패턴, 10분)

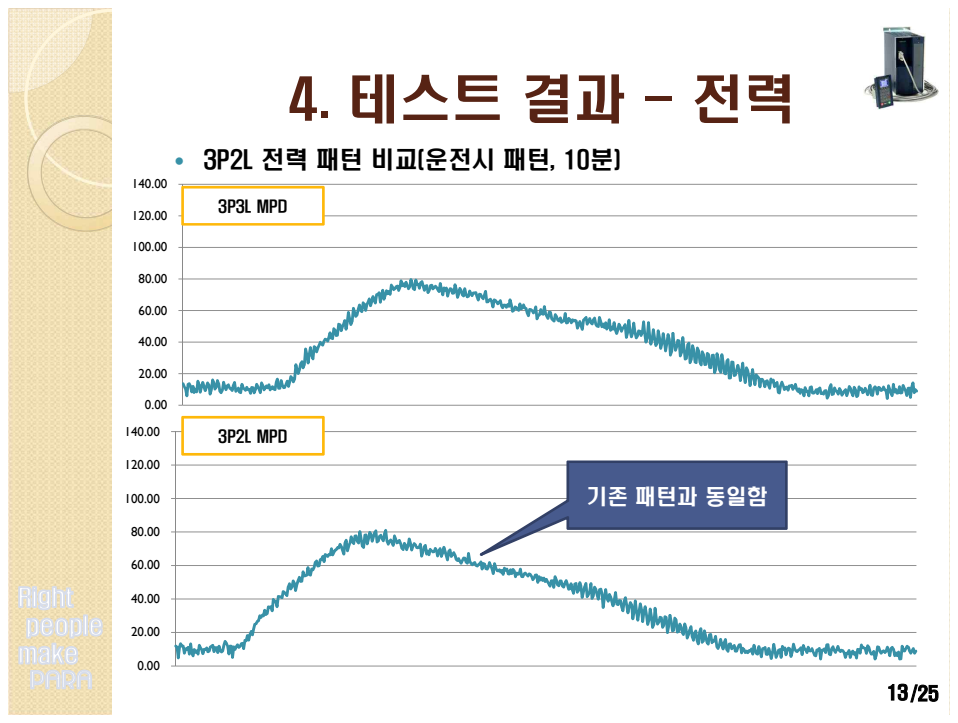
[picture p308: page 13]
3P3L MPD; 3P2L MPD

기존 패턴과 동일함

# 5. 테스트 결과 – 전류

# — ZCS / MPD 전류 패턴 비교(전체 패턴), 200ms Period

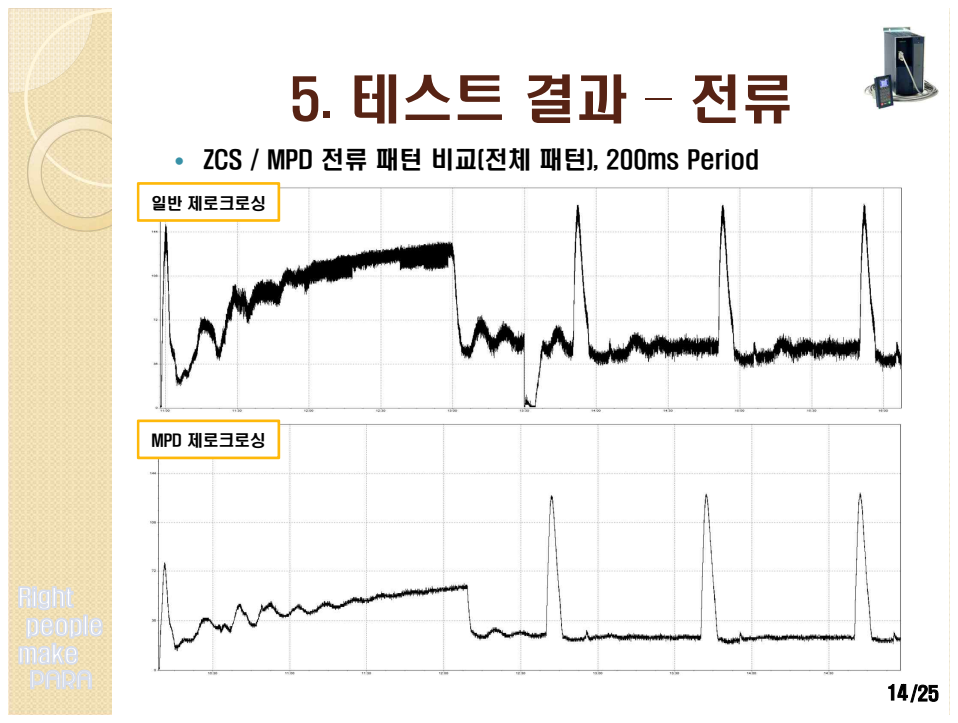
[picture p309: page 14]
일반 제로크로싱; MPD 제로크로싱

# 5. 테스트 결과 – 전류

# — ZCS / MPD 전류 패턴 비교(전체 패턴), 200ms Period

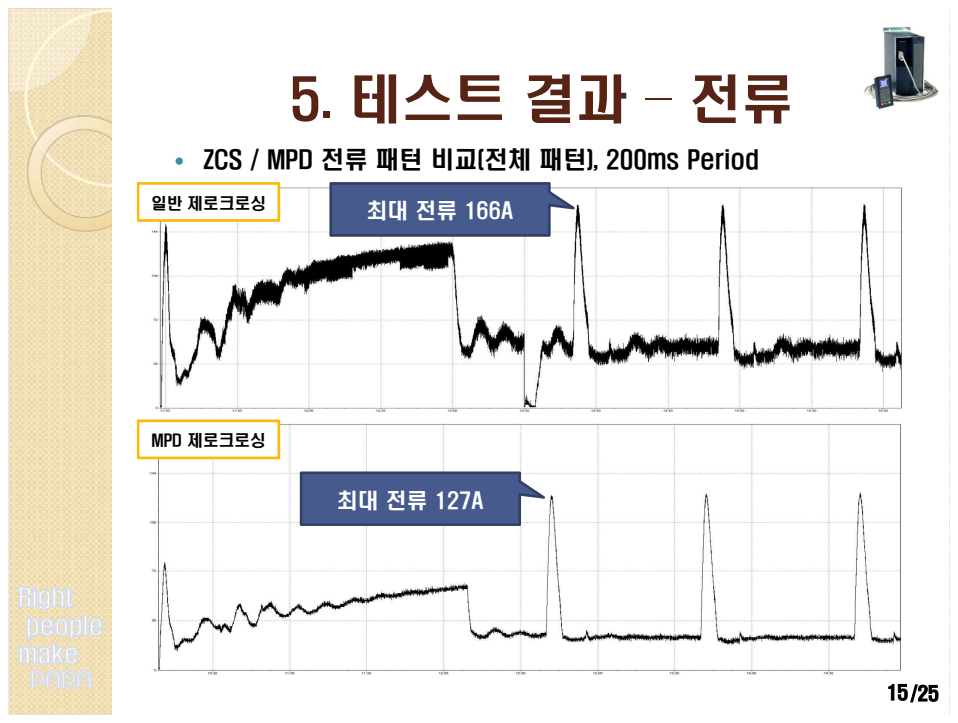
[picture p310: page 15]
일반 제로크로싱; MPD 제로크로싱

# 5. 테스트 결과 – 전류

# — ZCS / MPD 전류 패턴 비교(전체 패턴), 200ms Period

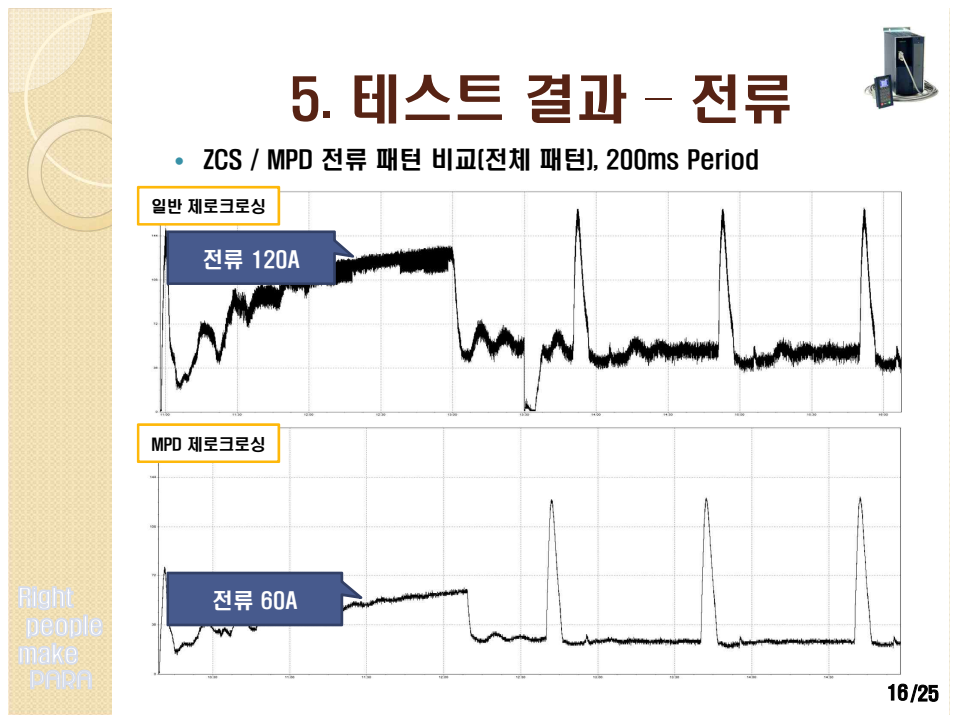
[picture p311: page 16]
일반 제로크로싱; MPD 제로크로싱

# 6. 테스트 결과 – 역률

# — ZCS / MPD 역률 패턴 비교(전체 패턴), 1분 주기 최소값(루텍)

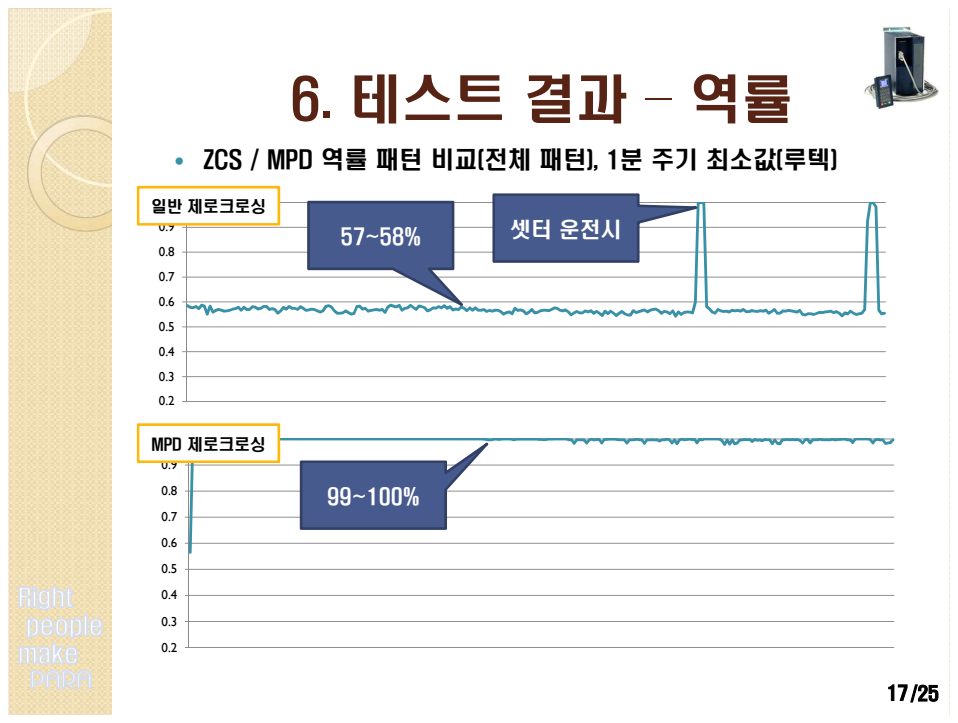
[picture p312: page 17]
제로크로싱; MPD; 셋터 운전시

# 6. 테스트 결과 – 역률

# — ZCS / MPD 역률 패턴 비교(전체 패턴), Fluke-435

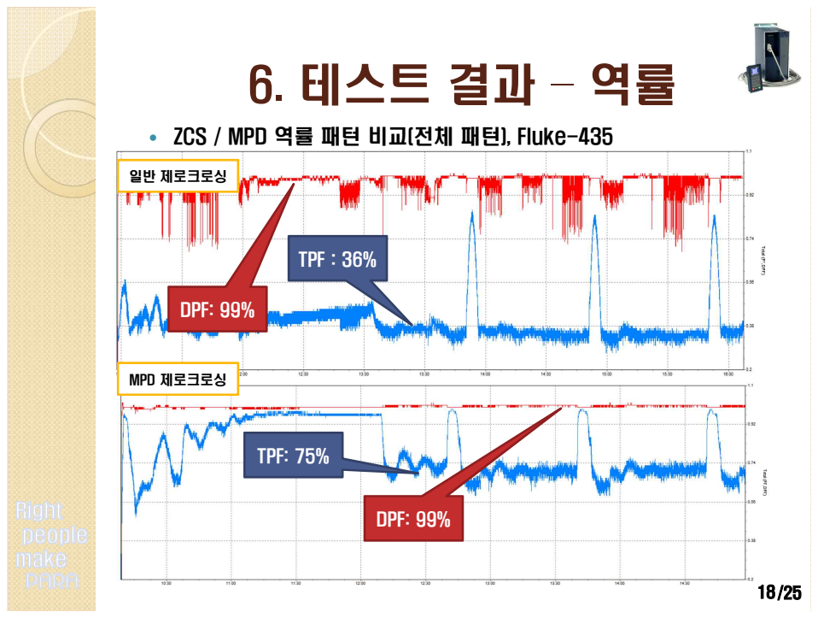
[picture p313: page 18]
일반 제로크로싱; MPD 제로크로싱; TPF : 36%; TPF: 75%; DPF: 99%

# 7. 결과분석

## — 일반 제로크로싱 경우 제어상황에 따라 결과가 달라짐. 일반 제로크로싱 CASE2

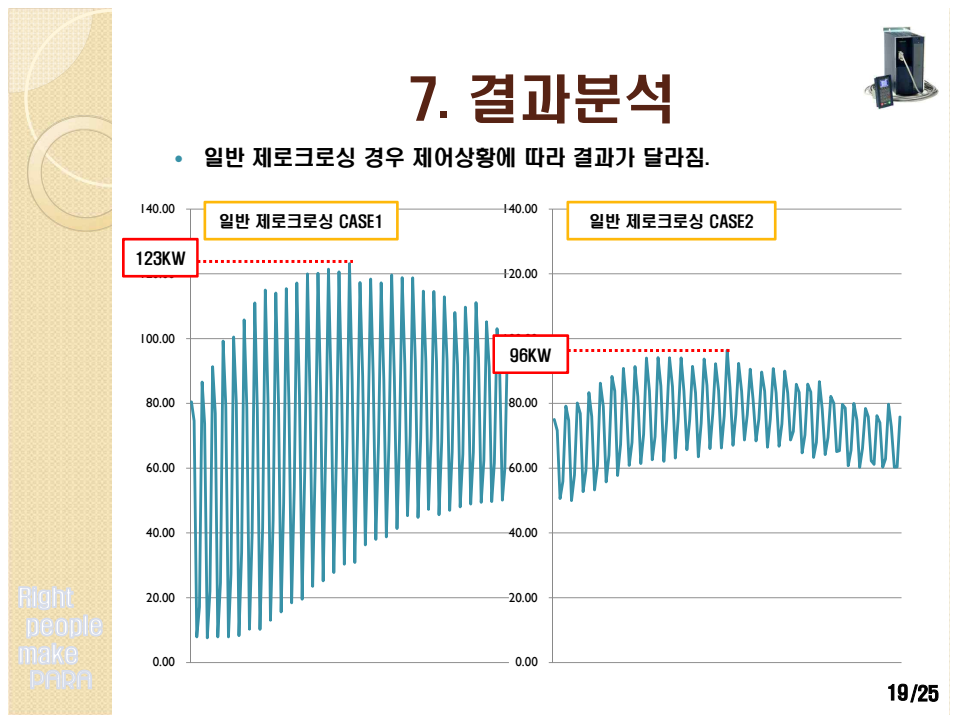
[picture p314: page 19]
일반 제로크로싱 CASE1

# 7. 결과분석

| — 일반 제로크로싱 제어에 대비 최대 전력값 및 전력 헌팅 감소

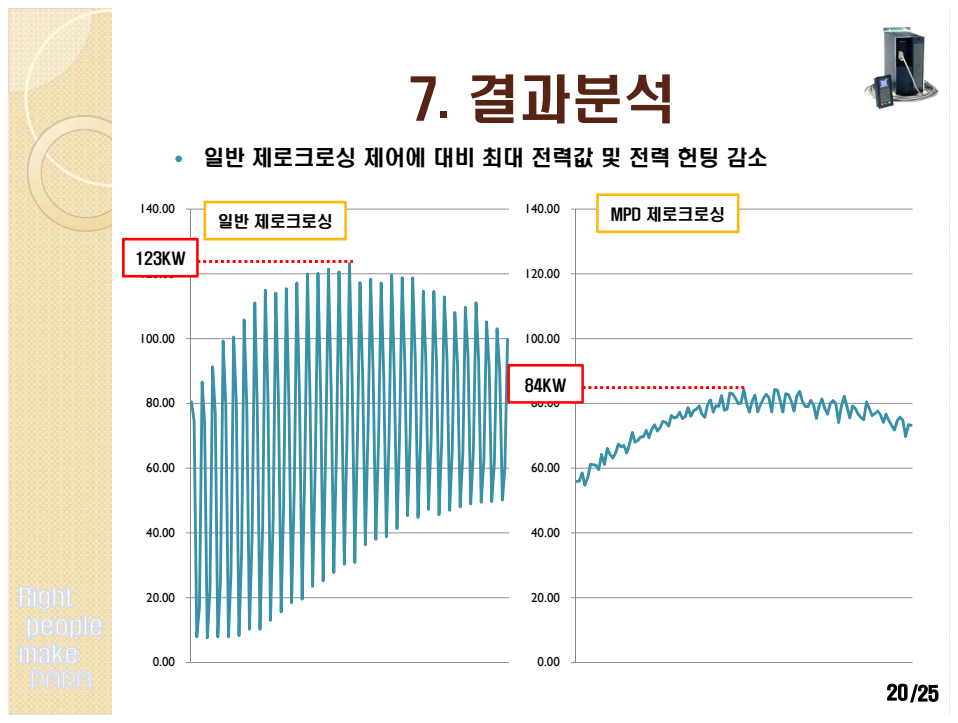
[picture p315: page 20]
MPD 제로크로싱

일반 제로크로싱

# 7. 결과분석

## — MPD 제어시는 일반 제로크로싱 제어의 평균값에 수렴

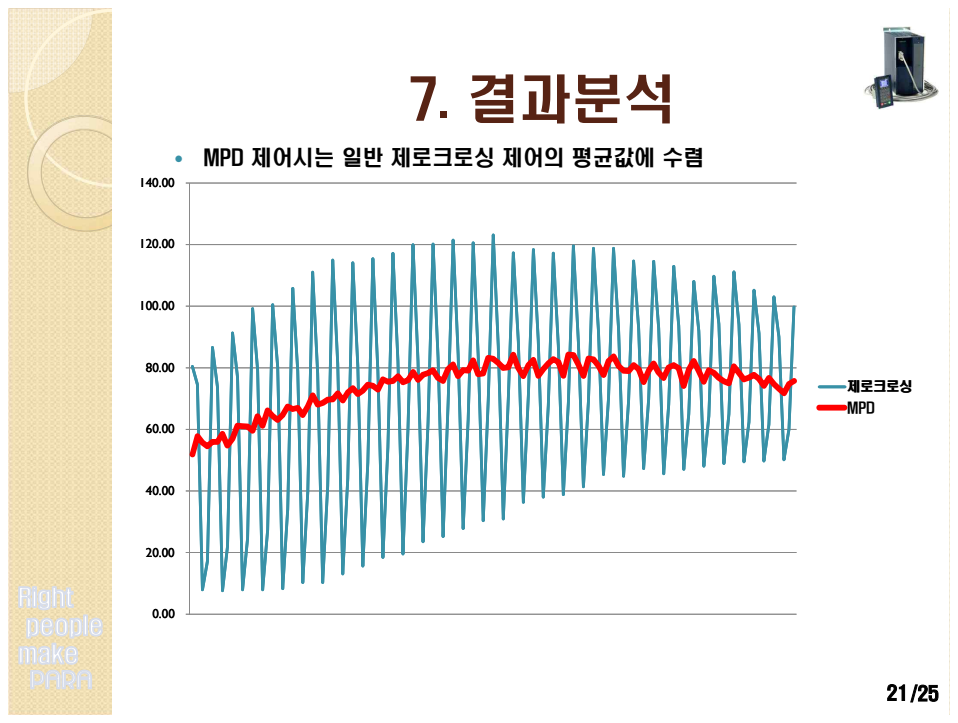
[picture p316: page 21]
제로크로싱; 제로크로싱 MPD

# 7. 결과분석

## — Power Factor(역률) - 유효전력과 피상전력과의 비

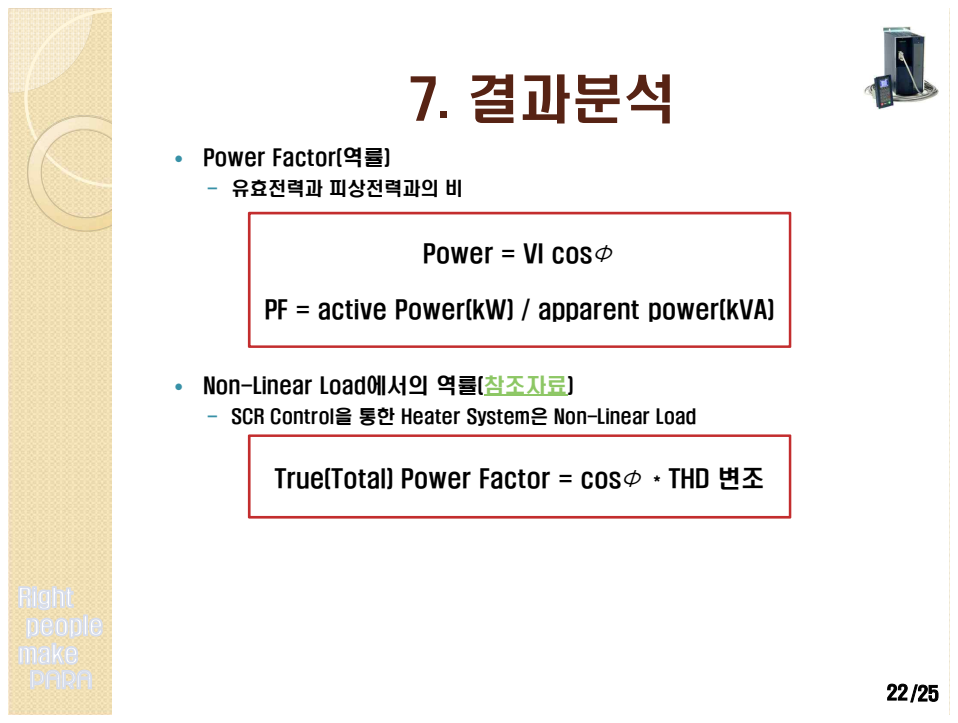
[picture p317: page 22]
Non-Linear Load에서의 역률(참조자료) - SCR Control을 통한 Heater System은 Non-Linear Load

Power = VI cosΦ

PF = active Power(kW) / apparent power(kVA)

True(Total) Power Factor = cosΦ * THD 변조

# 7. 결과분석

## — Power Factor / THD 비교

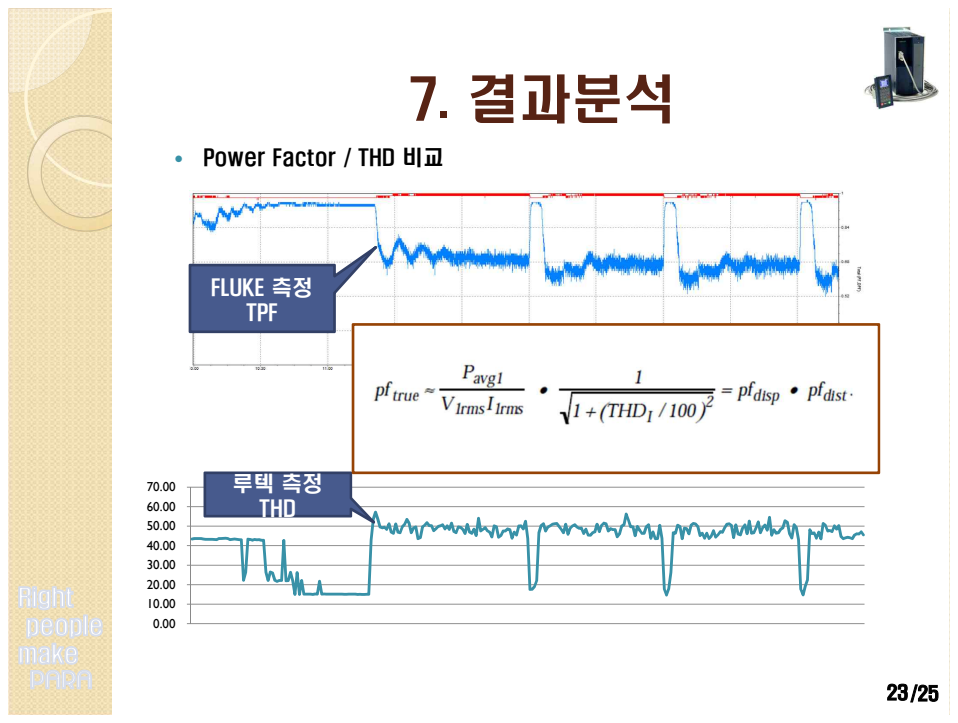
[picture p318: page 23]
THD; FLUKE 측정 TPF

# 7. 결과분석

## — 제어 모드 별 역률 비교

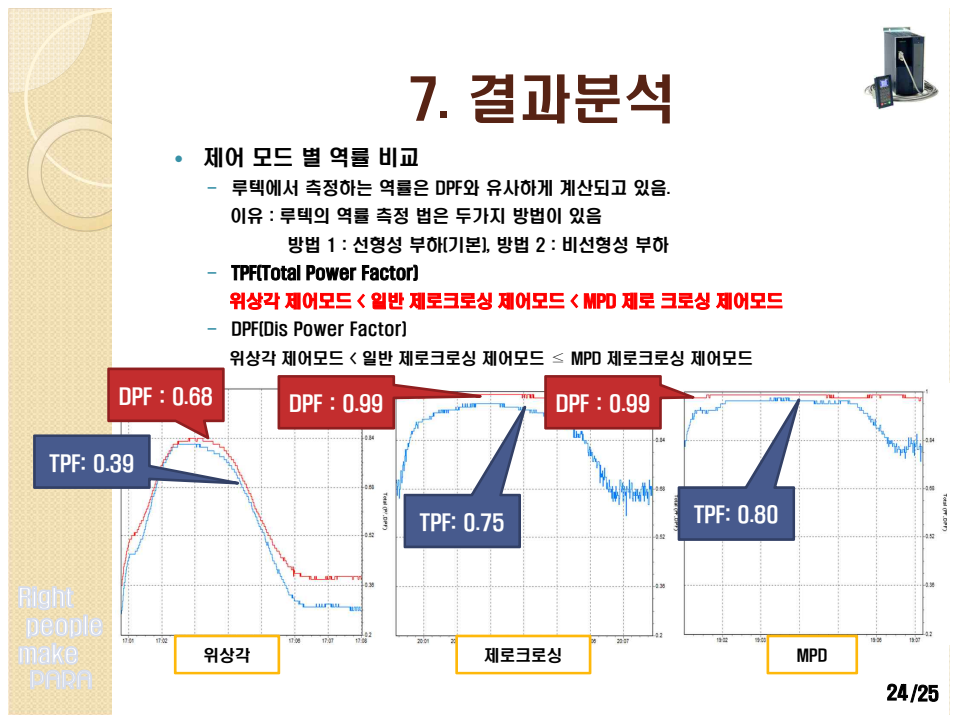
[picture p319: page 24]
위상각; 제로크로싱; MPD; DPF : 0.68; DPF : 0.99; TPF: 0.39; TPF: 0.75; TPF: 0.80

- 루텍에서 측정하는 역률은 DPF와 유사하게 계산되고 있음. 이유 : 루텍의 역률 측정 법은 두가지 방법이 있음

방법 1 : 선형성 부하(기본), 방법 2 : 비선형성 부하

- TPF(Total Power Factor)
위상각 제어모드 < 일반 제로크로싱 제어모드 < MPD 제로 크로싱 제어모드
- DPF(Dis Power Factor)
위상각 제어모드 < 일반 제로크로싱 제어모드 ≤ MPD 제로크로싱 제어모드

# 8. MPD 장점

# — 메인 수전의 전력 최대값 감소 및 전력 헌팅 감소

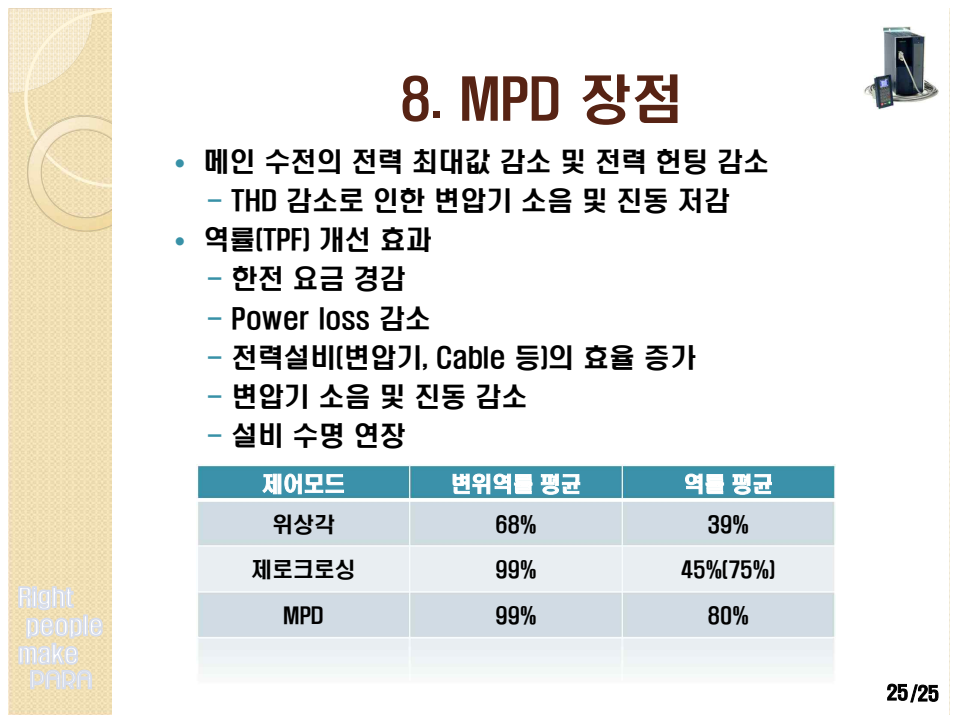
[picture p320: page 25]
제어모드; 변위역률 평균; 위상각; 제로크로싱; MPD

- THD 감소로 인한 변압기 소음 및 진동 저감
— 역률(TPF) 개선 효과
- Power loss 감소
- 전력설비(변압기, Cable 등)의 효율 증가
- 변압기 소음 및 진동 감소
