Joyedo/paraent-website-/(commit log)

2026-05-26 Initial commit: 파라이엔티 홈페이지 v1.0
    - index.html (메인 페이지)
    - pages/ 15개 페이지 (제품, 회사소개, 인증, 문의 등)
    - assets/ 이미지, 인증서, 특허 파일
    - files/ 제품 매뉴얼, 카탈로그, CAD 도면
    [Mini 3상-치수도면.dwg, Mini 단상-Type-20250124.dwg, Multi-Type(구형)-치수도면.dwg, Multi-Type(신형)-치수도면.dwg, SE-Type-치수도면.dwg, SMART-10A-치수도면.dwg, SMART-250A-치수도면.dwg, SMART-400A-치수도면.dwg]
2026-05-26 feat: Supabase 문의 폼 연결 (inquiries 테이블 insert)
2026-05-26 fix: Supabase UMD CDN 경로 수정
2026-05-26 feat: 관리자 페이지 추가 (로그인 + 문의 대시보드)
2026-05-26 feat: 전 페이지 반응형 적용 (햄버거 메뉴 + 모바일/태블릿 레이아웃)
2026-05-26 fix: 모바일 4가지 UI 개선 (푸터 가독성, 다운로드 버튼, 품질 이미지, 자료실 그리드)
    - 모바일 푸터: 브랜드 영역 전체너비, 네비 컬럼 3열 가독성 개선
    - 제품 다운로드 버튼: 아이콘+텍스트 중앙정렬, 패딩/폰트 소형화
    - 품질혁신 이미지: aspect-ratio로 잘림 방지
    - 자료실 CAD 그리드: 인라인 스타일 !important 오버라이드로 1열 처리
2026-05-26 fix: 푸터 컴팩트 레이아웃, 히어로 이미지 잘림 수정, 자료실 테이블 개선
    - 푸터: 브랜드 가로 배치 + nav 2x2 그리드로 컴팩트하게
    - 히어로: min-height 제한 + background-position 68%로 제품 노출
    - 자료실: 날짜 컬럼 숨기기, dl-btn 스타일 개선
2026-05-26 fix: SMART PSD 이미지 균일 크기 수정
    - 3개 이미지 카드에 고정 높이(220px) 래퍼 적용
    - aspect-ratio 제거 → 이미지 크기 불일치 해소
    - object-fit:contain + max-width/max-height로 각 이미지 비율 유지하며 균일하게 표시
    - 모바일: 3열→1열, 이미지 높이 200px/160px로 조정
2026-05-27 fix: 해외규격인증 이미지 경로 수정 (CE/UL 인증서 표시 안되는 오류 해결)
2026-06-02 feat: 영어/중국어 SMART 제품 주문형식에 PSD-1000 화면 다이어그램 추가 및 다국어 페이지 추가
    - EN/ZH SMART 제품 페이지 주문형식 탭에 PSD-1000 디스플레이 화면 구성 이미지 삽입
    - 영어(psd-1000-display-en.png), 중국어(psd-1000-display-zh.png) 이미지 assets에 추가
    - 영어(en/) 및 중국어(zh/) 전체 페이지 최초 추가
    - 품질혁신 페이지 다국어 이미지(quality-inspection-en/zh.png) 추가
    - SMART MPD/PLF 다국어 이미지(images/) 추가
2026-06-02 feat: 관리자 페이지 언어별 문의 구분 기능 추가
    - 문의 폼 3개(ko/en/zh)에 language 필드 저장 추가
    - 관리자 대시보드에 언어별 통계 카드(KO/EN/ZH) 추가
    - 언어 필터 드롭다운 추가 (전체/한국어/영어/중국어)
    - 테이블에 언어 뱃지 컬럼 추가 (국기 + 언어코드)
    - 상세보기 모달에 문의 언어 정보 표시
2026-06-02 fix: 중국어 메인 페이지 히어로 섹션 애니메이션 스크립트 누락 수정
    - 마우스 인터랙션 빛 효과(heroMouseLight) 스크립트 추가
    - 웨이브 캔버스 애니메이션(waveCanvas) 스크립트 추가
    - 영어/한국어 페이지와 동일한 인터렉션 구현
2026-06-02 feat: 모바일 메뉴에 다국어 언어 선택 버튼 추가
    - 햄버거 메뉴 하단에 KO / EN / 中 언어 전환 버튼 행 추가
    - 현재 언어 활성 표시(active) 반영
    - 문의 버튼 href 버그 수정 (.btn-primary 직접 참조)
    - mobile-lang-row / mobile-lang-btn CSS 스타일 추가
2026-06-02 fix: 모바일 언어 버튼 인라인 스타일로 캐시 우회, nav-cta-btn 클래스 호환 추가
    - CSS 캐싱 문제 우회: 언어 버튼에 인라인 스타일 직접 적용
    - zh/index.html의 nav-cta-btn 클래스도 문의 버튼으로 인식하도록 수정
    - active 언어 강조 스타일 인라인으로 즉시 적용
2026-06-03 feat: 관리자 대시보드 문의별 대응 메모 기능 추가
2026-06-03 fix: 메모 저장 시 문의 상태 처리완료 자동 변경 수정
2026-06-12 feat: MULTI 제품 단종으로 전체 홈페이지에서 제거
    - 한국어/영어/중국어 index.html에서 MULTI 히어로 슬라이드, 제품 카드, 네비/푸터 링크 제거
    - 모든 제품 페이지의 네비게이션, 관련제품(related-card), 푸터에서 MULTI 제거
    - inquiry 문의 폼의 제품 선택 옵션에서 MULTI 제거
    - resources 자료실에서 MULTI 매뉴얼 및 CAD 도면 섹션 제거
    - company-overview의 제품 수 7가지 → 6가지로 업데이트
    - product-multi.html 파일 삭제 (KO/EN/ZH 3개)
2026-06-12 fix: 자료실 CAD 도면 MULTI 점프 버튼 제거
2026-06-12 feat: 회사개요 제품군 chip hover 시 제품 이미지 미리보기 추가
2026-06-12 feat: 제품군 호버 애니메이션 및 관련제품 이미지 업데이트
    - company-overview 제품군 섹션: 2:1 비율 카드 + 페이드인 호버 애니메이션
    - 제품군 호버 이미지 6종 추가 (hover-pii/smart/flex/mini/etype/ptype)
    - 핵심기술 1,2,3 호버 애니메이션 복원 (lift + glow + 하단 라인)
    - 각 제품 페이지 함께보면좋은제품 SMART/FLEX 이미지 교체 (smart-card/flex-card)
    - P-TYPE 16년 → 26년 베스트셀러 수정
2026-06-22 feat: 제품 상세 페이지 히어로 섹션 제품 이미지 추가 및 CAD 버튼 자료실 연동
    - 전체 제품 페이지(KO/EN/ZH) 히어로 섹션에 hero-bg 이미지 적용
    - background-size: auto 100%로 이미지 잘림 없이 표시
    - 좌측 텍스트 / 우측 이미지 2단 그리드 레이아웃
    - 좌→우 그라데이션 오버레이로 텍스트 가독성 확보
    - 캐드 다운로드 버튼 클릭 시 자료실 해당 제품 CAD 섹션으로 이동
    - resources.html #cad-PRODUCT 해시 기반 탭 활성화 + 스크롤 로직 추가
2026-06-23 feat: 영문·중문 버전 한국어 기준 동기화 (연도·통계·콘텐츠·CAD·연락처)
    - 연도 25→26, 제품군 수 7→6 전체 반영 (en/zh 공통)
    - PARA-ENT 브랜딩 통일 (Paraent 표기 제거), micom-based·distributor 교체
    - feature-card / pillar-card 호버 애니메이션 CSS 추가 (en/zh 전 제품 페이지)
    - SMART·Pll 오더코드 구조 재편, 특허번호·규격표 추가
    - 자료실 CAD 도면 한국어 기준으로 en·zh 동기화 (Pll 11개, P-TYPE 8개)
    - 전화·팩스 +82 접두사 제거, 문의 이메일 cpmaui@paratec.co.kr로 통일
2026-06-23 feat: 영문·중문 회사개요 핵심기술 애니메이션·제품군 호버 한국어 기준 동기화
    - tech-card hover 애니메이션 추가 (translateY, ::before 그라디언트, ::after 하단 바, tech-num scale 효과)
    - product-chip 팝업 방식 → 인셋 fullcover 방식으로 전면 교체 (aspect-ratio 2/1, 텍스트 fade-out)
    - 제품 이미지 hover-*.png로 교체 (pii/smart/flex/mini/etype/ptype)
    - 제품군 그리드 4열 → 3열로 변경
    - zh products-body 7款 → 6款, Paraent → PARA-ENT 수정
2026-06-23 fix: 제품 페이지 CAD 다운로드 버튼 자료실 앵커 링크로 통일
    E-TYPE·MINI 페이지(KO·EN·ZH)에서 직접 파일 다운로드 토글 버튼 제거.
    모든 제품의 캐드 다운로드 버튼이 resources.html#cad-{product}로 이동하도록 통일.
2026-06-23 feat: MINI·E-TYPE 제품 페이지에 메뉴얼 다운로드 드롭다운 버튼 추가
    SE/TE 또는 1P/3P 메뉴얼을 선택해 개별 다운로드 가능 (한·영·중 공통)
2026-06-23 feat: 회사 개요 핵심기술 카드 호버 시 배경 이미지 표시
    3D 일러스트 이미지를 tech-card 호버 배경으로 추가 (한·영·중 공통)
2026-06-23 fix: 핵심기술 카드 호버 이미지 가독성 개선
    반투명 다크 오버레이 + 흰색 텍스트 적용으로 이미지 위 가독성 확보
2026-06-23 feat: 관련 제품 카드 E-TYPE 이미지 교체
2026-07-01 feat: 푸터 이메일 추가 및 제품/인증 페이지 내용 수정
    - 전 페이지(ko/en/zh) 푸터에 cpmaui@paratec.co.kr 추가
    - 회사개요 핵심기술 연혁·제어방식 문구 수정 (26년간, 마이크로프로세서 기반)
    - 인증현황 PII UL 인증서 순서 및 라벨(ULCA/ULUS) 재정비
    - Pll/MINI/E-TYPE 제어입력 신호 사양에 임피던스 값 추가
    - SMART 히어로 섹션 배경 이미지 교체
2026-07-01 fix: 디자인등록증·상표등록증 이미지 파일 추가
    인증현황 페이지에서 PDF 대신 이미지로 라이트박스 표시하도록 변경했으나
    실제 이미지 파일이 커밋되지 않아 배포 사이트에서 깨져 보이던 문제 수정
2026-07-01 feat: FLEX/SMART/Pll 제품 페이지 개선 및 P-TYPE 사양 보완
    - FLEX 제품 카드 이미지를 다른 제품처럼 확대·정렬
    - SMART 핵심기술 카드에 호버 이미지·앵커 링크 추가, 결선표 라벨 보강
    - Pll 핵심 장점 카드에 호버 이미지 다크닝 효과 적용
    - P-TYPE 제어입력 신호 사양 보완
    - FLEX/MINI/SMART 히어로 뱃지에 인증 정보 추가
2026-07-17 feat: 제품 페이지 다국어 동기화, PSD-2000 탭 분리, CAD 자료 정리
    - PII 주문코드 RS/EN/RT 표기 통일, SMART PSD-2000 독립 탭 신설, E-TYPE CE 인증 배지 추가를 영문/중문 페이지에도 반영
    - P-TYPE 핵심기술(FND), 정격전류 목록, 출력범위 섹션 삭제 등 정리
    - MINI 주문코드 4단계 구성으로 재정비 (한/영/중)
    - 품질혁신 페이지 이미지 잘림 수정 (object-fit: contain)
    - P-TYPE CE DoC 인증서 이미지 교체 (SZ/SPP, TZ/TPP 정정)
    - PII·MINI 최신 CAD 도면(STEP/DWG) 교체 및 신규 모델 추가
    [MINI-단상-15A_25A_외형도_3D.step, MINI-단상-40A_외형도_3D.step, MINI-삼상-25A_외형도_3D.step, MINI-삼상-40A_70A_외형도_3D.step, Mini 단상-Type-20250124.dwg]
2026-07-21 fix: keep-supabase-alive 워크플로우 들여쓰기 수정
2026-07-22 fix: P-TYPE TZ/TPP CE DoC 인증서 이미지 서명본으로 교체
2026-07-22 fix: 중국어(zh) 페이지 누락 콘텐츠 보완
    - index.html: 푸터 이용약관/개인정보처리방침 링크 추가
    - product-mini.html: 안전성·정밀성·편의성 섹션 전체 번역 추가
    - resources.html: SMART CAD 도면 250A~320A, 400A~500A 카드 추가
2026-07-22 fix: 위상각/제로크로싱 제어방식 비교 기술자료 PDF 추가
    KO/EN/ZH 자료실 페이지에서 깨져있던 다운로드 링크(tech-phase-zerocross.pdf)를 채워넣음.
2026-07-29 feat: 자료실·공지사항 관리자페이지 CMS 추가 (Supabase 연동)
    자료실(기술자료/메뉴얼/캐드도면/카다로그)과 공지사항을 관리자페이지에서
    실시간으로 등록·수정·삭제할 수 있도록 Supabase DB + Storage 기반으로 전환.
    파일은 관리자페이지에서 직접 업로드 가능. 기존 정적 콘텐츠는 DB로 이관.
    (한국어 페이지 우선 적용, en/zh는 기존 정적 상태 유지)
2026-07-29 feat: 자료실·공지사항 다국어(EN/ZH) Supabase 연동
    en/zh 자료실·공지사항 페이지를 정적 콘텐츠에서 Supabase 동적 조회로 전환
    (language 컬럼 기준 필터링). 관리자페이지(자료실/공지사항 관리)에 언어
    선택 탭 추가 — 한국어/영어/중국어 콘텐츠를 각각 등록·수정·삭제 가능.
2026-08-05 fix: 중문판 시안 피드백 반영 및 자료실 스크롤 버그 수정
    - 온라인 문의 이메일을 jeffcsc616@paratec.co.kr로 전체 변경 (zh)
    - 언어 선택 메뉴 '中' 표기를 'CN'으로 통일 (한/영/중 전체)
    - 한글판 GNB 드롭다운 메뉴에만 있던 밑줄 제거 (text-decoration 누락)
    - CAD 도면 링크 클릭 시 엉뚱한 위치로 스크롤되던 자료실 해시 스크롤
    레이스 컨디션 수정 (한/영/중 resources.html)
    - 중문 마케팅 용어 1:1 교체 (功率调节器→电力调整器, 订购代码→型号索引 등)
2026-08-06 fix: 자료실 파일 업로드 시 특수문자 파일명 오류 수정
2026-08-06 chore: GitHub Pages 재배포 트리거
2026-08-06 ci: GitHub Actions 기반 Pages 배포 워크플로우 추가
2026-08-06 chore: GitHub Actions Pages 배포 트리거
2026-10-01 fix: 메인페이지 Pll 제품 라벨 대문자 변환 오류 수정
2026-10-01 fix: Supabase 프로젝트 삭제 사고 복구 - 신규 프로젝트로 전체 연동 교체
    기존 프로젝트(ttrxqfrzzwyrpgiyjwix)가 장기 pause 후 삭제되어
    신규 프로젝트(yqabxdmhwfdjjvvtuutt)로 URL/anon key 일괄 교체
2026-10-01 chore: Pll 캐드도면 STEP→DWG 교체 (SPII/TPII 신규 도면, AC/DC 구분 추가)
    2024-11-18/2025-05-07 재작성된 DWG 도면으로 기존 STEP 도면 10종 교체,
    SPII-025 DC전원 변형 신규 추가
    [SPII-A-025_070_외형도.step, SPII-A-025_AC_외형도.dwg, SPII-A-025_DC_외형도.dwg, SPII-A-090_110_외형도.step, SPII-A-090_외형도.dwg, SPII-A-130_외형도.dwg, SPII-A-250_320_외형도.step, SPII-A-250_외형도.dwg]
2026-10-01 fix: 모바일에서 안 줄어들던 인라인 이미지/카드 그리드 반응형 수정
    SMART 제품페이지(결선구성표, PLF/PSD 갤러리 등)와 인증현황 페이지
    (CE/ISO/기타인증 카드)의 인라인 style 그리드가 클래스 미적용으로
    기존 responsive.css 규칙에 안 걸려 모바일에서 3~4열 그대로 유지되던
    문제 수정. KO/EN/ZH 3개 언어 전부 영향받던 버그.
2026-10-01 fix: Pll 표기 전체 대문자 변환 잔여 수정 + 모바일 히어로 텍스트/사진 겹침 수정
    - en/zh 메인페이지 제품카드 라벨, 자료실 캐드도면 그룹 헤더(ko/en/zh)에
    남아있던 text-transform:uppercase로 인한 "PLL" 표기 수정
    - 메인 히어로 캐러셀 + 제품상세 히어로: 모바일에서 텍스트가 풀너비로
    늘어나며 배경 제품 사진과 겹쳐 보이던 문제 — 텍스트 영역에 반투명
    패널(blur) 배경을 추가해 사진과 명확히 분리
2026-10-01 fix: 모바일 히어로 패널 방식 되돌리고 그라데이션+사진축소로 재수정
    이전 커밋에서 추가한 반투명 블러 패널이 텍스트 많은 제품상세 히어로에서
    전체 영역을 뒤덮어 제품 사진이 거의 안 보이는 문제 발생. 패널 제거 후:
    - 전체 배경 그라데이션 어둡기 강화 (박스 없이 전체톤 다운)
    - product-hero 배경 사진 크기 축소(34%) + min-height 제거로 사진이
    텍스트에 안 가려지고 작은 포인트 그래픽으로 보이게 조정
    - 텍스트에 text-shadow 추가로 가독성 보강
2026-10-01 chore: responsive.css에 캐시 무효화 파라미터(?v=2) 추가
    모바일 브라우저가 CSS를 강하게 캐시해서 방금 배포한 수정사항이
    반영 안 되고 예전 버전이 계속 보이는 문제 방지. 앞으로 CSS 수정 시
    이 버전 번호를 올려주면 즉시 반영됨.
2026-10-01 fix: 모바일 히어로 — 배경사진 대신 타이틀/사진/설명 세로 레이아웃으로 전면 변경
    기존 방식(어두운 그라데이션으로 배경사진 위 텍스트 가독성 확보)은
    근본적으로 텍스트와 사진이 겹치는 구조라 모바일에서 계속 문제 발생.
    모바일(≤767px)에서는 배경 이미지를 완전히 끄고, 제품 카드에서 쓰던
    깨끗한 제품 컷아웃 이미지(assets/images/products/*.png)를 타이틀과
    설명 사이에 별도 요소로 삽입 — 겹침 가능성 자체를 구조적으로 제거.
    적용 범위: 메인 히어로 캐러셀(index.html ko/en/zh, 슬라이드 6개씩)
    + 제품 상세 6종 x 3개 언어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
2026-10-01 chore: responsive.css 캐시 버전 v=3으로 갱신 (히어로 레이아웃 수정 반영)
2026-10-01 fix: 모바일 히어로 제품사진 배경 티 안 나게 블렌드 처리
    assets/images/products/*.png 가 투명 누끼가 아니라 어두운 스튜디오
    배경이 박힌 사진이라, 페이지의 단색 배경과 경계가 도드라져 보이던
    문제 — mix-blend-mode:multiply로 배경을 페이지 배경에 자연스럽게
    흡수시킴. (투명 누끼 버전은 pll/smart/ptype 3종만 존재하고 파일이
    12MB대라 모바일용으로 부적합해 사용 안 함)
2026-10-01 fix: 메인 히어로 원복 + 제품상세 사진을 배경없는 버전으로 교체
    - 메인페이지 히어로 캐러셀(ko/en/zh)은 오늘 변경분 되돌리고 원래
    방식(배경사진 + 그라데이션 오버레이)으로 복원
    - 제품상세 페이지 모바일 사진은 Pll/SMART/P-TYPE 세 제품에 한해
    투명배경(누끼) 원본을 모바일 사이즈로 리사이즈해 새로 추가
    (pll-hq-mobile.png 등, 12MB대 원본을 150~330KB로 축소)
    - FLEX/MINI/E-TYPE은 투명배경 소스 자체가 없어 기존처럼
    mix-blend-mode(.blend-dark 클래스)로 배경을 흡수시키는 방식 유지
2026-10-01 style: 메인페이지 Zaram 레퍼런스 참고해 디자인 리프레시 1차
    - 제품 그리드(6가지 디지털 전력조정기) 카드를 사진 위 그라데이션+
    텍스트 오버레이 스타일로 전면 개편 (화이트 카드 하단 설명 → 사진
    자체에 타이틀/태그라인/링크가 얹히는 방식), 4열→3열 그리드로 변경
    - 네비게이션 메뉴 텍스트를 대문자+자간 넓힌 스타일로 조정
2026-10-22 chore: 네이버 서치어드바이저 사이트 인증 메타태그 추가
2026-10-22 chore: 네이버 사이트 인증 코드 교체
2026-10-22 feat: 검색엔진용 sitemap.xml, robots.txt 추가
2026-10-22 feat: 메인페이지 title·description·OG 메타태그 추가
2026-10-22 feat: 파비콘 추가 및 메인 하단 이미지 lazy loading 적용
2026-10-22 feat: JSON-LD 구조화 데이터 추가 (Organization·WebSite·WebPage)
2026-10-22 feat: 전 페이지 SEO 최적화 (title·description·OG·hreflang·Product/Breadcrumb JSON-LD, 다국어 사이트맵)
2026-10-22 chore: 구글 서치콘솔 사이트 인증 메타태그 추가
2026-10-28 fix: 관리자 캐드도면 그룹명 대문자 변환 제거 (PLL → Pll 표기)
2026-10-28 feat: 온라인 문의 파일 첨부 기능 추가 (KO/EN/ZH, 관리자 다운로드·삭제 연동)
    - 문의 폼에 첨부파일 최대 5개(파일당 10MB) 업로드
    - 비공개 Storage 버킷 inquiry-files, inquiries.attachments(jsonb) 컬럼
    - 관리자 목록 첨부 표시, 상세보기 서명 URL 다운로드, 문의 삭제 시 파일 삭제
2026-10-28 feat: 온라인 문의 접수 시 관리자 메일 알림 Edge Function 추가
    Database Webhook(inquiries INSERT) → inquiry-notify → Resend로 cpmaui@paratec.co.kr 발송.
    service_role 호출만 허용해 anon 키로는 실행 불가.
2026-10-28 fix: 메인 메타 설명 PLL → Pll 표기 통일
